kaefe64/Arduino_uSDX_Pico_FFT_Proj/README.md

# ARJAN-5
## 5 Band SSB/AM/CW HF Transceiver
## by Klaus Fensterseifer - PY2KLA
### (based on Arjan te Marvelde / uSDR-pico)

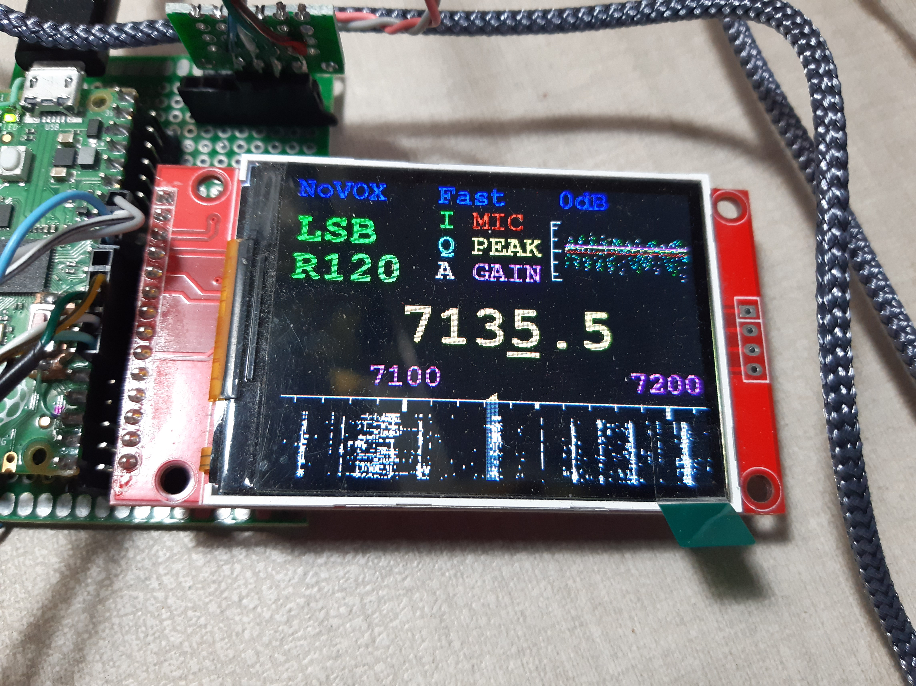
[picture p1: Pictures/Pict1.png]
uSDR-PICO FFT


This project is a Software Defined HF Radio Transceiver (QSD/QSE SDR), 5 Band, Low Power, based on  Arjan te Marvelde / uSDR-pico, from https://github.com/ArjanteMarvelde/uSDR-pico.<br>

My intention was to include a Waterfall/Panadapter to the Arjan's uSDR-Pico project. For this, I included an ILI9341 240x320 2.4" TFT display, without touch, and also, changed the software to generate the Waterfall.

Initially, I used Visual Studio, like the original project, but after some considerations, I ported all code to Arduino IDE. So, to compile and run this code you need the Arduino IDE installed for a Raspberry Pi Pico project (see "Arduino IDE setup and notes:" below).

I also, chose not to change the original software as much as possible, and focused on the Waterfall implementation, mostly in the dsp.c.<br>

I started this project based on Arjan's version https://github.com/ArjanteMarvelde/uSDR-pico/blob/main/package/CODEv2.zip from 2021 with documentation at https://github.com/ArjanteMarvelde/uSDR-pico/blob/main/doc/uSDR%20-%20v2.02.pdf .<br>
<br>

## uSDX project (PE1NNZ)

This project, Arjan-5 and uSDR-Pico **DO NOT USE** the uSDX Amplitude/Phase for transmission like the PE1NNZ uSDX project.

Even so, I adapted the TX modulation code (only TX) using Amplitude/Phase from PE1NNZ uSDX project to run at RP2040. It is a separate code, just for test. See it at uSDX_TX folder.

I used the word "uSDX" instead of "uSDR" to name some files. This was a mistake. My intention was to follow Arjan's project with the same names.
<br>

## Basic connections for initial tests
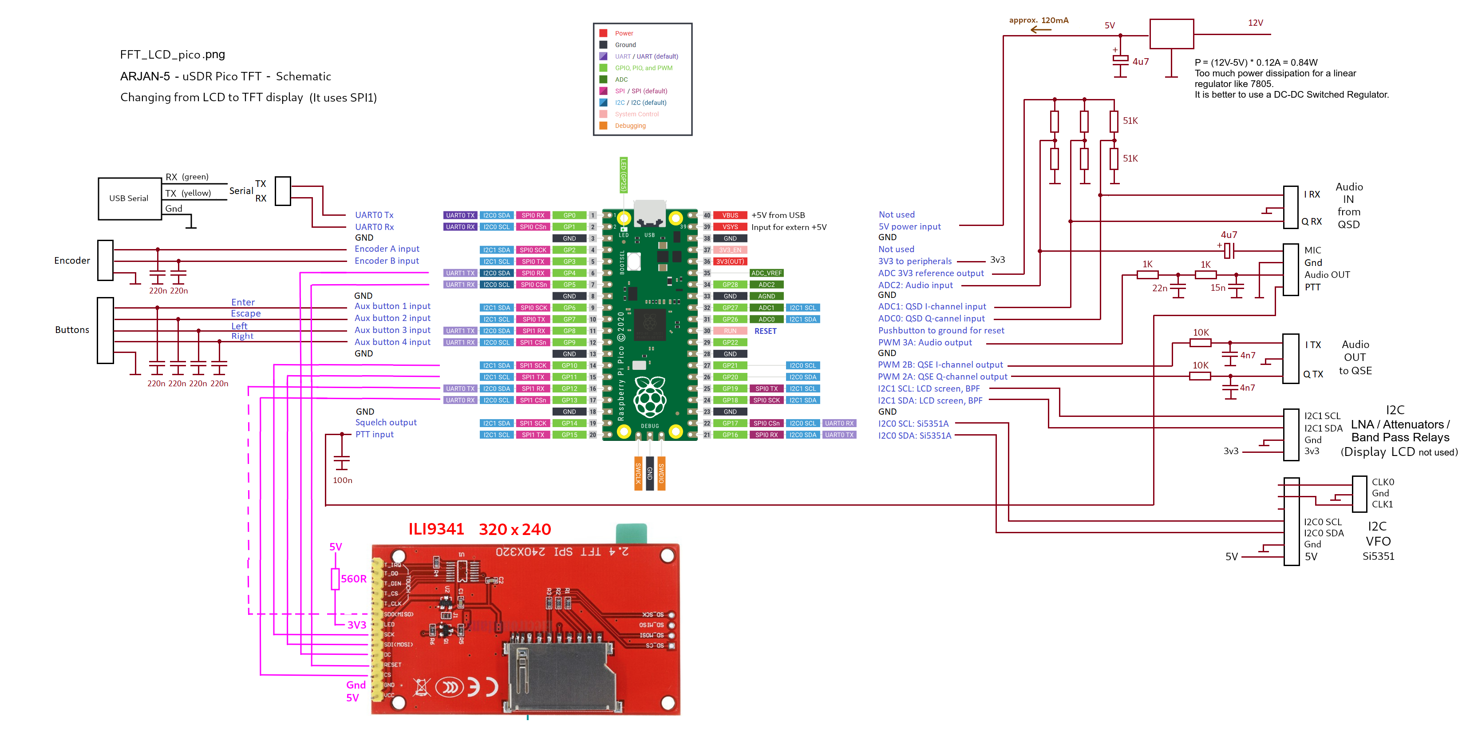
[picture p2: Pictures/FFT_LCD_pico.png]

<br>

Initial tests video:  https://youtu.be/0zGAnkRjizE<br>
AGC and Visual Scope video: https://youtu.be/BiaS002xZfw<br>
Transmission test video: https://drive.google.com/file/d/1Rr4CVPphtcBfMTgRN5z8F7xxByQ_1ybG/view<br>

There are also some messages related to this project at:<br>
https://groups.io/g/ucx<br>
Subject: uSDR-pico on GitHUB<br>
Initial msg: #15923 · May 26  2022<br>
<br>

## Repository folders
**Arduino_I2C_BPF_RX** - Code to control the Band Pass Filter (BPF) board. It runs at Arduino Pro Mini, compiled with Arduino IDE. The Arduino Pro Mini is used replacing the uSDR-Pico I2C interfaces PCF8574's to allow extra features: SWR reading, Eeprom memory and others (future). It uses the same I2C protocol, as uSDR-Pico.<br>
**Arduino_uSDX_Pico_FFT** - Main code for Ajan-5, it runs at Raspberry Pi Pico, compiled with Arduino IDE (look "Arduino IDE setup and notes" below).<br>
**Aux** - Files used as reference.<br>
**PCB** - Schematic and PCB Layout on Kicad format.<br>
**Pictures** - Pictures in general used in this Readme file.<br>
**uSDX_TX** - Code to test RF modulation TX using Amplitude/Phase, the same method used at the PE1NNZ uSDX project (https://github.com/threeme3/usdx) running at RP2040, only for transmission.<br>
<br>
<br>

## Main Board Block Diagram
- Arjan-5 uses the same modules connections as uSDR-pico.

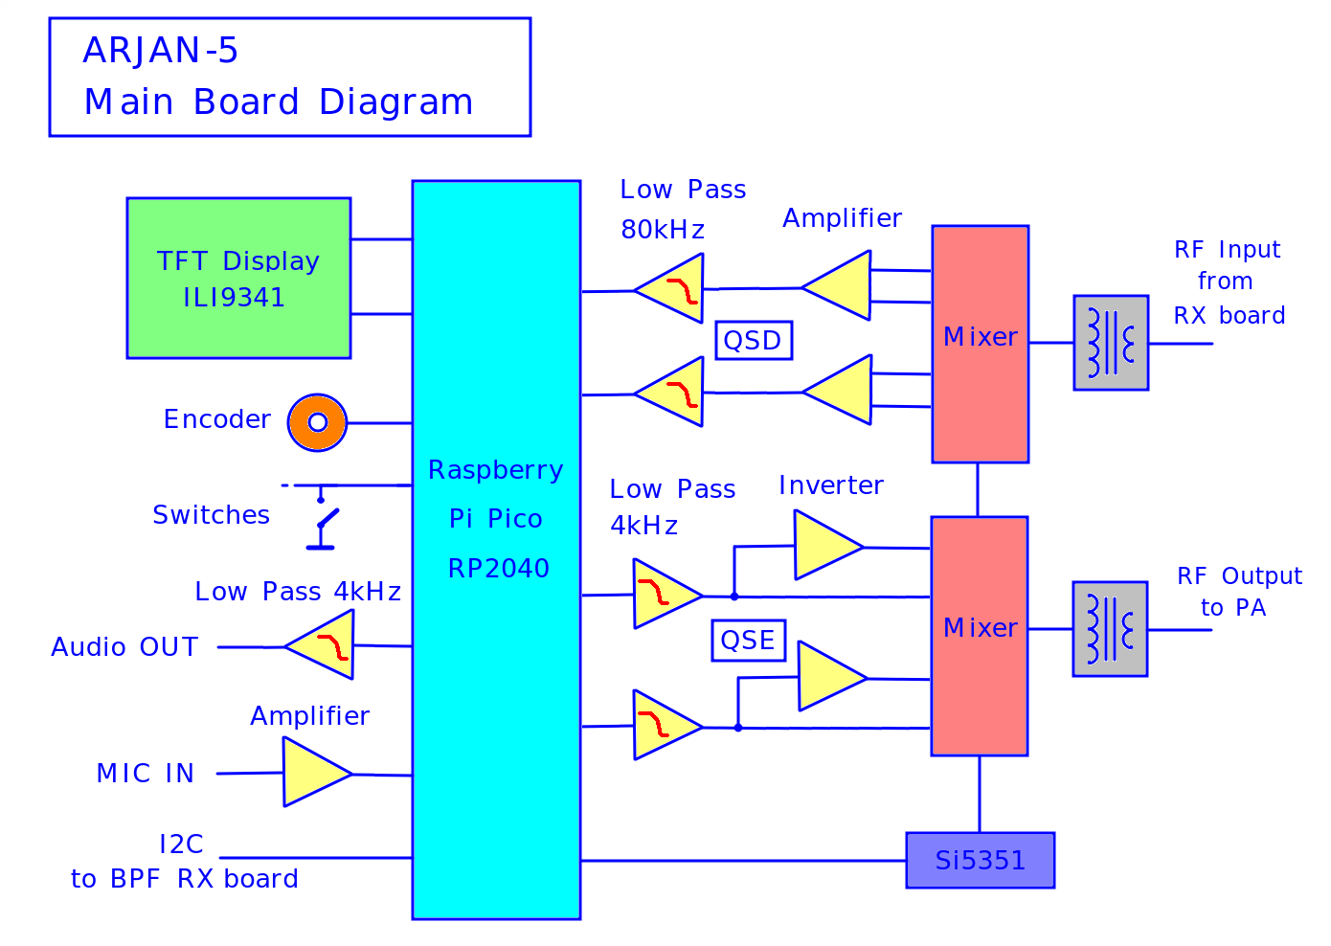
[picture p3: Pictures/Arjan_5_block_diagram.png]
Main Block Diagram

<br>

## Band Pass Filters, Attenuators and Low Noise Amplifier Board Block Diagram
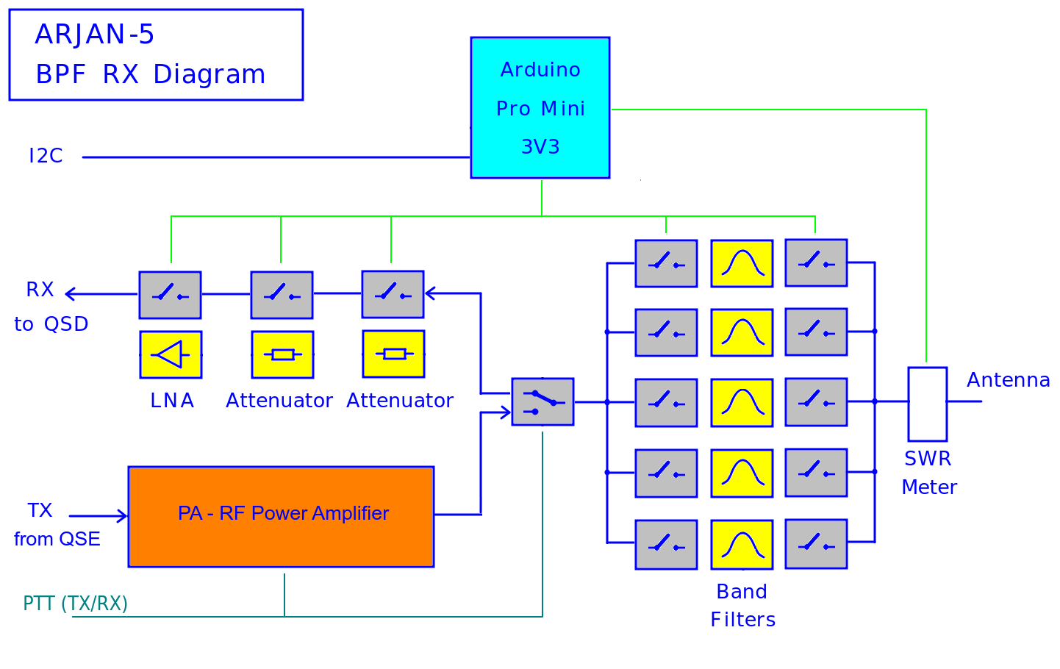
[picture p4: Pictures/Arjan_5_BPF_RX.png]
BPF RX Block Diagram

<br>

## Main Board Top and Botton

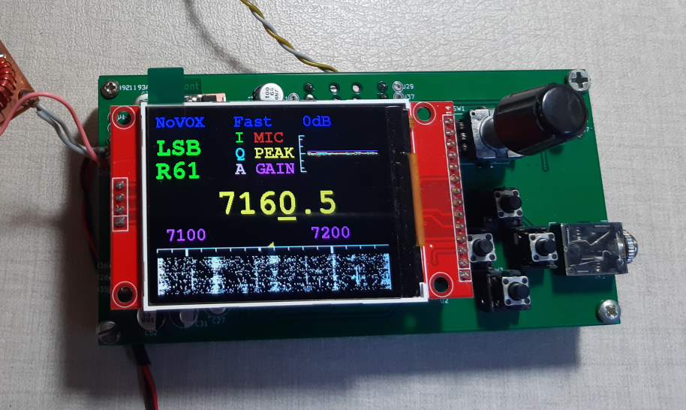
[picture p5: Pictures/uSDR_Pico_FFT_PCB_top.png]
Main Board Top

<br>
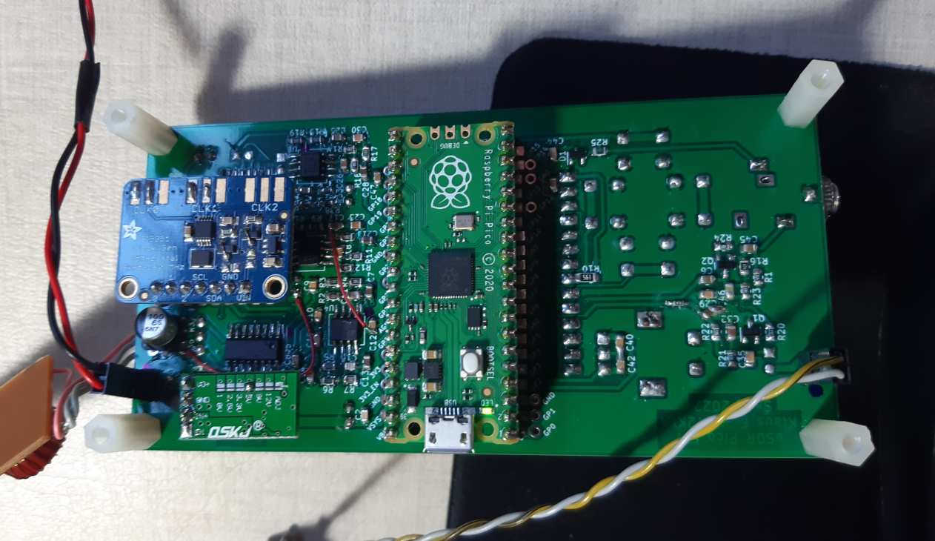
[picture p6: Pictures/uSDR_Pico_FFT_PCB_botton.png]
Main Board Botton

<br>
Obs.: Don't mind the red wires on the PCB, they are only test for separated 5V power supply.
<br>

## First Prototype with TX and RX

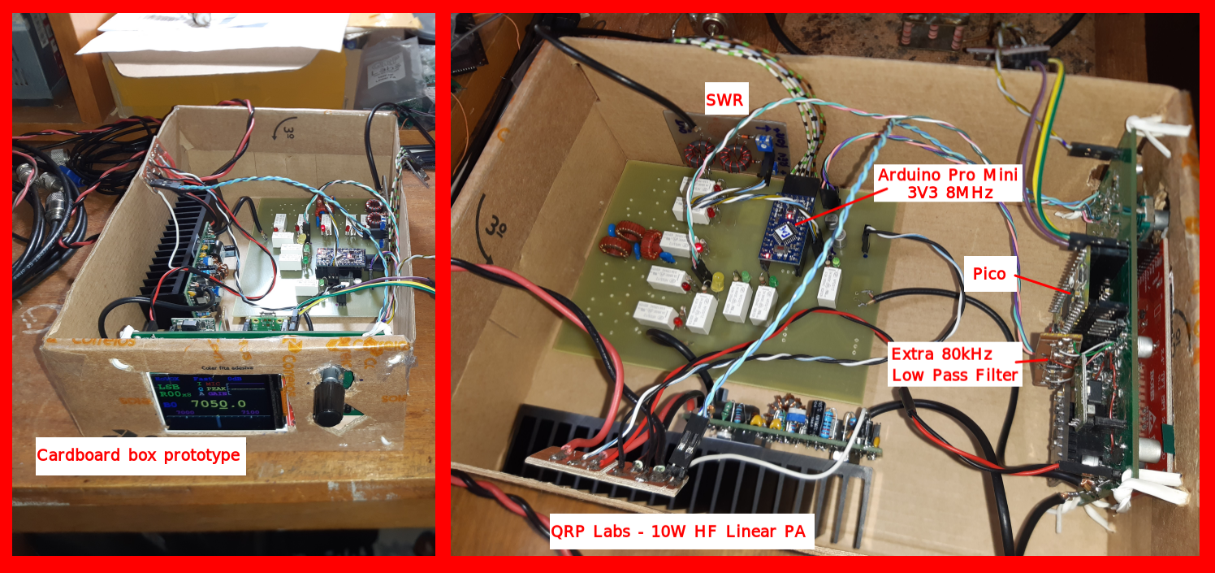
[picture p7: Pictures/Cardboard_box_prototype.png]
Prototype


## Second Prototype (all in a metallic box)

Prototype2

<br>

## Microcontroller RP2040 notes:
- Core0 and Core1 are too much connected and affect each other. This made me lose some painful hours...
- There are only 3 ADC ports available.
- There are some reports at internet about the low quality of the RP2040 ADC readings (https://pico-adc.markomo.me/).

## Hardware changes from the original SDR-Pico and notes:
- I chose to make a main board with the Pico, Display, QSD/QSE and 5V power supply, and another board with the relays, filters and attenuators.
- The main change from SDR-Pico is the inclusion of ILI9341 on Pico free pins, using SPI1, and removing the LCD display.
- We need more frequency range on RX to show at the Waterfall, the RX amplifier must amplify at least 80kHz of signal band. The opamp must be changed to one with wider bandwidth.
- I will use an Arduino Pro Mini to work as two I2C slaves, replacing the PCF8574's on the BPF RX board. This will give more ADCs to read the SWR values.
- You can see the schematic diagram at [uSDR_Pico_FFT_SCH.pdf](PCB/uSDR_Pico_FFT_SCH.pdf) and [uSDR_Pico_BPF_RX_SCH.pdf](PCB/uSDR_Pico_BPF_RX_SCH.pdf).
- I noticed that changing the signal in one ADC input, changed the other inputs signal through the resistors for setting half Vref. To solve this, I changed the circuit to have a separate resistor divider for each ADC input.

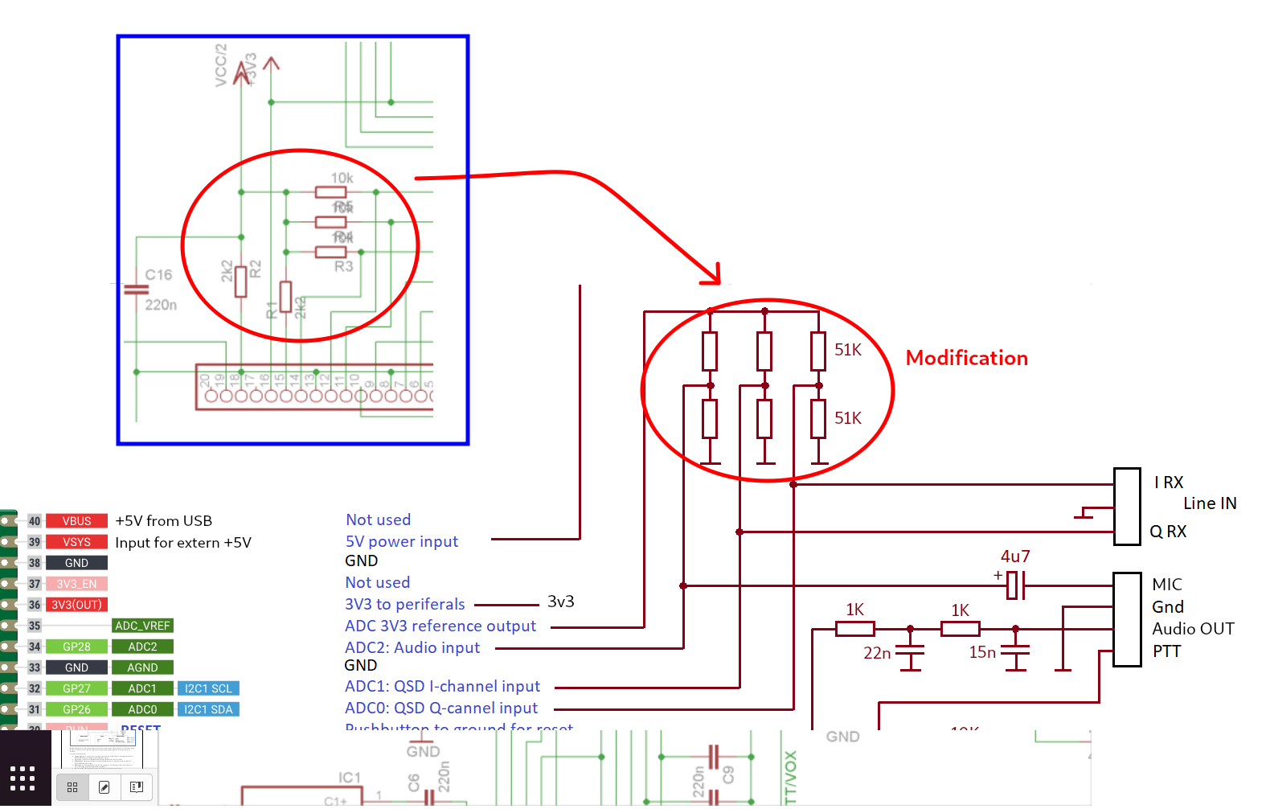
[picture p8: Pictures/FFT_LCD_pico_MOD.png]

<br>

- Use input/output filters for ADC Aliasing considerations (see below). 
- Obs.: at the initial test video, I used only the RC output filter shown in the schematic, and for input filter, only what is already inside of the Softrock RXTX Ensemble.
<br>

## Hardware changes from initial version of my Schematic and PCB:
- Include a reversion VCC connector protection = series diode D2
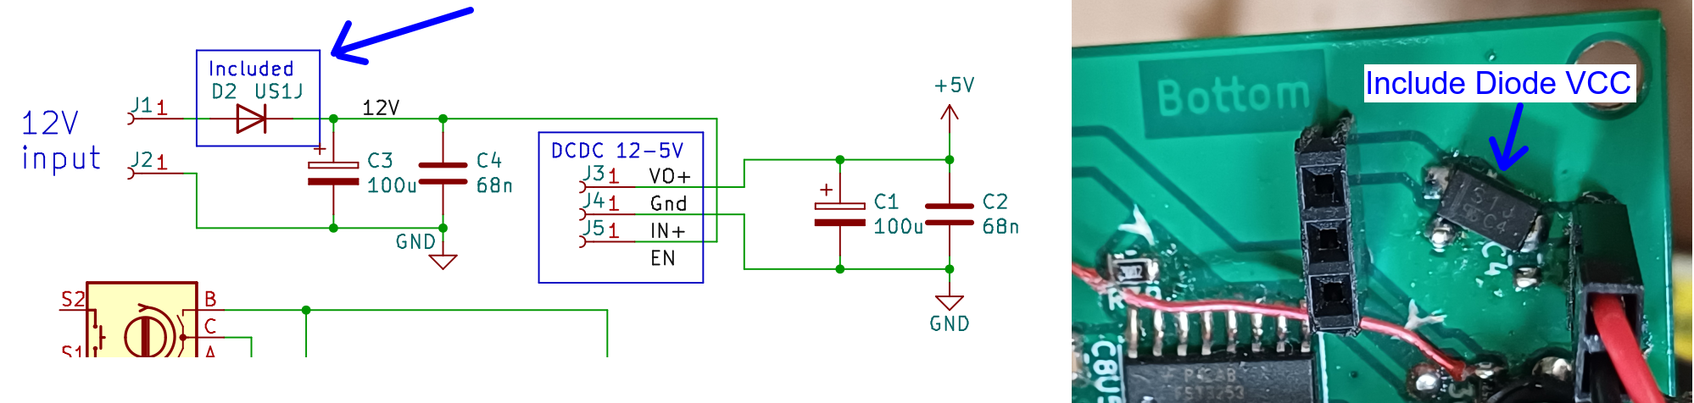
[picture p9: Pictures/Mod_include_diode_Vcc.png]
Diode_VCC


- Include an extra RC to the audio output filter  
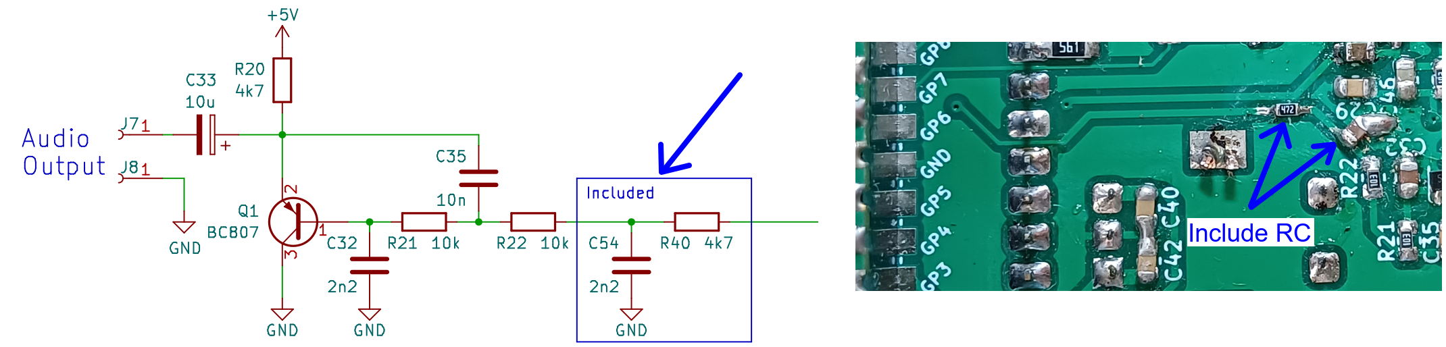
[picture p10: Pictures/Mod_include_RC_audio.png]
RC_audio


- The PTT output signal generated on GPIO15 (pin 20) used to switch the filters and the Power Amplifier needs:  
    A transistor to convert from 3v3 to 12V (2N7002 Q4 on picture).<br>
    Include a 1K resistor (R47 on picture) between GPIO15 (pin 20) and 3V3 (pin 36). The GPIOs on Pico are input with a weak pulldown during reset and this would make it to be like PTT ON and transmit. This 1k resistor pullup will pit the GPIO at high high at reset avoiding transmiting.<br>
    Increase the value of C44 from 1n to 100n, for helping in debouncing the PTT switch.<br>
    Reduce the value of R25 to 10R. This resistor will (try to) limit the current in case of PTT at wrong voltage.<br>
    ** Values changed **, see bellow. <br>
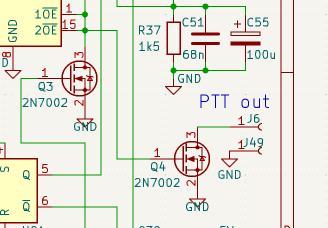
[picture p11: Pictures/PTTout.png]


- Use 5V or 3v3 to power the ILI9341 display depending on your display version.<br>

- Mod Oct04 2026<br>
  Split the PTT signal on PTT_IN and PTT_OUT to allow extra time on CW TX. It will stay on TX for 200ms after the end of CW carrier.<br>
  Increase the resistor R25 on PTT_IN to 470R to protect the input from negative voltage and current.<br>
  Increase the resistor R47 pullup on GPIO15 to 10k to guarantee low level at GPIO15 when PTT = 0.<br>
  Resistor R58 changes to 4k7 to assure the high level after RPI reset.<br>
  Changes marked on blue:<br>
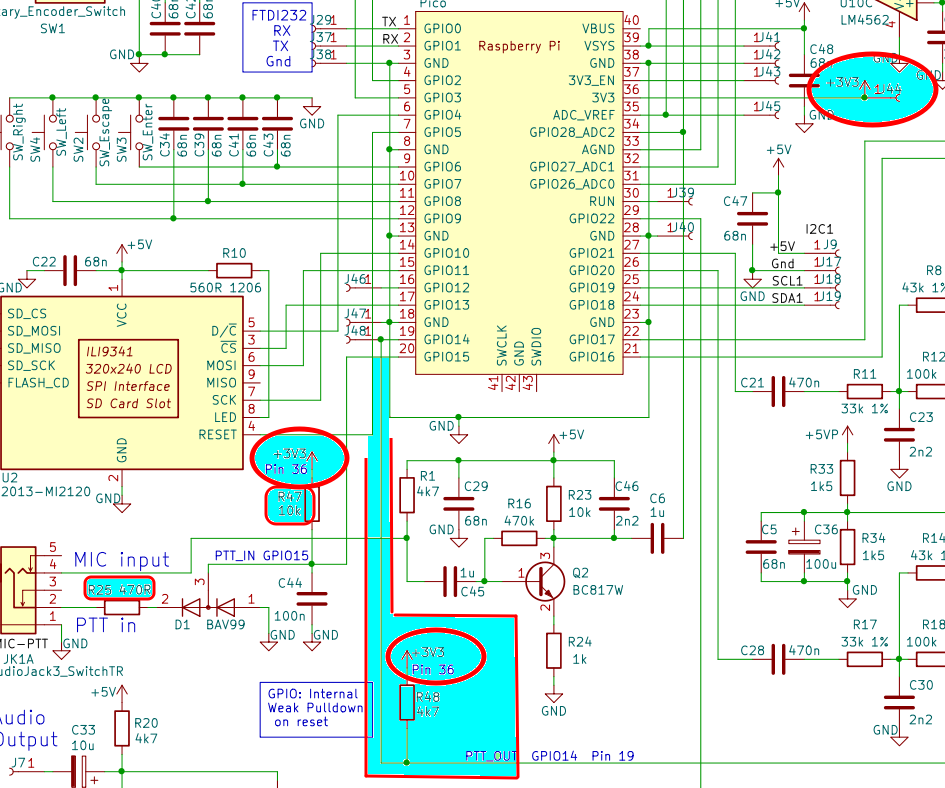
[picture p12: Pictures/PTT_CW.png]

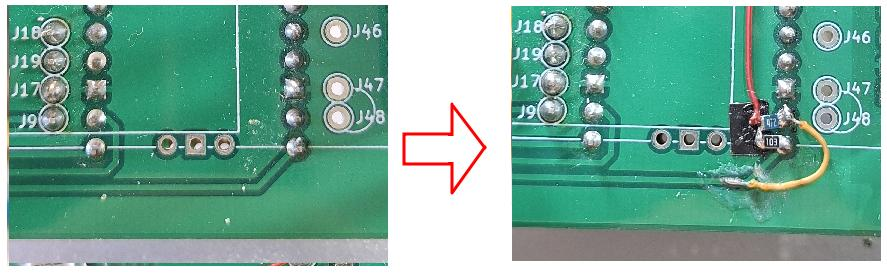
[picture p13: Pictures/PTT_PCB_Mod.jpg]

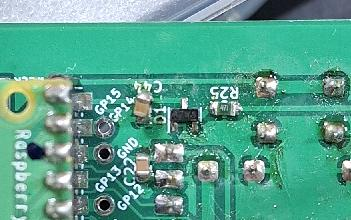
[picture p14: Pictures/PTT_PCB_Mod2.jpg]

<br>
- Mod Oct25 2026<br>
  Changing the MIC amplifier Vcc from 5V to 3V3 to avoid ADC saturation and interference on I/Q ADC.<br>
  I also reduced the MIC audio band frequency to reduce the >8kHz signals with C46 from 2n2 to 4n7.<br>
  
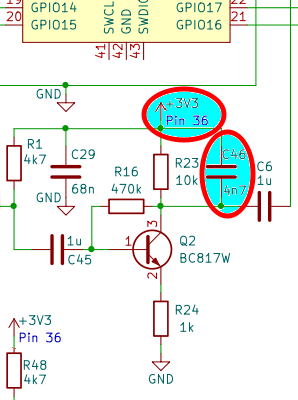
[picture p15: Pictures/MIC_Ampl_Vcc.png]
MIC_ckt


<br>

## Software Notes<br>
### Arduino IDE setup and notes:
- I am using Arduino IDE version 2.3.10 in Linux/Debian
- **IMPORTANT: Use the comments at beginning of  Arduino_uSDX_Pico_FFT.ino  file to "adjust" the library files to the project.**
- Every time I update the library, I need to "adjust" the library files again.
- Use Boards Manager: "Raspberry Pi Pico/RP2040/RP2350" by Earle F. Philhower III
- (old: ~~Boards Manager:  Arduino Mbed OS RP2040 Boards. My version is 4.0.2~~ - no longer used)
- (old: ~~Do not include EarlePhilhower library (it is conflitant with Mbed)~~ - now it uses EarlePhilhower library)
- Board: "Raspberry Pi Pico"  >  Raspbery Pi Pico/RP2040/RP2350  >  Raspberry Pi Pico
- (old: ~~Board: "RaspberryPiPico"  >  Arduino Mbed OS RP2040 Boards  >  RaspberryPiPico~~ - no longer used)
- Lib used: TFT_eSPI by Bodmer
- The code files have cpp type, but the code itself is in C (cpp type is used to help in some compiler issues).

### To implement the Waterfall I considered this:

- There are 3 ADC inputs: I, Q and MIC  (if we remove the VOX function, we could remove the MIC ADC during reception, this will increase the ADC frequency for I and Q, improving the frequencies we can see at the display,or we can increase the >80kHz signal filter rejection - for now I will keep it like the original).
- The max ADC frequency is 500kHz, I have changed it to 480kHz (close to the original) to make the divisions "rounded".
- The ADC for audio reception has frequency of 16kHz (close to the original). I have tested higher frequencies, but the time became critical, without so much benefit.
- The max ADC frequency for each sample = 480kHz / 3 = 160kHz   (because there is only one internal ADC used to read the 3 inputs in sequence).
- With 160kHz of samples, we can see 80kHz range after the FFT, but applying Hilbert to get the lower and the upper band, we get two bands of 80kHz, above and below the center frequency.
- There is no time to process each sample at 160kHz and generate the "live" audio, so I use this method:
    Set the DMA to receive 10 samples of each ADC input (10 x 3 = 30) and generate an interrupt.
    So, we get 16kHz interrupts with 10 x 3 samples to deal.<br>
    For audio, we need only one sample at each interruption of 16kHz. At this point, there is a low pass filter to remove any frequency above 8kHz.<br>
    For FFT, we need all samples (raw samples), so they are copied to a FFT buffer for later use.
- There is also no time to process the samples and run the audio receiver part at 16kHz, so I chose to split it. The interrupt and buffer/filter part is done at Core1, and the audio original reception is in the Core0.
- Every 16kHz interrupt, after filtering the I, Q and MIC, these samples are passed to Core0 to follow the audio reception tasks.
- For the Waterfall, when we have received 320 I and Q samples, it stops filling the buffer and indicates to the Core1 main loop to process FFT/Hilbert for a new graphic line.
- The original processes run at Core0, every 100ms.
- There is a digital low pass filter FIR implemented at the code (like the original) that will give the passband we want for audio.
  This filter was calculated with the help of this site:  http://t-filter.engineerjs.com/
  The dificulty is that the number of filter taps can not be high (there is no much time to process it), so the filter must be chosen carefully.
- Please consider that this Waterfall is not perfect, I had to let go of some rules to make it.
- Software Block diagram at "Arduino_uSDR_Pico_FFT.png":

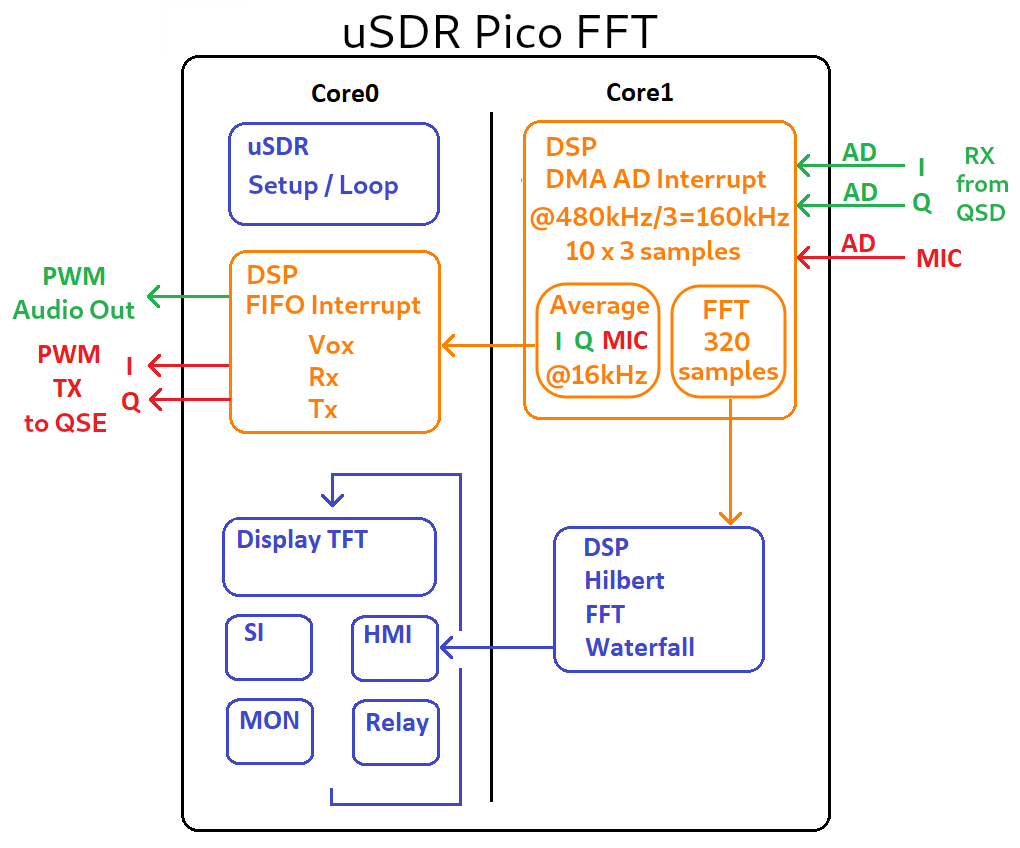
[picture p16: Pictures/Arduino_uSDR_Pico_FFT.png]
Block diagram


### ADC Aliasing filter considerations:
**Input:** We sample each signal I, Q and MIC at 160kHz, so it is necessary to have a hardware low pass filter for 80kHz on each input (anti-aliasing filter). If the input filter is set to lower than 80kHz, the Waterfall will show less than +-80kHz of signals. If the input filter is set to higher then 80kHz, the audio and the Waterfall could peek some signals greater than 80kHz and treat them as lower than 80kHz (this is the ADC aliasing problem).<br>
**Output:** We deliver an audio signal at 16kHz sample frequency, so we need a hardware low pass filter for less than 8kHz at the output. The sample frequency will be present and needs to be removed as it is also an audio frequency.

<br>
<br>

## Operational Notes<br>
### Keys description<br>
**Normal operation:**<br>
Encoder (dial) = to change the frequency at the cursor position<br>
Left key = move the cursor to left. We can select the memory position using the Encoder while holding the Left key.<br>
Right key = move the cursor to right<br>
Enter key = We can adjust the Waterfall gain with the Encoder while holding the Enter key.<br>
Escape key = to enter on menu mode<br>
**Menu mode:**<br>
Escape key = to go back to normal operation<br>
Left key = to move between the menu items<br>
Right key = to move between the menu items<br>
Encoder (dial) = to change menu item value<br>
Enter key = to confirm the menu item value<br>
<br>
<br>
<br>

## Application Menu Description<br>

The menu uses the first line on display to show the status and the options.<br><br>

### Menu TUNE:<br>
Menu position used operate the radio on normal condition. It shows the actual values for the menus: Mode, VOX, AGC and Pre.<br>

### Menu Mode:<br>
Options: "USB","LSB","AM","CW"<br>
Define the modulation mode used for transmition and reception.<br>
On CW mode, you can help the CW decoder adjusting the wpm manually using the right button when turning the dial.

### Menu AGC:<br>
Options:  "NoAGC","Slow","Fast"<br>
Define the Automatic Gain Control mode of actuation. (It needs improvement)<br>

### Menu Pre:<br>
Options:  "-30dB","-20dB","-10dB","0dB","+10dB"<br>
Define the use of the attenuators and pre-amplifier on reception. It uses the relay board to switch between the options.<br>

### Menu VOX:<br>
Options:  "NoVOX","VOX-L","VOX-M","VOX-H"<br>
Defines de use of the VOX feature. (It needs improvement)<br>

### Menu Band:<br>
Options:  "<2.5","2-6","5-12","10-24","20-40"  MHz<br>
Defines the filter used for RX and TX, and consequently the frequency band. It uses the relay board to switch between the options.<br>

### Menu Memory save:<br>
Options:  "00" to "15"<br>
It saves the actual setup on the Arduino Pro Mini Eeprom through I2C, in one of the 16 memory positions.
To recover the data from memory, you need to keep pressed the left button when turning the dial.
After power on, it will start with the memory 00 saved. 
Unsaved memory will recover a default setup.

### Menu Audio:<br>
Options:  "Rec from TX", "Rec from RX", "Play to TX", "Play to Speaker"<br>
It enables to store 10s max. of audio from the RX or TX (= microphone), and also play it to speaker or to TX.<br>
It starts to save/play when pressing < Enter >, and will stop after 10s or when pressing < Escape >.<br>

<br>
<br>
<br>

## Last changes and notes:<br>

### Oct25 2026
- Including colors to waterfall.
- I made some tests and corrections to CW decoder. It is possible to adjust the wpm manually to help it to start decode. Use the "right" button when turning the dial.
- Another hardware change: the MIC sound is affecting the I and Q ADC inputs due to MIC ADC saturation. I am changing the MIC amplifier Vcc from 5V to 3V3 to avoid this ADC saturation. See hardware changes topic above.

### Oct04 2026
- Including a CW TX transmission delay. It keeps the relays in TX mode between the CW dits and dahs. It waits 200ms after the end of the CW signal before switching back to RX.<br>
  The 200ms delay is defined with the TX_ENABLED_EXTRA_CNT constant.<br>
- ** Important ** <br>
  Some hardware changes are required for this software version due to the CW TX delay:<br>
  GPIO14 pin 19 will be the output to command the RX/TX on mainboard and the PTT_OUT to the BPF RX board.<br>
  GPIO14 will need a pull-up resistor due to the RP2040 internal weak pulldown after reset, that could put the Arjan on TX during reset.<br>
  Resistor R25 on PTT_IN will be increased to 470R to protect the input from negative voltage and current.<br>
  Resistor R47 pullup on GPIO15 needs to be increased to 10k due to the R25 470R and guarantee low level on GPIO15 when PTT = 0.<br>
  The debounce time for PTT input switch with new values:<br>
  RX to TX = aprox. R25*C44 = 470R * 100n = 47us (should be improved)<br>
  TX to RX = aprox. R47*C44 = 10k *100n = 1ms<br>
  The best would be to improve this PTT input circuit for better RC debounce adjust. Maybe on future changes...<br>
  GPIO15 will be always input = GP_PTT_IN<br>
  GPIO14 will be always output = GP_PTT_OUT<br>
  See ptt_cw.png on Pictures folder or above on Hardware changes.<br>
- Improving and correcting the CW decoder procedure (with the help of OpenCode AI). It still needs testing.

### Aug23 2026
- Converting the code to use Earle Philhower library instead of the MBED.<br>
  It will be better for possible use of RP2350 on future.<br>
  Please make a backup of your actual code before using and testing this code. It is hard to test everything.<br>
  Look again at "Software Notes" for the new Earle Philhower Library procedure.<br>
- Correcting the ADC sample rate. It was 15,841.58Hz and should be 16kHz.
- It shows the number of memories read from EEPROM on the title screen. Just a number on the right of the version.

### Feb16 2026
- Correcting reading the memories after power on. It was reading during Pro Mini setup (switching relays) and it got no data from eeprom. Now it is ok.<br>
- Correcting the S-Meter, it was "blank" on first blocks when changing memories.

### Jan29 2026
- I changed the memory feature in this way: if I am in one memory, ex. 01, changed the values, frequency,band... and save to another memory, ex. 05, the Arjan will save the data to memory 05 and move to memory 05, and also reload from eeprom the memory 01. Memory 01 will have the original values. <br>
- I cannot get the x16 empty issue again (see Issues). I believe it is solved.
 
### Jan18 2026
- I changed the default frequency when changing the band. <br>
 
### Jan4 2026
- I changed the save memory feature from Pico DFLASH to Pro Mini Eeprom, and included a 16 positions memory saving setup instead of only saving band. From now on, the Arduino Pro Mini is required to be present. To update to this version, you need also to update the software on Pro Mini.<br>
- My display burned out and I suspected it should be powered with 3v3 instead of 5v, but it has a built-in 5v to 3v3 regulator (U2 marked as 662K = XC6206P332MR), so it burned out for unknown reasons (I commented on this in a closed issue in the Issues tab).

### Dec25 2024
- Correcting component values on schematic: R28=51K, R4=5K1 1% and U9=74AC74
- Including Eeprom write/read I2C commands on Arduino_I2C_BPF_RX (Arduino Pro Mini) to be used to save the band data to Eeprom instead of Pico Data Flash.<br>

### Nov25 2024
- Improving the CW Morse Decoder. It is still under test (well... all features are always under test).<br>

### Oct28 2024
- Including a CW Morse Decoder. It will try to interpret the CW sound and translate it to letters on display. To enable the decoder you just need to select CW on MODE menu and tune to the highest sound level CW reception. It is under tests (I notice some issues with the CW filter).<br>

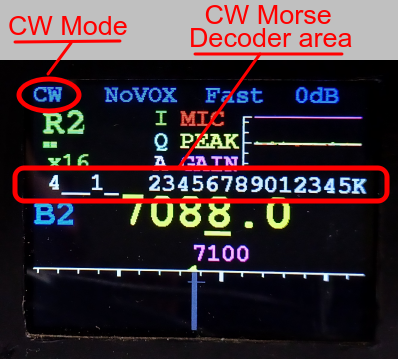
[picture p17: Pictures/CwDecoder_display_area.png]
Display SWR Power

<br>

### Oct23 2024
- New changes related to RX S-Meter and TX Power/SWR on display. The TX Power/SWR is valid only when using Arduino Pro Mini to control the filter relays. Arduino Pro Mini allows to measure the Forward and Reverse values from SWR board. The Pico has no extra ADC for this. I included the values read from SWR board on display.<br>

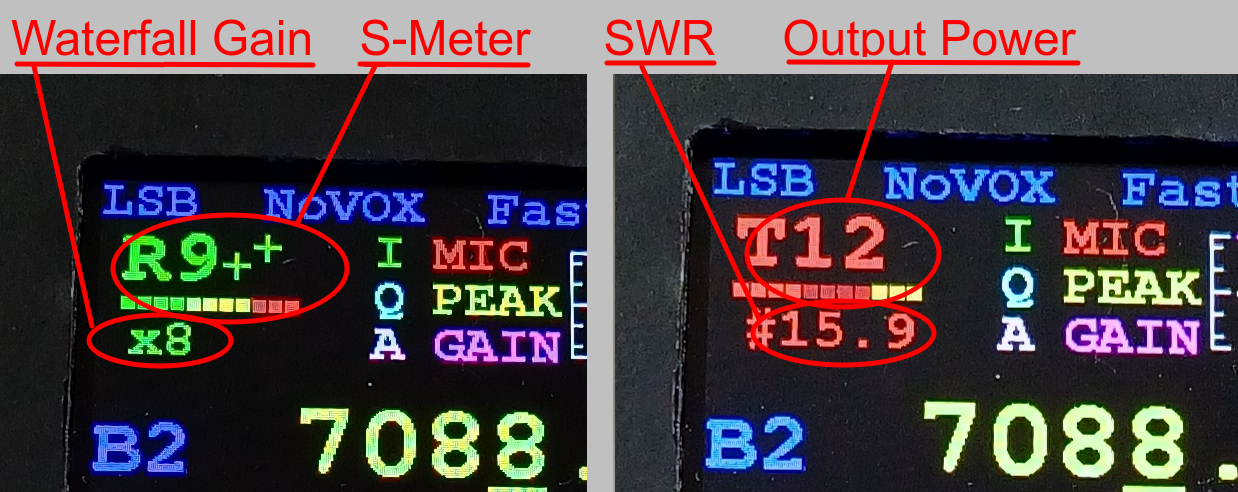
[picture p18: Pictures/Display_SWR_Power.png]
Display SWR Power

<br>

- There is a <br>
 #define I2C_Arduino_Pro_Mini  1    //=1 when I2C BPF and Atten is commanded with Arduino Pro Mini (allow SWR reading)<br>
on relay.h to define if the Arduino Pro Mini is part of the project.<br>
- There is a table swr_pow[] on hmi.cpp to make the correlation from the ADC forward power measured and the value shown on the display.<br>
- There is a table Smeter_table_level[] on hmi.cpp to make the correlation from the ADC I and Q audio level measured and the value shown on the display.<br>
- Corrections on Arduino Pro Mini I2C routines.<br>
- I included here a short description of the menus: "Application Menu Description".<br>
- Just to remember, there is a "Discussions" folder on the Github Project site (look above) to allow comments about the project, as the ucx groups.io forum could not be the right place for it.<br>
(https://github.com/kaefe64/Arduino_uSDX_Pico_FFT_Proj/discussions)<br>

### Ago20 2024
- It will move the Waterfall in block (all lines) when changing the frequency (instead of moving only the last line received).<br>

### Ago03 2024
- S Meter corrections.<br>

### Jul29 2024
- S Meter implementation.<br>
  Starting tests with a S Meter and Bar Graph.<br>
  There is a table (Smeter_table_level[]) to make the correspondence between the audio level and the S meter level.<br>
  The values on the code are **not calibrated**. To get the audio level on the display, to make your own calibration, uncomment this line :   //#define   SMETER_TEST   10    on "hmi.h".<br>

### Jan05 2024
- Correcting internal PTT activation from Monitor and Vox.<br>
  There are some necessary hardware changes to be made:<br>
    Include a 1K resistor between GPIO15 (pin 20) and 3V3 (pin 36).<br>
    Increase the value of C44 from 1n to 100n.<br>
    Reduce the value of R25 to 10R.
- New functions on menu **to record and play the audio** from reception(RX) or transmission(TX) (max. 10s)

### Nov12 2023
- Correcting Arjan's name.
- Switching the PTT pin when TX in VOX mode.

### Oct13 2023
- Now, each band has its own setup, including last frequency used. When changing bands, it will remember the last menu options for each band.
- Included new menu option to save the band setup on Data Flash (non volatile memory), including the frequency. The menu Save will save the actual band and frequency to DFlash. The last band saved will be the one selected after power on.
- Changed the transceiver name to ARJAN-5 (I hope everyone agrees... the name uSDR Pico brings to misunderstandings in my opinion).

### Jul19 2023
- Changing uSDR_Pico_BPF_RX_SCH.pdf and PCB due to Relay HFD3 characteristics.

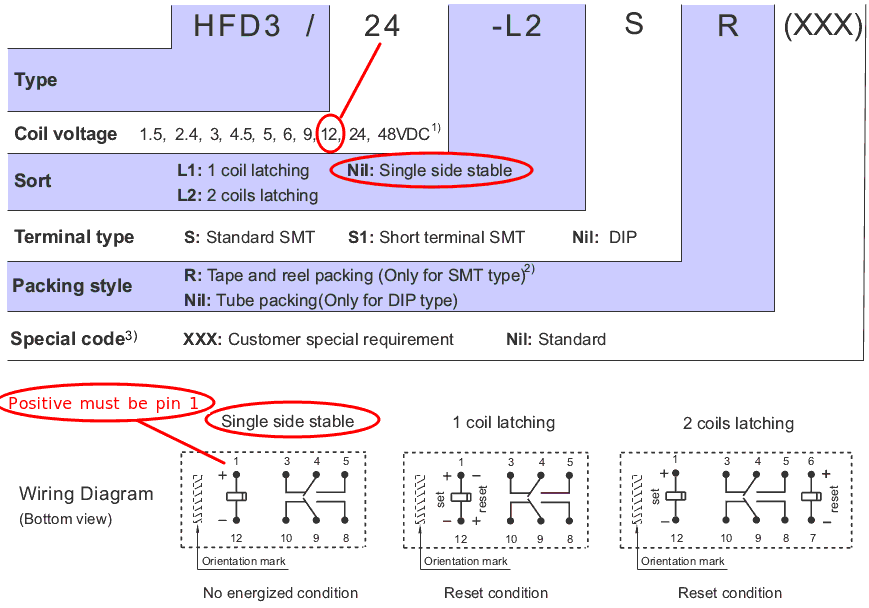
[picture p19: Pictures/HFD3_characteristics.png]
PCB assembly top


- Changing the components value on schematic to be the same as my assembly.

- Including my Kicad PCBs layout as ZIP file (I can not give much support on this, use at your risk).

### Jul16 2023
- Changing the 16kHz low pass filter from average sum of samples to a strong lp FIR. Due to I could hear strong stations away multiples of 16kHz.
- Including the Band selection on screen in blue (ex. B0 = Band 0).
- Adjusting the position on screen for receive level and manual gain (ex. R30x12).
Obs.: to use manual gain adjust, press Enter button and turn the frequncy knob.

### Jun2 2023
- Testing an 80KHz Low Pass Filter for I and Q inputs because I can hear some frequency distant strong stations.
- New schematics and PCB for LPF and RX at the same board.
- Added software for Arduino Pro Mini to work as two I2C slaves, replacing the PCF8574's.
- There are some mirror signal at the Waterfall, I am looking for the reason.
- I really like the quality of the audio received.

### Apr30 2023
- Included an adjust to the gain in the Waterfall, it helps to reduce the noise in the Waterfall. Press and keep the Enter button, and turn the frequency knob. This adjust also affects the audio AGC.

### Apr29 2023
- Minor changes, improve comments at .ino file. Trying to get the new PCB running and getting back to software improvement.

### Ago17 2022
- Included sketch folder uSDX_TX to test the Phase and Amplitude TX method.

### Ago07 2022
- PTT input corrected. Now it uses the falling or rising to turn off and on the PTT.
- Including options for encoder at hmi.cpp:  ENCODER_TYPE  ENCODER_DIRECTION

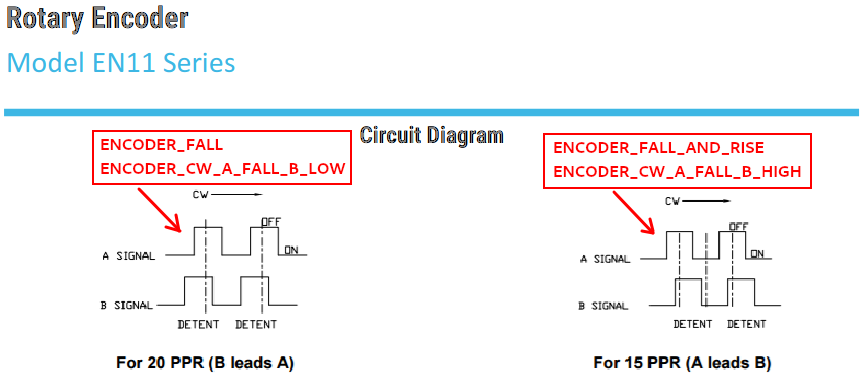
[picture p20: Pictures/Encoder_selection.png]
Encoder type


### Ago05 2022
- Now the frequency changes at each encoder step (I am using EC11 encoder and it changed the frequency at every second step)
- Plot to the Waterfall improved to spend less time
- Included separate audio filters for CW and AM
- Included side tone for CW TX
- Writing to display and programming Si5351 only when necessary (finally)
- PTT debounce reduced to allow CW TX (** it needs a 100nF capacitor from PTT pin to ground **)

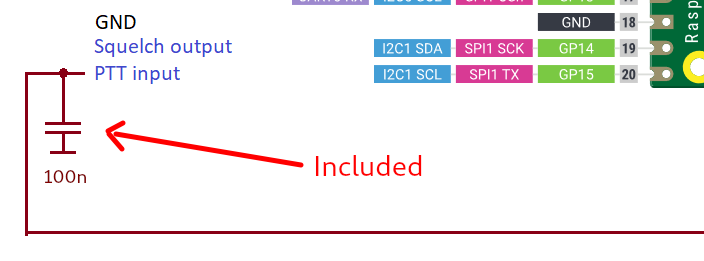
[picture p21: Pictures/FFT_LCD_pico_MOD2.png]

<br>

### Jul20 2022
- Waterfall: Changed to fall instead of going up
- Waterfall: Frequency scale moving with main frequency
- Waterfall: Shadow indicating the reception zone
- AGC attack faster
- It shows the reception signal level implemented from audio output and gain

### Jun24 2022
- Few display corrections: central triangle, mode text overwriting.

### Jun13 2022
- 3V3 noise sensitivity test:<br>
I followed the tips in this post
https://forums.raspberrypi.com/viewtopic.php?t=330208<br>
It says that a power supply with less noise to Vref is the best for reducing the ADC noise.<br>
I used a 3V3 linear regulator instead of the Pico on board DC-DC 3v3.<br>
I connected it externally, in pins VSYS, GND, 3v3_EN and 3V3.<br>
Connecting 3v3_EN to Gnd disables the on board DC-DC 3v3.<br>
I used a TPS79933 + caps from VSYS to 3V3 pin.<br>
I can connect and disconnect it easily.<br>
The first impression is that this does not improve the sensibility.<br>
I have found a limit position from RF generator to Softrock receiver to start showing something at the Waterfall.
And both DC-DC and TPS look the same to me.

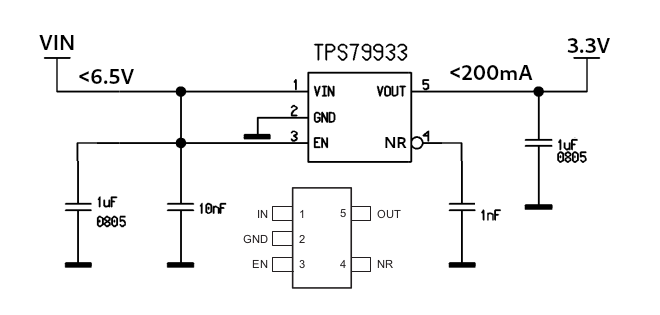
[picture p22: Pictures/VREF_TPS79933_AXX.png]
Reg 3v3


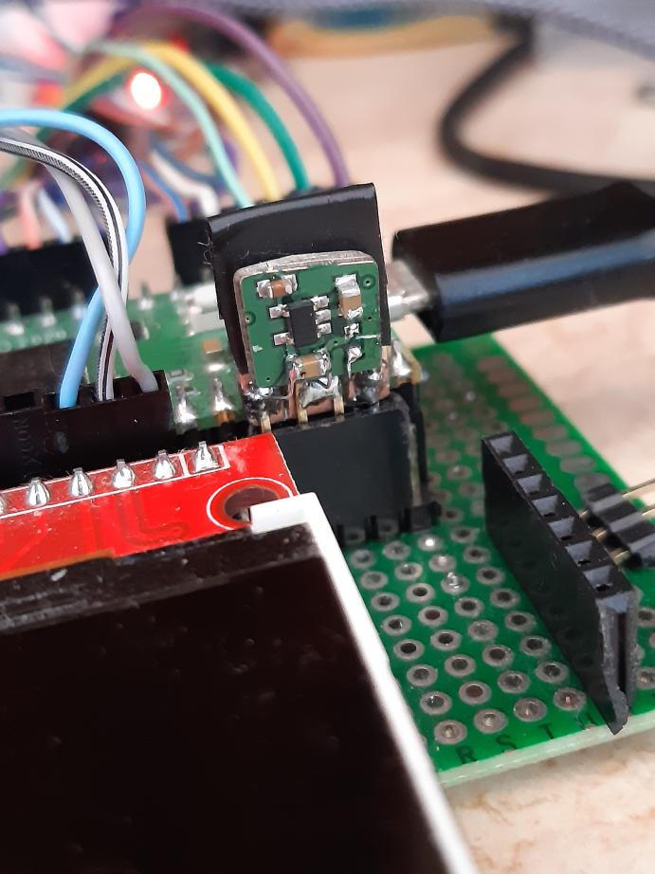
[picture p23: Pictures/Reg_monted.jpg]
Reg mounted


### Jun10 2022
- AGC uncommented and adapted to work.<br>
	 The AGC is only used at the output audio, not for Waterfall.
- A visual scope was implemented to allow visualization of some internal variables.<br>
	 The variables plotted are:<br>
	 - I, Q and MIC = ADC inputs<br>
	 - A = output audio<br>
	 - PEAK = average of absolute(A)<br>
	 This gives an input signal level for AGC (min in the middle of the scope height, max at the top)<br>
	 - GAIN = AGC result. <br>
	 If the PEAK is high for some time, it decreases the GAIN. With PEAK low, increases GAIN.<br>
	 Gain has 32 steps:<br>
	 1 = min AGC gain (almost in the middle of the scope height)  <br>
	 32 = max AGC gain (limited to 25 at the top of scope)<br>
	 - Obs.: Scope limits:    -25 < y < 25       0 < x < 100 (each 'x' dot time = 1/16kHz)<br>
	 - Obs.: Variables are scaled to fit in the scope height.
- The signal level meter at the display does not change because it is fixed at the original code (the level depends on the software as well as the hardware).<br>

## Wish list:
- Include RIT (receiver incremental tuning)
- Reduce the minimum step to change the frequency to 50Hz or less
- Tests: reception/transmission modes, bands, menus, ...

## Copyright notice
**The code and electronic designs as well as the implementations presented in this repository can be copied and modified freely, for non-commercial use.
Use for commercial purposes is allowed as well, as long as a reference to this repository is included in the product.**
