kaefe64/Arduino_uSDX_Pico_FFT_Proj/PCB/SWR/SWR_SCH.pdf

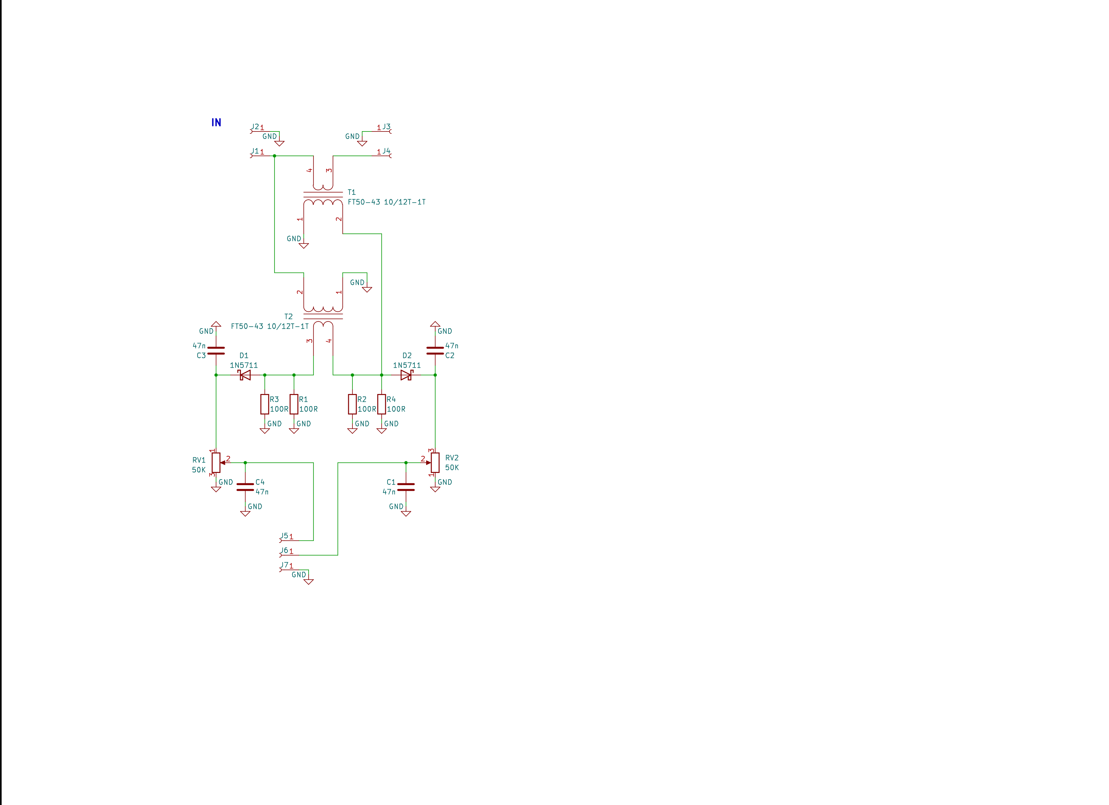
[picture p24: page 1]
