kaefe64/Arduino_uSDX_Pico_FFT_Proj/Arduino_I2C_BPF_RX/Extra/SWR_sch.png

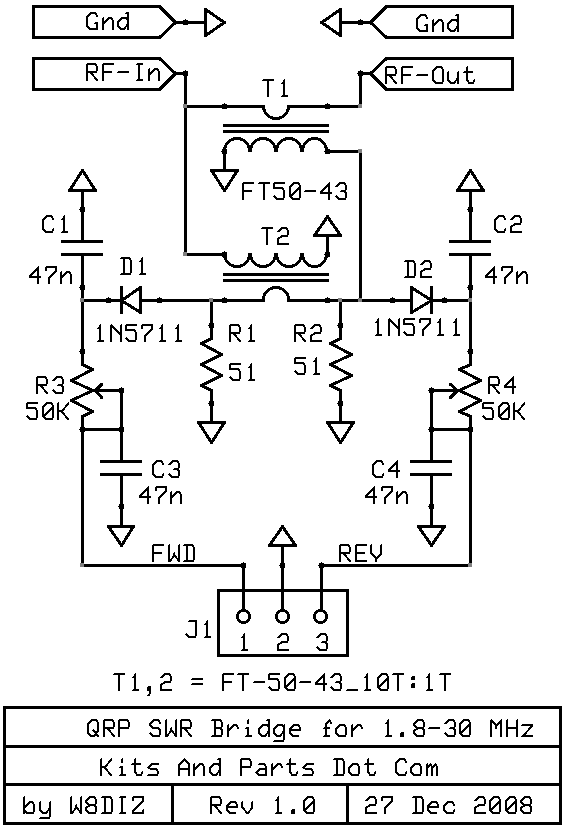
Arduino_I2C_BPF_RX/Extra/SWR_sch.png
