kaefe64/Arduino_uSDX_Pico_FFT_Proj/Aux/Components/TEA2025_pinout.png

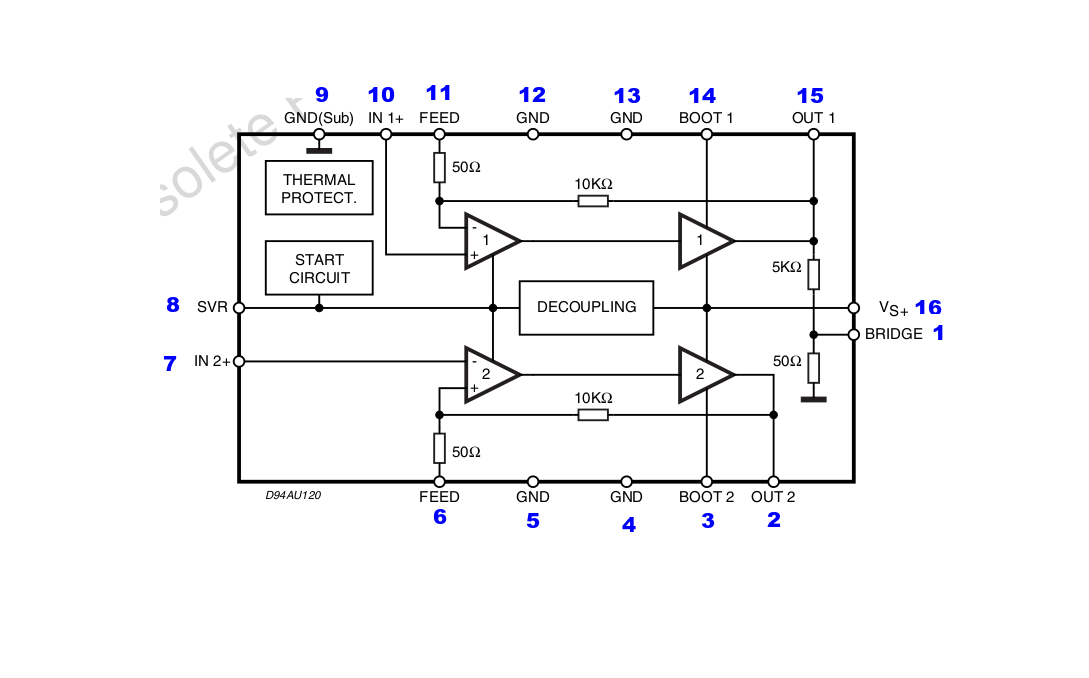
Aux/Components/TEA2025_pinout.png
