kaefe64/Arduino_uSDX_Pico_FFT_Proj/Aux/Components/LM386_amplifier.png

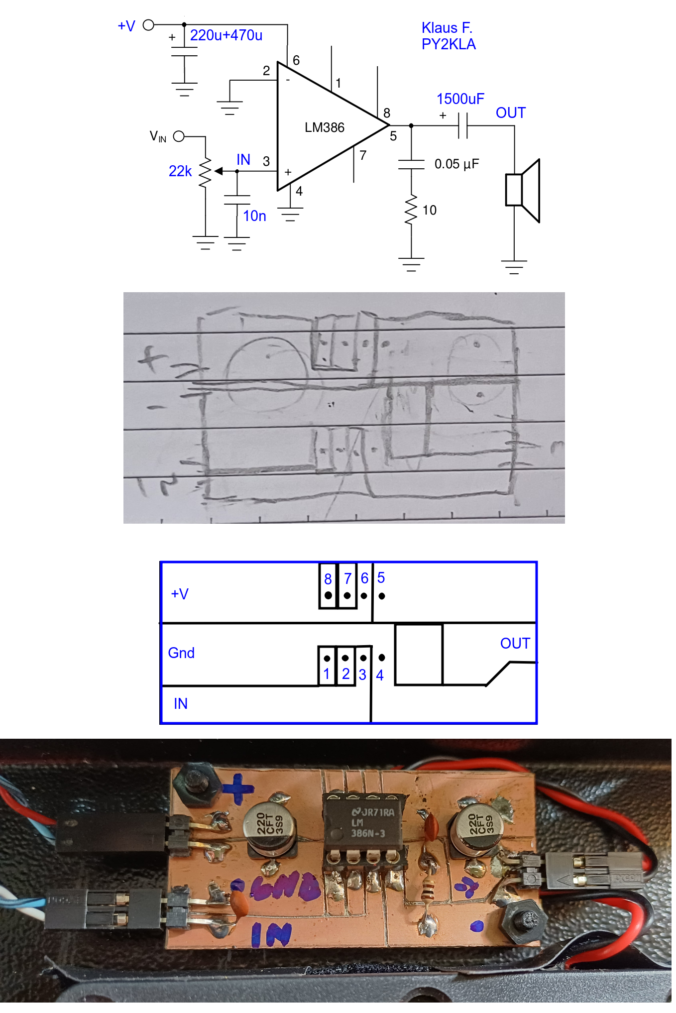
Aux/Components/LM386_amplifier.png
