kaefe64/Arduino_uSDX_Pico_FFT_Proj/Aux/Components/MP2315_DCDC.png

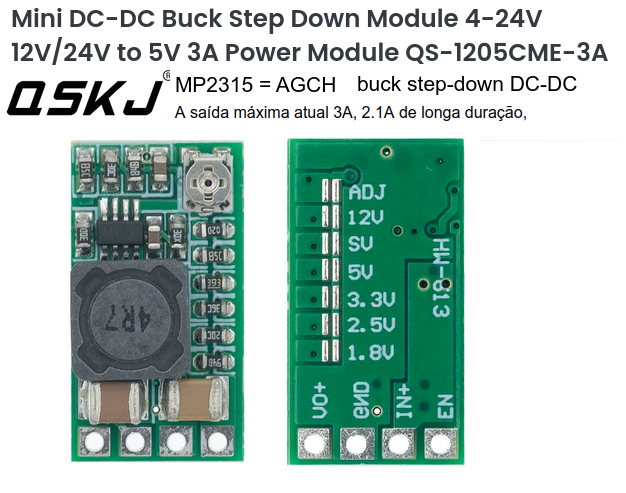
Aux/Components/MP2315_DCDC.png
