kaefe64/Arduino_uSDX_Pico_FFT_Proj/Aux/Components/RP2040_YD2040_comparison.png

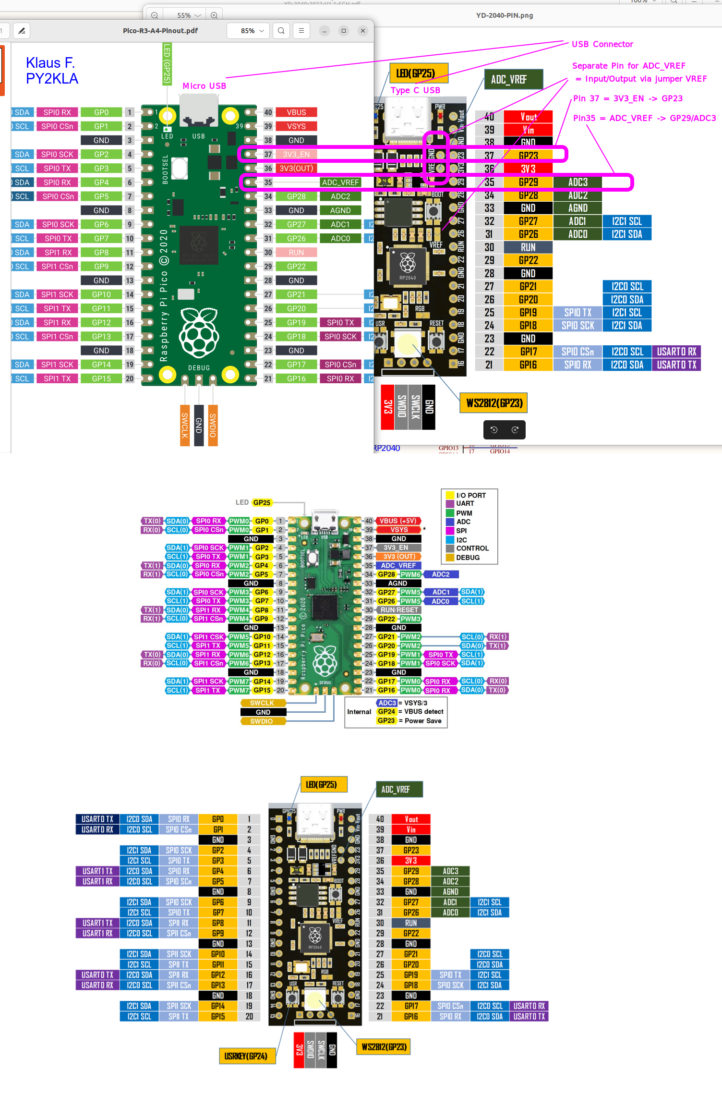
Aux/Components/RP2040_YD2040_comparison.png
