kaefe64/Arduino_uSDX_Pico_FFT_Proj/Aux/Components/TEA2025_pcb.png

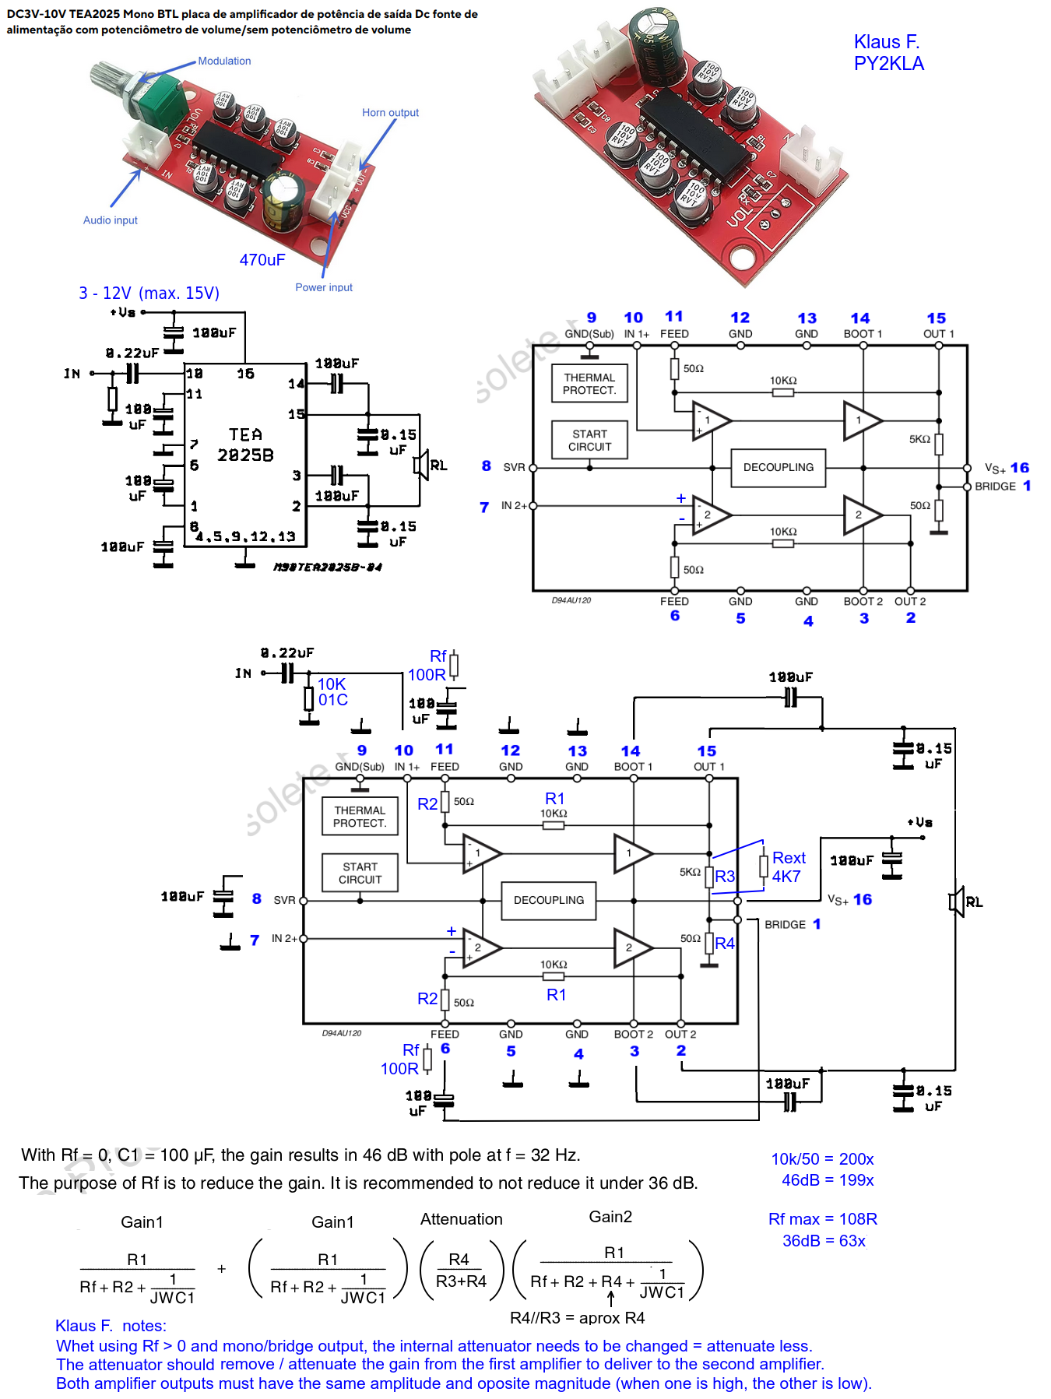
Aux/Components/TEA2025_pcb.png
