kaefe64/Arduino_uSDX_Pico_FFT_Proj/(threads)

Thread 2 (2022-09-16):

Error compiling for board Raspberry Pi

SREERAJSVT, 2022-09-16:
Arduino: 1.8.20 Hourly Build 2022/04/25 09:33 (Windows 10), Board: "Raspberry Pi Pico"
 Wire

"C:\\Users\\sreer\\AppData\\Local\\Arduino15\\packages\\arduino\\tools\\arm-none-eabi-gcc\\7-2017q4/bin/arm-none-eabi-g++" -c -g3 -nostdlib "@C:\\Users\\sreer\\AppData\\Local\\Arduino15\\packages\\arduino\\hardware\\mbed_rp2040\\3.3.0\\variants\\RASPBERRY_PI_PICO/defines.txt" "@C:\\Users\\sreer\\AppData\\Local\\Arduino15\\packages\\arduino\\hardware\\mbed_rp2040\\3.3.0\\variants\\RASPBERRY_PI_PICO/cxxflags.txt" -DARDUINO_ARCH_RP2040 -MMD -mcpu=cortex-m0plus -DARDUINO=10820 -DARDUINO_RASPBERRY_PI_PICO -DARDUINO_ARCH_MBED_RP2040 -DARDUINO_ARCH_MBED -DARDUINO_LIBRARY_DISCOVERY_PHASE=0 "-IC:\\Users\\sreer\\AppData\\Local\\Arduino15\\packages\\arduino\\hardware\\mbed_rp2040\\3.3.0\\cores\\arduino" "-IC:\\Users\\sreer\\AppData\\Local\\Arduino15\\packages\\arduino\\hardware\\mbed_rp2040\\3.3.0\\variants\\RASPBERRY_PI_PICO" "-IC:\\arduino-nightly\\libraries\\PICOUSDR\\src" "-IC:\\Users\\sreer\\AppData\\Local\\Arduino15\\packages\\arduino\\hardware\\mbed_rp2040\\3.3.0\\libraries\\SPI" "-IC:\\Users\\sreer\\OneDrive\\Documents\\Arduino\\libraries\\TFT_eSPI" "-IC:\\Users\\sreer\\AppData\\Local\\Arduino15\\packages\\arduino\\hardware\\mbed_rp2040\\3.3.0\\libraries\\Wire" "-IC:\\Users\\sreer\\AppData\\Local\\Arduino15\\packages\\arduino\\hardware\\mbed_rp2040\\3.3.0\\cores\\arduino/api/deprecated" "-IC:\\Users\\sreer\\AppData\\Local\\Arduino15\\packages\\arduino\\hardware\\mbed_rp2040\\3.3.0\\cores\\arduino/api/deprecated-avr-comp" "-iprefixC:\\Users\\sreer\\AppData\\Local\\Arduino15\\packages\\arduino\\hardware\\mbed_rp2040\\3.3.0\\cores\\arduino" "@C:\\Users\\sreer\\AppData\\Local\\Arduino15\\packages\\arduino\\hardware\\mbed_rp2040\\3.3.0\\variants\\RASPBERRY_PI_PICO/includes.txt" "C:\\arduino-nightly\\libraries\\PICOUSDR\\src\\uSDX_SI5351.cpp" -o "C:\\Users\\sreer\\AppData\\Local\\Temp\\arduino_build_149418\\libraries\\PICOUSDR\\uSDX_SI5351.cpp.o"

Using library PICOUSDR at version 1.0 in folder: C:\arduino-nightly\libraries\PICOUSDR

Using library SPI in folder: C:\Users\sreer\AppData\Local\Arduino15\packages\arduino\hardware\mbed_rp2040\3.3.0\libraries\SPI (legacy)

Using library TFT_eSPI at version 2.4.72 in folder: C:\Users\sreer\OneDrive\Documents\Arduino\libraries\TFT_eSPI

Using library Wire in folder: C:\Users\sreer\AppData\Local\Arduino15\packages\arduino\hardware\mbed_rp2040\3.3.0\libraries\Wire (legacy)

exit status 1

Error compiling for board Raspberry Pi Pico.

kefeur, 2022-09-26:
I received an error message Wire1 not declared this scope during the translation. What library do I need to install for it?

kefeur, 2022-09-26:
E:\ardu\USDX\Arduino_uSDX_Pico_FFT_Proj-master\Arduino_uSDX_Pico_FFT\uSDR.cpp: In function 'void uSDR_setup()':
E:\ardu\USDX\Arduino_uSDX_Pico_FFT_Proj-master\Arduino_uSDX_Pico_FFT\uSDR.cpp:51:3: error: 'Wire1' was not declared in this scope
   Wire1.begin();           //i2c1
   ^~~~~
E:\ardu\USDX\Arduino_uSDX_Pico_FFT_Proj-master\Arduino_uSDX_Pico_FFT\uSDR.cpp:51:3: note: suggested alternative: 'Wire'
   Wire1.begin();           //i2c1
   ^~~~~
   Wire

exit status 1

Compilation error: 'Wire1' was not declared in this scope

SREERAJSVT, 2022-10-27:
this code is missing some lines

avemirat, 2022-12-30:
No es posible cargar el codigo.
C:\Users\HP\AppData\Local\Temp\arduino-sketch-7D03291A581229C4E7D444E9ABBA061E\sketch\Arduino_uSDX_Pico_FFT.ino.cpp.o: In function `setup':
C:\Users\HP\Desktop\Arduino_uSDX_Pico_FFT/Arduino_uSDX_Pico_FFT.ino:182: undefined reference to `_UART1_'
C:\Users\HP\AppData\Local\Temp\arduino-sketch-7D03291A581229C4E7D444E9ABBA061E\sketch\monitor.cpp.o: In function `mon_lt()':
C:\Users\HP\Desktop\Arduino_uSDX_Pico_FFT/monitor.cpp:107: undefined reference to `_UART1_'
C:\Users\HP\AppData\Local\Temp\arduino-sketch-7D03291A581229C4E7D444E9ABBA061E\sketch\monitor.cpp.o: In function `mon_pt()':
C:\Users\HP\Desktop\Arduino_uSDX_Pico_FFT/monitor.cpp:124: undefined reference to `_UART1_'
C:\Users\HP\AppData\Local\Temp\arduino-sketch-7D03291A581229C4E7D444E9ABBA061E\sketch\monitor.cpp.o: In function `mon_si()':
C:\Users\HP\Desktop\Arduino_uSDX_Pico_FFT/monitor.cpp:96: undefined reference to `_UART1_'
C:\Users\HP\AppData\Local\Temp\arduino-sketch-7D03291A581229C4E7D444E9ABBA061E\sketch\monitor.cpp.o: In function `mon_bp()':
C:\Users\HP\Desktop\Arduino_uSDX_Pico_FFT/monitor.cpp:150: undefined reference to `_UART1_'
C:\Users\HP\AppData\Local\Temp\arduino-sketch-7D03291A581229C4E7D444E9ABBA061E\sketch\monitor.cpp.o:C:\Users\HP\Desktop\Arduino_uSDX_Pico_FFT/monitor.cpp:173: more undefined references to `_UART1_' follow
collect2.exe: error: ld returned 1 exit status

exit status 1

kaefe64, 2023-04-29:
Please, look at the .ino file comments.

CT7ABA, 2023-11-14:
Hi
I faced the same issue and it was my fault, I didn't made the changes as described at the *.ino file.
73 de Frederico

Closed 2024-08-17.

Thread 4 (2024-04-30):

Bandwidth of Mixer stage

ArjanteMarvelde, 2024-04-30:
Hello Klaus,

First of all, thanks for continuing and improving my uSDR-Pico project! Bumping into your you tube channel actually inspired me to dig up the project once more.

I am now in the progress of reviewing and cleaning-up the schematics, and was re-calculating the bandwidths of the several filtering stages in the HW. As I use only 3kHz or so of net audio bandwidth, I have based all filters on that. But now I realize this is incorrect, since I actually use 15625 samples per second rate as basis for DSP.

- The detector bandwidth is determined by the input impedance (50 Ohms) plus the switch resistance and the integration capacitor. With the current 220nF I get to about 3.4kHz, taking into account the per-phase 25% duty cycle of the switch.
- The integration differential amplifiers are set to about 2kHz (82k/1nF) which already seems too low.
- The path to the QSE starts with a 3.4kHz low pass (10k/4.7nF)
- The exciter driver has a 16kHz low pass filter.

In your adapted case you drill the signal processing bandwidth up by a factor 10 or so, to enable a wider bandwidth view for the waterfall. So my question is: what is your take on this, did you take the bandwidths into account in your re-design?

Cheers,
Arjan

kaefe64, 2024-05-05:
Hi Arjan

Thank you for getting in touch.
I "messed up" your project a little, I hope you are ok with that.
Changing from Visual Studio to Arduino IDE, changing the name, including an Arduino Pro Mini for band switch and more...
If you don't like anything or have a comment, please tell me.
Initally I was interested only to include the waterfall display, but some other changes were necessary.

About your comment: if you use AD with 15625 samples per second rate, the 3kHz filter for audio looks ok for me. Why do you think it is wrong?
I did not make much calculation to the input filter, after the mixer switching, I based partially in the Softrock RXTX and some practical tests. If you have a better suggestion for me, please tell me. I want a 80kHz bandwidth amplifier/filter at RX.
As I have this wider bandwidth, I need to deal with strong signals out of the center frequency, saturating the amplifier and/or the AD. That is why I get some "mirror" signals on the waterfall sometimes. Maybe we can talk about this...

I am not sure about your 16kHz low pass filter exciter driver. If you sample at ~16kHz, the filter should be 8kHz or less, isn't it?
I received some request to improve the audio bandwidth (TX at first). I believe there are some HI-FI hamradio out there with 6kHz audio bandwidth...

I also received some requests to improve the S meter. This is really an issue. I will need to calculate or measure the antenna to AD gain, more the internal attenuation/gain, and I did not find a good way to do it. And this is hardware/gain dependent, so we will need an factor adjusted on software. It is on hold...

I also want to use the advantage to have the Arduino Pro Mini reading the SWR to show it at the display. This is almost done, I just need to read the I2C and put it at the display.

There are other things to improve...   AM reception, waterfall zoom, RIT...

But I already made some contacts on 40m with the Arjan-5/uSDR-Pico, quite rewarding.

Thank you
Klaus F
PY2KLA

ArjanteMarvelde, 2024-05-06:
Hi Klaus,

Audio side filtering to 3kHz obviously is okay (unless you want HiFi AM...) but on the mixer-side you might need more than that. If you need a bandwidth of 80kHz I guess that the mixer should be able to pass on this band without attenuation.

In my reasoning, for example the integration capacitors in the RX chain will have to be a lot smaller than in my V3.0 schematics. The RX mixer bandwidth is determined by RF side impedance (50 Ohm), switch on impedance (4 Ohm) and integration capacitors:
Fc = 1/(2 . pi . 54 . C . 4)
The factor 4 comes from the 4 phases, each contributing only 25%. So for 80kHz the C can only be 10nF or so.

Same storyline applies to the integration OpAmps, where the RC in the feedback branch determine the bandwidth:
Fc=1/(2 . pi . R . C), in the V3.0 mixer that is only 2kHz or so.

Same reasoning could be applied to the TX stream.

In the FFT signal processing of V3.0 I place my centre frequency on an offset of 3700 Hz in a 7800Hz spectrum. I think I am losing a lot of sensitivity by using the filters as described, don't you think so?

Anyhow, I am contemplating an experiment, changing the values appropriately and see how it works. In any case in the upcoming V4.0 I will do so.

Cheers,
Arjan

ArjanteMarvelde, 2024-05-06:
About your questions:

- Strong signal handling, I suppose you need to manage out of band signals by proper filtering in the mixer or the subsequent IF stage. But strong signals inside the IF spectrum are an issue, this needs to be accommodated by the ADC dynamic range, so I suppose that you would have to AGC the peaks down into that range. I have been thinking about how to have an external AGC control from Pico to IF stage, but dismissed it because that would overcomplicate this _simple_ design.
- S-Meter, I have been struggling with this too. In v3.x I have made at least a logarithmic scaling, but of course absolute reference depends on a lot of implementation factors. I forget what my reasoning for this was, in principle there is an absolute signal strength associated with S9, and you need to relate this level to what is input into the Pico ADC.
- About your changes: that's what this experiment is for, isn't it? I don't know about you, but I certainly am not going to turn this into a product, too much fun experimenting. Indeed, the signal processing is a big open field to explore!

ArjanteMarvelde, 2024-05-06:
I've looked at the RSSI (low pass filtered signal amplitude) to S-value conversion:
The RSSI is input for the S-meter value function. The scale is logarithmic; up to S9 each 3dBV RSSI step corresponds with 1 S-level. Absolute S9 signal level is _defined_ to be -73dBm in 50 Ω, which corresponds with 50.1uV. Assuming unity gain in the mixer, the total voltage gain is primarily determined by the IF amplifier, which is targeted at approximately 300x. Then S9 should correspond to 14.4mV signal on the IF output/ADC input. Every +10 step above S9 multiplies this voltage level with 10^0.5=3.16.
In the signal acquisition there is an integration gain factor (in V3.0), adding 8 samples stretching the effective ADC range up to 16384. This theoretically limits the RX sensitivity down to about S2 when max is set to S9+40. In practise noise levels will be much higher than S2 though.

kaefe64, 2024-05-07:
Hi, and remember the attenuators could be ON.

Closed 2024-08-17.

Thread 6 (2024-05-31):

Frequency Shifting

barisdinc, 2024-05-31:
Hi @kaefe64 Klaus & Arjante @ArjanteMarvelde

I am OH2UDS/TA7W and I am working on a VHF/UHF/SHF SDR project (mainly for a portable QO-100 station). A brief info is in https://www.youtube.com/watch?v=xVOr04rAqmU

I prepared the prototypes and using a software based on your Arduino uSDX Pico but using Analog Devices IQ demodulators and modulators as hardware for CHF / UHF and SHF (but mostly for QO-100 satellite communications).

On hardware side in the prototypes I used a wrong PLL/VCO which only can step 10 KHz, so I am looking for the solution to shift the listening channel using SDR capabilities.

In Arjante's code the shifting and filtering part is easy and I can select the FFT (frequency) BINs that I would like to listen. But in your implementation I was not able to figure out which part is doing the shifting of the desired channel to 3.9Khz Fc and demodulationg that signal.

I will be very happy if you can support me on this,

BTW: Our project is also fully opensource and details can be found on these repositories. I would like to ask your permission to use your firmware for the starting point of our project which gave us a lot of inspirations to start.

https://github.com/barisdinc/N3B_SDR_Transceiver_FW
https://github.com/barisdinc/N3B_SDR_Transceiver_HW

73's de
Baris DINC
OH2UDS

barisdinc, 2024-06-05:
Thanks for the reply,
Its here in Arjante's code
https://github.com/ArjanteMarvelde/uSDR-pico/blob/main/dsp_fft.c#L219

while demodulationg it uses the selected bins of the FFT for demodulation, where your version looks like doing it directly the I/Q time variables and Hilbert transform of Q.....
I am trying to re-merge your version and Arjante's into a new version.. lets see what will be the output :)

Thanks
Baris DINC
OH2UDS / TA7W

Closed 2024-08-17.

Thread 7 (2024-07-09):

HOW TO USE uSDX_TX code

www97221, 2024-07-09:
Thank you for sharing your work. I have an unclear question about how to use the code in the uSDX-TX folder? How to debug or test the phase using code? Is there a specific testing process in uploading to the RP2040 microprocessor or Arduino Pro min board?

kaefe64, 2024-07-11:
Hello www97221

The uSDX-TX folder was created to try the "Amplitude/Phase" transmission, similar to the uSDX, using the RP2040.
It is not a final software, it is just a test. It reads the audio and transmits using "Amplitude/Phase" code from PE1NNZ uSDX converted to RD2040.
It is just for transmission and the frequency is fixed in the code: freq = 7100000;
Look the comments at beginning of "uSDX_TX.ino" file to know the input/output pins.

I hope it helps to answer your questions.
Have fun
Klaus F
PY2KLA

Closed 2024-08-17.

Thread 10 (2024-08-15):

error compilation

F4GMS, 2024-08-15:
hi,
my  version arduino ide is 2.3.2 with arduino Mbed OS RP2040 installed and choose Paspberry pi pico.
I  made all the mods at the  beginning of the code. I opened "pins_arduino.h" and I copied and replaced this lines:

#define PIN_WIRE_SDA        (16u)  //I2C0
#define PIN_WIRE_SCL        (17u)  //I2C0
#define PIN_WIRE_SDA1       (18u)  //included I2C1
#define PIN_WIRE_SCL1       (19u)  //included I2C1

#define WIRE_HOWMANY    (2)  //included I2C1   default was 1
#define I2C_SDA       (digitalPinToPinName(PIN_WIRE_SDA))   //I2C0
#define I2C_SCL       (digitalPinToPinName(PIN_WIRE_SCL))   //I2C0
#define I2C_SDA1      (digitalPinToPinName(PIN_WIRE_SDA1))  //included I2C1
#define I2C_SCL1      (digitalPinToPinName(PIN_WIRE_SCL1))  //included I2C1_

but same error in file Usdr.cpp "Compilation error: 'Wire1' was not declared in this scope"
some help? Thank you.
F4GMS

F4GMS, 2024-08-15:
finally OK but,  the following lines must also be added. problem solved
#define WIRE_HOWMANY	(2)
#define I2C_SDA			(digitalPinToPinName(PIN_WIRE_SDA))
#define I2C_SCL			(digitalPinToPinName(PIN_WIRE_SCL))
#define I2C_SDA1                   (digitalPinToPinName(PIN_WIRE_SDA1))
#define I2C_SCL1                    (digitalPinToPinName(PIN_WIRE_SCL1))

kaefe64, 2024-08-17:
Hi F4GMS

Thank you for trying the Arjan-5. Any feedback is welcome (look the discussion session).

It is great that you have already solved your issue.
Some lines need to be changed, others included. I put some tip on the lines comments.
If you find any wrong instruction, please inform, to help all users and myself.

Have fun
Klaus F
PY2KLA

charudatt, 2024-11-19:
Hello

I am having a problem with my hardware.

After the initial welcome screen, the displays goes just blank.

I have the following connected to the PICO –

*	Si5351
*	Obviously the TFT 2.8”
*	And the Rotary Encoder.

Any help will be appreciated

regards

Charudatt- VU2UPX

Closed 2024-08-17.

Thread 12 (2024-11-19):

Blank Display after Welcome Screen

charudatt, 2024-11-19:
Hello Sir,
I loaded the latest code in the PICO and after the Initial Welcome screen, the display goes blank (White Screen)

I have the following things connected to the PICO

1. Si5351 Module
2. Rotary Encoder
3. 2.8" Display

Any help will be appreciated

Charudatt - vu2upx

kaefe64, 2024-12-13:
Hi Charudatt

I am not sure I can help...
If the Welcome initial info is working, I understand that the display connections and setup are OK.
So, the Arjan-5 is trying to make internal things and hang...
You can try to comment some init function at  void uSDR_setup(void) function to see which one is hanging.

73
Klaus F
PY2KLA

Thread 13 (2024-12-19):

Trying to contact you

barisdinc, 2024-12-19:
Hi Klaus, this is TA7W/OH2UDS who used your approach fot N3B sdr satellite transceiver…. I am in SP now and I will be very happy if I can meet you face to face… sorey for using all mesia to access you…

please email me : barisdinc at gmail.com

Baris

kaefe64, 2025-01-02:
Hi Baris
Sorry, it was no possible to meet you.
73
Klaus F
PY2KLA

Closed 2025-01-02.

Thread 14 (2025-03-08):

R4 and R7 feedback - sensitivity

HaJi21cz, 2025-03-08:
I noticed a mistake while assembling the board. R4 and R7 should be the same values   in the I and Q feedback. There is 5k1 and 5k7. I assume your radio has the same values   because that would be a problem in the receiver sensitivity.

kaefe64, 2025-03-10:
Hi HaJi21cz

Thank you for your feedback.
You are right. It is a mistake, both R4 and R7 should be the same value 5K1 1%.

The same for R27 and R28, they should be 51K.

Thanks,
Klaus F
PY2KLA
