kaefe64/Arduino_uSDX_Pico_FFT_Proj/Aux/Components/YD-RP2040-Inch-SIZE.pdf

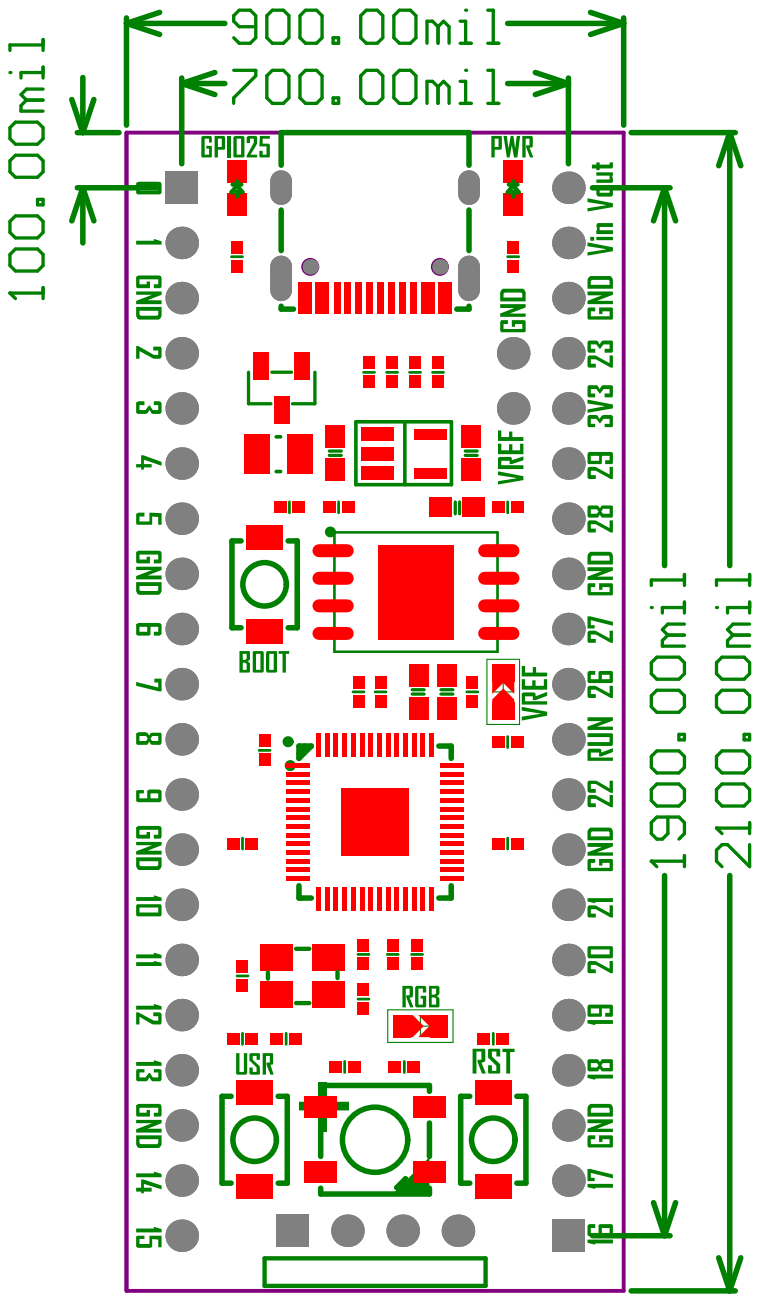
[picture p31: page 1]
