kaefe64/Arduino_uSDX_Pico_FFT_Proj/PCB/uSDR_Pico_FFT_SCH.pdf

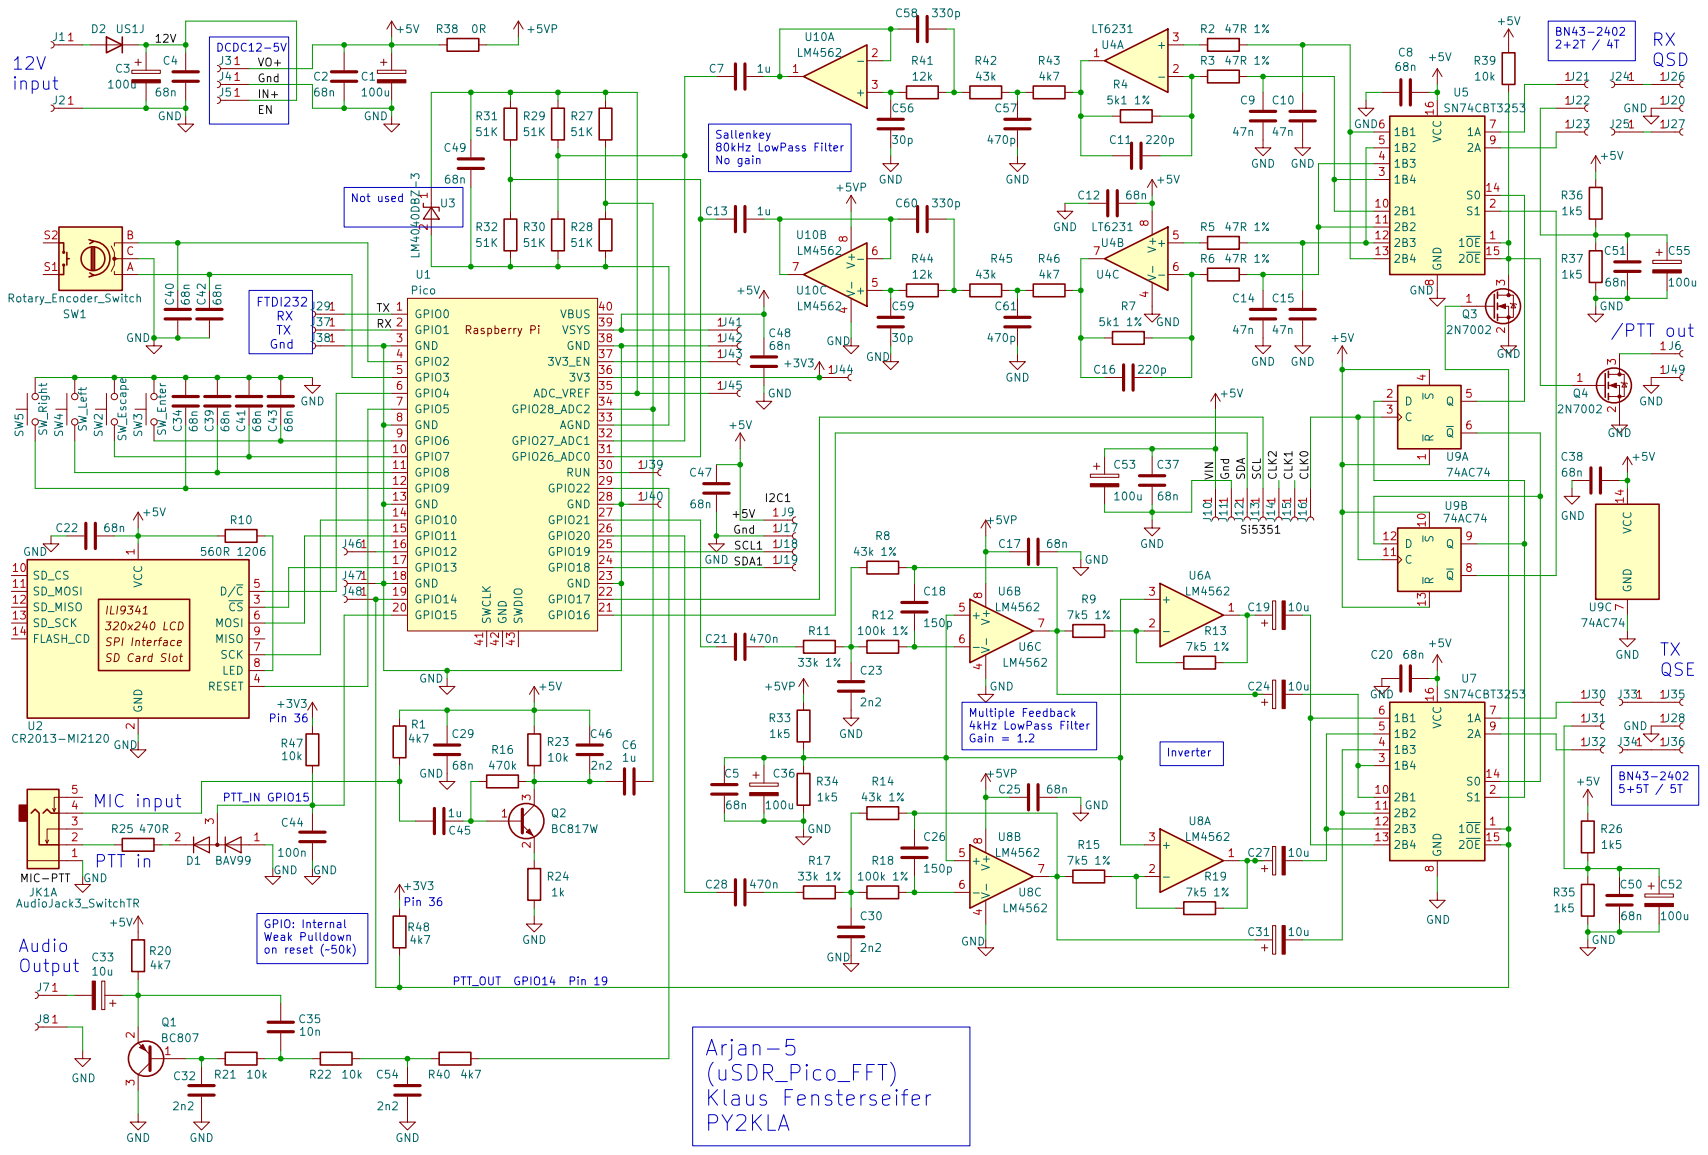
[picture p32: page 1]
