kaefe64/Arduino_uSDX_Pico_FFT_Proj/PCB/uSDR_Pico_BPF_RX_SCH.pdf

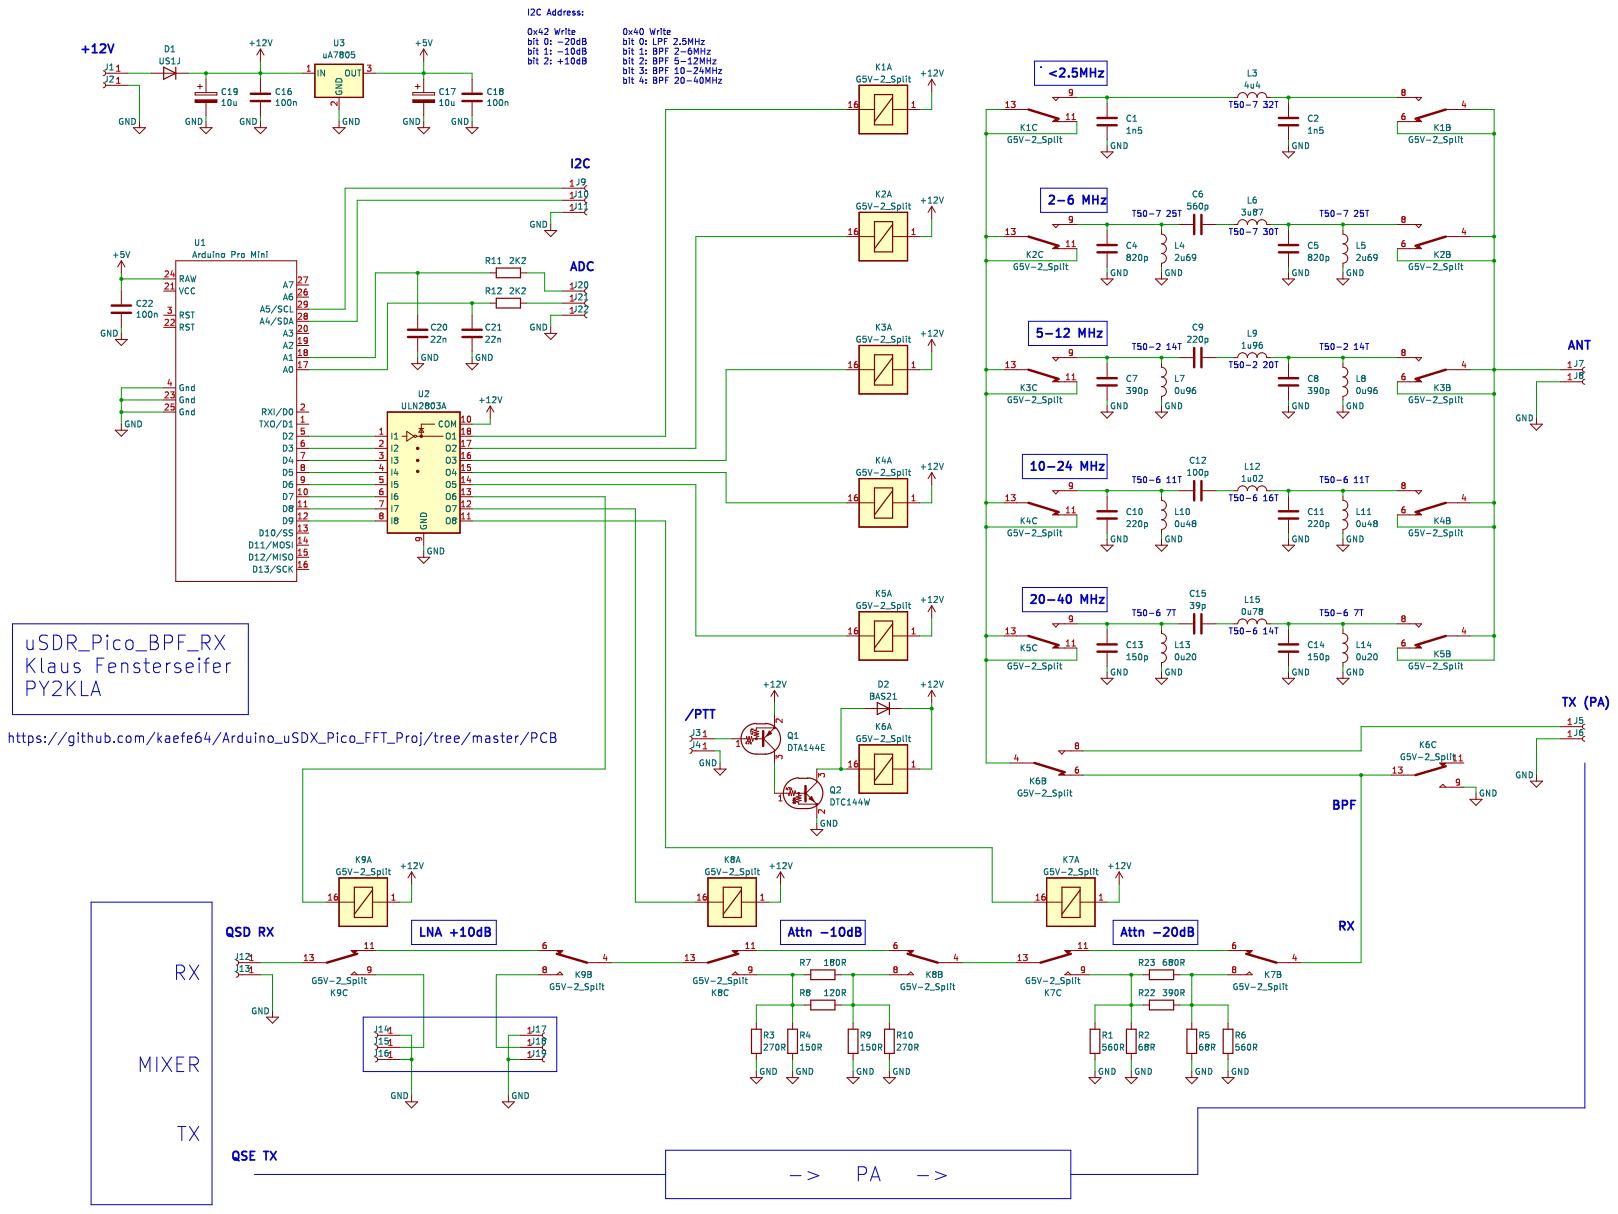
[picture p33: page 1]
