kaefe64/Arduino_uSDX_Pico_FFT_Proj/PCB/SWR/SWR_B_Mask.pdf

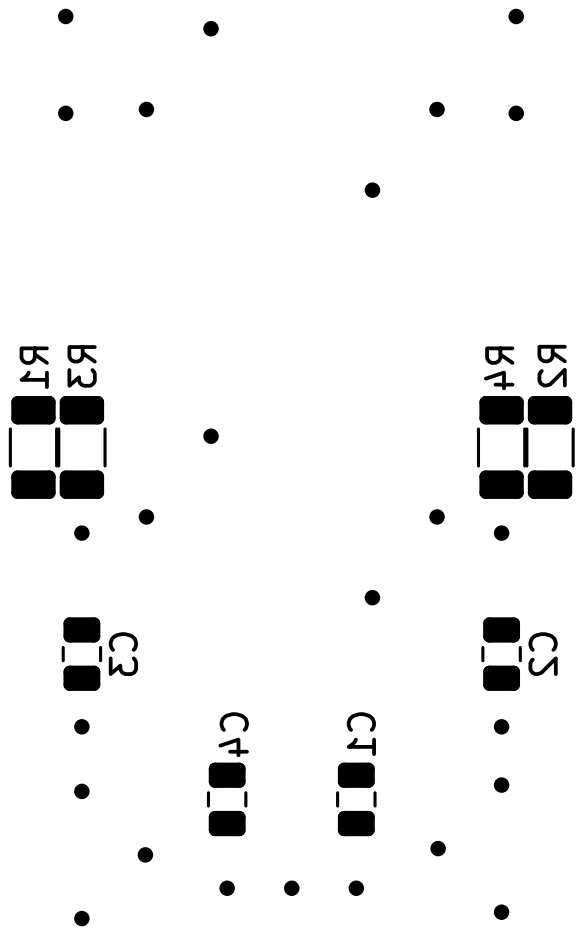
[picture p34: page 1]
