kaefe64/Arduino_uSDX_Pico_FFT_Proj/PCB/SWR/SWR_F_Mask.pdf

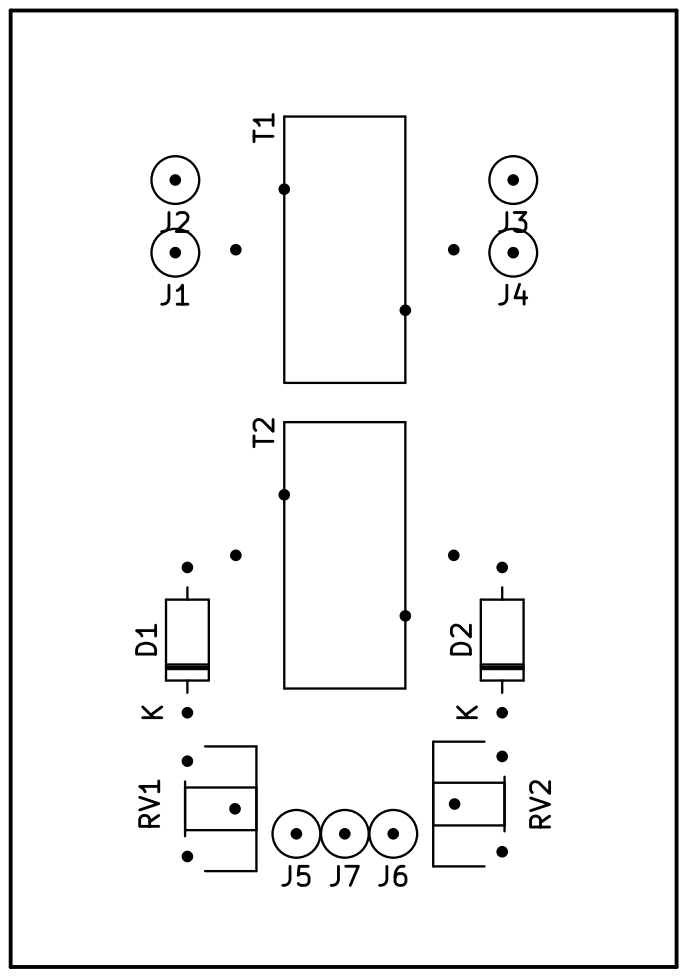
[picture p35: page 1]
