kaefe64/Arduino_uSDX_Pico_FFT_Proj/PCB/SWR/SWR_PCB.pdf

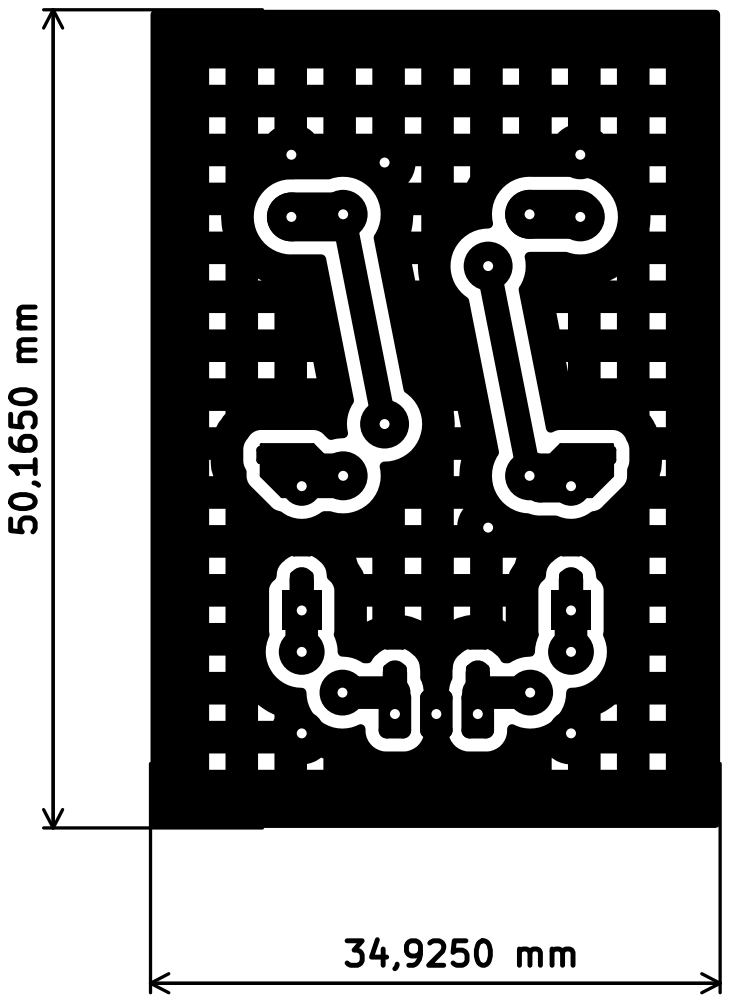
[picture p36: page 1]
