kaefe64/Arduino_uSDX_Pico_FFT_Proj/Arduino_I2C_BPF_RX/Arduino_I2C_BPF_RX.ino

/*

I2C Slave with multiple addresses

It receives I2C commands to activate the BandPass and/or Receiver Relays.
It receives I2C commands as more than one I2C slave (multiple addresses)
    to replace the two PCF8574 in Arjan-5 (uSDX Pico FFT project)
Adding new I2C command to read the SWR
    it uses A0 and A1 analog inputs to read the SWR Forward and Reflected information.
  
Reference:
https://stackoverflow.com/questions/34691478/arduino-as-slave-with-multiple-i2c-addresses
https://github.com/alexisgaziello/TwoWireSimulator

I2C Wire library with multi address:
https://github.com/arduino/ArduinoCore-avr/pull/90/files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



Arduino Pro Mini 3V3   ATmega328P 8Mhz
Flash: 32KB
SRAM: 2KB
EEPROM: 1KB
14 digital pins, input or output
Serial: 0 (RX) and 1 (TX)
External Interrupts: 2 and 3
PWM: 3, 5, 6, 9, 10, and 11
PI: 10 (SS), 11 (MOSI), 12 (MISO), 13 (SCK)
LED: 13
8 analog inputs, 10 bits of resolution: A0 - A7
I2C: A4 (SDA) and A5 (SCL)


Created: May 2023
Author: Klaus Fensterseifer  PY2KLA
https://github.com/kaefe64/Arduino_uSDX_Pico_FFT_Proj

*/

#include "Wire_.h"  //Local Wire Library  (same as Wire but with addings)
#include "EEPROM.h"


#define ledPin      13     // define LED pin number


/* I2C BPF = Band Pass Filters Relays   read/write 1 byte */
#define I2C_BPF		      0x20
#define REL_LPF2_pin		2   //160MHz
#define REL_BPF6_pin		3   //80MHz
#define REL_BPF12_pin		4   //40MHz
#define REL_BPF24_pin		5   //20MHz
#define REL_BPF40_pin		6   //10Mhz

#define REL_BPF_val_num   5
#define REL_LPF2_val		0x01
#define REL_BPF6_val		0x02
#define REL_BPF12_val		0x04
#define REL_BPF24_val		0x08
#define REL_BPF40_val		0x10

/* I2C RX = Attenuators & LNA Relays   read/write 1 byte */
#define I2C_RX 		      0x21
#define REL_ATT_20_pin	9
#define REL_ATT_10_pin	8
#define REL_PRE_10_pin	7

#define REL_ATT_val_num   5
#define REL_ATT_30_val	0x03
#define REL_ATT_20_val	0x01
#define REL_ATT_10_val	0x02
#define REL_ATT_00_val	0x00
#define REL_PRE_10_val	0x04
#define REL_PRE_00_val	0x00

/* I2C SWR read  3 bytes */
/* I2C SWR read   [High=SWR integer | Low=SWR decimal] [Forward] [Reflected] */
#define I2C_SWR 	    	      0x22  // read 3 bytes = SWR, FOR and REF
#define vADC_ForwardPin       A0    // select the input pin for the swr analog reading
#define vADC_vReflectedPin    A1    // select the input pin for the swr analog reading
#define VMIN                  20    // min forward AD value for swr
#define SWR_BASE10            10    // numeric base for SWR decimal
#define SWR_MIN               (1 * SWR_BASE10)    // SWR = 1.0
#define SWR_MAX               ((15 * SWR_BASE10)+(SWR_BASE10-1))  // byte max value, SWR max = 15.9

uint8_t SWR[3];  //save swr info to send to I2C master = swr, forward and reflected

/* I2C EEPROM   write (2 bytes = EEP address to read  + 1 byte numbytes to read) */
/* I2C EEPROM   write [ADDR_LOW] [ADDR_HIGH] [NUM_BYTES]       NUM_BYTES must be < 28 due to I2C buffer size */
#define I2C_EEP_ADD_NB 	  0x22  // write (receive) EEP address and numbytes

/* I2C EEPROM   read numbytes bytes (EEP address from EEP_ADD_RD) */
/* I2C EEPROM   read [VALUE1] [VALUE2] ...  ... [VALUEn] */
#define I2C_EEP_RD  	  0x23  // read data on eeprom address 

/* I2C EEPROM   write 2 bytes address + 1 byte numbytes + numbytes data...  */
/* I2C EEPROM   write [ADDR_LOW] [ADDR_HIGH] [NUM_BYTES] [VALUE1] [VALUE2] ... [VALUEn]    NUM_BYTES must be < I2C_MAX_NUMBYTES due to I2C buffer size */
#define I2C_EEP_WR  	  0x23  // write data to eeprom address 


//#define I2C_TWAR (I2C_BPF | I2C_RX | I2C_SWR | I2C_EEP_RD)  // TWAR = main mask address = 0010 0011
#define I2C_TWAR (I2C_BPF | I2C_RX | I2C_SWR)  // TWAR = main mask address = 0010 0011
//#define I2C_TWAMR ((I2C_BPF | I2C_RX | I2C_SWR | I2C_EEP_RD) ^ (I2C_BPF & I2C_RX & I2C_SWR & I2C_EEP_RD))  // xor = 0000 0011 ->  it receives addresses 0010 00XX  ->  from 0x20 to 0x23
#define I2C_TWAMR ((I2C_BPF | I2C_RX | I2C_SWR) ^ (I2C_BPF & I2C_RX & I2C_SWR))  // xor = 0000 0011 ->  it receives addresses 0010 00XX  ->  from 0x20 to 0x23
// TWAMR = on bit set, accept any value for the address bit received



uint8_t RX_Relays=0, RX_Relays_old=0xff;
uint8_t BPF_Relays=0, BPF_Relays_old=0xff;
uint8_t rec=0, I2C_Address;
const uint8_t REL_BPF_val[REL_BPF_val_num] = {REL_LPF2_val, REL_BPF6_val, REL_BPF12_val, REL_BPF24_val, REL_BPF40_val};
const uint8_t REL_ATT_val[REL_ATT_val_num] = {REL_PRE_10_val, REL_ATT_30_val, REL_ATT_20_val, REL_ATT_10_val, REL_ATT_00_val};
uint8_t Debug_LastAddress;  //just for debug


/*eeprom variables */
#define EEP_MAX_BUFFER      10    //number of writes could be on hold to write on EEP  (16 = 82% RAM used)
#define I2C_MAX_NUMBYTES    26    //max 32 - address - numbyte - spare
int I2C_read_byte;
int EEP_rd_addr;
int EEP_rd_numbytes;
struct st_EEP_wr {
    int addr;
    int numbytes;
    int bytes[I2C_MAX_NUMBYTES];
};
struct st_EEP_wr EEP_wr[EEP_MAX_BUFFER];

int EEP_wr_pos_in = 0;
int EEP_wr_pos_out = 0;


unsigned long nextMillis;
#define LOOP_PERIOD_MILLIS  100   //100ms  main loop


/*****************************************************************************************/
void setup() 
{
  pinMode(ledPin, OUTPUT);
  
  Serial.begin(115200);  //choose the right clock for Arduino Pro Mini at Tools Processor
  for(int i=0; i<50; i++)    // wait some time for Serial to open
  {
  digitalWrite(ledPin, 1);  //toggle led
  delay(50);                       // wait
  digitalWrite(ledPin, 0);  //toggle led
  delay(50);                       // wait
  if(Serial)  //serial opened
    break;
  }  // If the serial does not open, the print commands will have no effect
  Serial.println("\nArduino I2C Slave Multi Address");
  //Serial.print("FREQ CPU: ");
  //Serial.println(F_CPU);   //prints the clock frequency, chose the right clock for Arduino Pro Mini at Tools Processor
  
  pinMode(REL_LPF2_pin, OUTPUT);
  pinMode(REL_BPF6_pin, OUTPUT);
  pinMode(REL_BPF12_pin, OUTPUT);
  pinMode(REL_BPF24_pin, OUTPUT);
  pinMode(REL_BPF40_pin, OUTPUT);
  pinMode(REL_ATT_20_pin, OUTPUT);
  pinMode(REL_ATT_10_pin, OUTPUT); 
  pinMode(REL_PRE_10_pin, OUTPUT);

  digitalWrite(REL_LPF2_pin, 1);
  digitalWrite(REL_BPF6_pin, 0);        
  digitalWrite(REL_BPF12_pin, 0);
  digitalWrite(REL_BPF24_pin, 0);
  digitalWrite(REL_BPF40_pin, 0);
  digitalWrite(REL_ATT_20_pin, 0);
  digitalWrite(REL_ATT_10_pin, 0);        
  digitalWrite(REL_PRE_10_pin, 0);

  pinMode(vADC_ForwardPin, INPUT);
  pinMode(vADC_vReflectedPin, INPUT);

  Wire.begin(I2C_TWAR, I2C_TWAMR);       // base address for all slaves running here (valid only for ATmega328P Arduinos)
  Wire.onRequest(requestEvent);  // register callback function for I2C = master read
  Wire.onReceive(receiveEvent);  // register callback function for I2C = master write

  nextMillis = millis() + LOOP_PERIOD_MILLIS;
}


/*****************************************************************************************/
void requestEvent (){    // master read = request data from slave
  switch (Wire.getLastAddress()) {   // address from last byte on the bus
    case (I2C_BPF):
      Wire.flush();
      Wire.write(BPF_Relays);   // send byte relays state
      Debug_LastAddress = I2C_BPF;
      break;

    case (I2C_RX):
      Wire.flush();
      Wire.write(RX_Relays);   // send byte relays state
      Debug_LastAddress = I2C_RX;
      break;

    case (I2C_SWR):
      Wire.flush();
      //Wire.write(SWR[0]); 
      Wire.write(SWR, 3);   // send back 3 bytes
      Debug_LastAddress = I2C_SWR;
      break;

    case (I2C_EEP_RD):  //read eeprom
      Wire.flush();
      Serial.print("I2C_EEP_RD event   EEP_rd_numbytes=");
      Serial.println(EEP_rd_numbytes);
      /* [VALUE1] [VALUE2] ...  ... [VALUEn] */
      for(int i=0; i<EEP_rd_numbytes; i++)
      {
        Wire.write(EEPROM.read(EEP_rd_addr+i));   // send back the value from eeprom address
        Serial.print(EEPROM.read(EEP_rd_addr+i));  Serial.print("  ");
      }
      Serial.println("  ");
      EEP_rd_numbytes = 0;  //do not use again (maybe not necessary)
      Debug_LastAddress = I2C_EEP_RD;
      break;

    default:
      break;
  }
}


/*****************************************************************************************/
void receiveEvent(int howManyBytesReceived)    // master write = send data to slave
  {
  Serial.print("Receive event  ");   
  switch (Wire.getLastAddress()) {   // address from last byte on the bus
    case (I2C_BPF):
      Serial.println("Rx event I2C_BPF ");   
      I2C_read_byte = Wire.read();   // receive byte
      if(I2C_read_byte >= 0)  //some byte available from I2C
      {
        BPF_Relays = I2C_read_byte;
      }
      Wire.flush();
      Debug_LastAddress = I2C_BPF;
      break;

    case (I2C_RX):
      Serial.println("Rx event I2C_RX ");   
      I2C_read_byte = Wire.read();   // receive byte
      if(I2C_read_byte >= 0)  //some byte available from I2C
      {      
        RX_Relays = I2C_read_byte;
      }
      Wire.flush();
      Debug_LastAddress = I2C_RX;
      break;

    case (I2C_EEP_ADD_NB):  //write (receive) eeprom address and numbytes for next eeprom read/write   
      Serial.println("Rx event I2C_EEP_ADD_NB  ");   
      /* [ADDR_LOW] [ADDR_HIGH] [NUM_BYTES]       NUM_BYTES must be < I2C_MAX_NUMBYTES due to I2C buffer size */
      EEP_rd_numbytes = 0;
      I2C_read_byte = Wire.read();   // receive a data byte from I2C = eeprom address
      Serial.print("  EEP_rd_addr0=");  Serial.print(I2C_read_byte);  
      if(I2C_read_byte >= 0)   //some byte available from I2C = address came
      {
        EEP_rd_addr = I2C_read_byte;  //address low byte
        I2C_read_byte = Wire.read();   // receive a data byte from I2C = eeprom address
         Serial.print("   EEP_rd_addr1="); Serial.print(I2C_read_byte); 
        if((I2C_read_byte >= 0)&& (I2C_read_byte < 4))  //address >=0 and  <=1k and some byte available from I2C = address came
        {
          EEP_rd_addr |= (I2C_read_byte << 8);    //address high byte
          I2C_read_byte = Wire.read();   // receive a data byte from I2C = num bytes to read
          Serial.print("   byte="); Serial.print(I2C_read_byte); 
          if((I2C_read_byte > 0) && (I2C_read_byte < I2C_MAX_NUMBYTES))  //some byte available from I2C 
          {
            EEP_rd_numbytes = I2C_read_byte;
          }
        }
      }
      Serial.println("   Fim");
      Wire.flush();
      Debug_LastAddress = I2C_EEP_ADD_NB;
      break;

    case (I2C_EEP_WR):  //write eeprom
      /* [ADDR_LOW] [ADDR_HIGH] [NUM_BYTES] [VALUE1] [VALUE2] ... [VALUEn]    NUM_BYTES must be < I2C_MAX_NUMBYTES due to I2C buffer size */
      I2C_read_byte = Wire.read();   // receive a data byte from I2C = eeprom address
      Serial.print("  EEP_wr_addr0=");  Serial.print(I2C_read_byte);  
      if(I2C_read_byte >= 0)   //some byte available from I2C = address came
      {
        EEP_wr[EEP_wr_pos_in].addr = I2C_read_byte;  //address low byte
        I2C_read_byte = Wire.read();   // receive a data byte from I2C = eeprom address
         Serial.print("   EEP_wr_addr1="); Serial.print(I2C_read_byte); 
        if((I2C_read_byte >= 0) && (I2C_read_byte < 4))  //address >=0 and  <=1k and some byte available from I2C = address came
        {
          EEP_wr[EEP_wr_pos_in].addr |= (I2C_read_byte << 8);    //address high byte
          I2C_read_byte = Wire.read();   // receive a data byte from I2C = num bytes to read
          Serial.print("   num bytes="); Serial.print(I2C_read_byte); 
          if((I2C_read_byte > 0) && (I2C_read_byte < I2C_MAX_NUMBYTES))  //some byte available from I2C 
          {
            EEP_wr[EEP_wr_pos_in].numbytes = I2C_read_byte;  //indicates to the main loop to write to eeprom
            for(int i=0; i<EEP_wr[EEP_wr_pos_in].numbytes; i++)
            {
              I2C_read_byte = Wire.read();   // receive a data byte from I2C = data
              Serial.print(" "); Serial.print(I2C_read_byte); 
              if(I2C_read_byte >= 0)  //some byte available  from I2C = data to write came
              {       
                EEP_wr[EEP_wr_pos_in].bytes[i] = I2C_read_byte;   // save the values to write on eeprom later (do not spent time here)
              }
            }
            EEP_wr_pos_in++; if(EEP_wr_pos_in>=EEP_MAX_BUFFER) EEP_wr_pos_in=0;  //ready for next 'in' write command
          }
        }
      }
      Serial.println("   Fim");
      Wire.flush();
      Debug_LastAddress = I2C_EEP_WR;
      break;

    default:
      break;
  }

}


/*****************************************************************************************/
void EEP_wr_check() {
  while(EEP_wr_pos_in != EEP_wr_pos_out)   //data to write on eeprom
  {
    for(int i=0; i< EEP_wr[EEP_wr_pos_out].numbytes; i++)
    {
      Serial.print(i);  
      Serial.print(" wr addr ");  
      Serial.print(EEP_wr[EEP_wr_pos_out].addr+i);
      Serial.print(" val ");  
      Serial.println(EEP_wr[EEP_wr_pos_out].bytes[i]);
      EEPROM.update(EEP_wr[EEP_wr_pos_out].addr+i, EEP_wr[EEP_wr_pos_out].bytes[i]);   // write the value on eeprom address if different
    }
    EEP_wr_pos_out++; if(EEP_wr_pos_out>=EEP_MAX_BUFFER) EEP_wr_pos_out=0;  //job done
  }
}


/*****************************************************************************************/
void Set_BPF_Relays() {

  Serial.print("Set BPF Relays ");  

  if(BPF_Relays == REL_LPF2_val)    
  {
    digitalWrite(REL_LPF2_pin, 1);
    digitalWrite(REL_BPF6_pin, 0);        
    digitalWrite(REL_BPF12_pin, 0);
    digitalWrite(REL_BPF24_pin, 0);
    digitalWrite(REL_BPF40_pin, 0);
    
    Serial.print(BPF_Relays);  
    Serial.println("  REL_LPF2_val   band=0");  
  }  
  else if(BPF_Relays == REL_BPF6_val) 
  {
    digitalWrite(REL_LPF2_pin, 0);
    digitalWrite(REL_BPF6_pin, 1);        
    digitalWrite(REL_BPF12_pin, 0);
    digitalWrite(REL_BPF24_pin, 0);
    digitalWrite(REL_BPF40_pin, 0);
    
    Serial.print(BPF_Relays);  
    Serial.println("  REL_BPF6_val   band=1");  
  }  
  else if(BPF_Relays == REL_BPF12_val) 
  {
    digitalWrite(REL_LPF2_pin, 0);
    digitalWrite(REL_BPF6_pin, 0);        
    digitalWrite(REL_BPF12_pin, 1);
    digitalWrite(REL_BPF24_pin, 0);
    digitalWrite(REL_BPF40_pin, 0);
    
    Serial.print(BPF_Relays);  
    Serial.println("  REL_BPF12_val   band=3");  
  }  
  else if(BPF_Relays == REL_BPF24_val) 
  {
    digitalWrite(REL_LPF2_pin, 0);
    digitalWrite(REL_BPF6_pin, 0);        
    digitalWrite(REL_BPF12_pin, 0);
    digitalWrite(REL_BPF24_pin, 1);
    digitalWrite(REL_BPF40_pin, 0);
    
    Serial.print(BPF_Relays);  
    Serial.println("  REL_BPF24_val   band=4");  
  }  
  else //BPF40   at least 1 filter connected
  {
    digitalWrite(REL_LPF2_pin, 0);
    digitalWrite(REL_BPF6_pin, 0);        
    digitalWrite(REL_BPF12_pin, 0);
    digitalWrite(REL_BPF24_pin, 0);
    digitalWrite(REL_BPF40_pin, 1);
    
    Serial.print(BPF_Relays);  
    Serial.println("  REL_BPF40_val   band=2");  
  }  
  
//  digitalWrite(ledPin, !digitalRead(ledPin));    //toggle led
}



/*****************************************************************************************/
void Set_RX_Relays() {

  Serial.print("Set RX Relays ");  
  Serial.print(RX_Relays);    

  if((RX_Relays & REL_ATT_20_val) == REL_ATT_20_val) 
  {
    digitalWrite(REL_ATT_20_pin, 1);
    Serial.print("   REL_ATT_20_val");      
  }
  else
  {
    digitalWrite(REL_ATT_20_pin, 0);        
  }  

  if((RX_Relays & REL_ATT_10_val) == REL_ATT_10_val) 
  {
    digitalWrite(REL_ATT_10_pin, 1);        
    Serial.print("   REL_ATT_10_val");      
  }  
  else
  {
    digitalWrite(REL_ATT_10_pin, 0);        
  }   

  if((RX_Relays & REL_PRE_10_val) == REL_PRE_10_val) 
  {
    digitalWrite(REL_PRE_10_pin, 1);
    Serial.print("   REL_PRE_10_pin");      
  }       
  else
  {
    digitalWrite(REL_PRE_10_pin, 0);
  } 
  
  Serial.println(" ");      
//  digitalWrite(ledPin, !digitalRead(ledPin));    //toggle led
}


	char s[64];


/*****************************************************************************************/
void SWR_read() 
{
  uint16_t vForward, vForward0;
  static uint16_t  vForward1=1;  //last AD reading
  uint16_t vReflected, vReflected0;
  static uint16_t vReflected1=1;  //last AD reading
  uint16_t swr, swr_unid, swr_dec;
  
  /* read the AD for SWR */
  vForward0 = analogRead(vADC_ForwardPin);      //actual value
  vForward = (vForward0 + vForward1) >> 1;   //average with last value
    
  vReflected0 = analogRead(vADC_vReflectedPin);  //actual value
  vReflected = (vReflected0 + vReflected1) >> 1;   //average with last value

  //vForward = 100;
  //vReflected = 10;
  if((vForward0 != vForward1) ||
     (vReflected0 != vReflected1))
  {
/*
    Serial.print("ADC   for0= ");  
    Serial.print(vForward0);
    Serial.print("   ref0= ");
    Serial.println(vReflected0);
*/
    sprintf(s, "ADC   for0= %02x   ref0= %02x", vForward0, vReflected0);
    Serial.println(s);
  }

  vForward1 = vForward0;                //save last value for average
  vReflected1 = vReflected0;            //save last value for average



  if(vForward < VMIN)
  {
    swr = SWR_MIN;
  }    
  else if(vForward <= vReflected)
  {
    swr = SWR_MAX;
  }    
  else
  {    
    swr = (SWR_BASE10 * (vForward + vReflected)) / (vForward - vReflected);
    if(swr > SWR_MAX)      
    {
      swr = SWR_MAX;
    }      
  }
  /* swr value will be from 1.0 to 15.9 */
  /* 1 byte -> bit7-bit4 = integer    bit3-bit0 = decimal base 10 */

  swr_unid = swr/SWR_BASE10;  //integer part  max = 15
  if(swr_unid > 15) swr_unid = 15;
  swr_dec = swr%SWR_BASE10;   //decimal part
  if(swr_dec > 9) swr_dec = 9;  //double check, just in case SWR_BASE10 changed
  SWR[0] = (swr_unid << 4) + swr_dec;
  SWR[1] = vForward >> 2;  //10 bits AD to 8 bits
  SWR[2] = vReflected >> 2;

  if(vForward > 0)
    {
/*
    Serial.print("SWR  For= ");  
    Serial.print(SWR[1]);
    Serial.print("   Ref= ");  
    Serial.print(SWR[2]);
    Serial.print("   swr= ");  
    Serial.print(SWR[0]>>4);  //swr_unid
    Serial.print(".");
    Serial.println(SWR[0]&0x0f);   //swr_dec
*/
    sprintf(s, "SWR     swr= %d.%d   For= %02x   Ref= %02x", SWR[0]>>4, SWR[0]&0x0f, SWR[1], SWR[2]);
    Serial.println(s);
    }
  else
    {
      SWR[0] = 0; // the min SWR when tx is 0x10 = 1.0, if not TX, SWR = 0.0 (for debug)
    }
}




uint8_t InitCheck(void)
{
  static uint16_t cont_BPF_relay = 0;
  static uint16_t cont_ATT_relay = 0;
  static uint16_t cont_test = 0;
  uint8_t retValue;

  if(cont_test < 10) 
  {
    /*******************************************************************************************************/  
    /* initial test switching relays after reset  (just switch through all relays) */
    /*******************************************************************************************************/  
    if(cont_test < 5)  
    {    
      BPF_Relays = REL_BPF_val[cont_BPF_relay];
      //Serial.println("Set BPF Relays " + String(cont_BPF_relay) + "  " + String(BPF_Relays));
      Serial.print(cont_BPF_relay);   Serial.print("  ");
      cont_BPF_relay++;
      if(cont_BPF_relay >= REL_BPF_val_num)
        cont_BPF_relay = 0;
      Set_BPF_Relays();
    }
    else
    {    
      RX_Relays = REL_ATT_val[cont_ATT_relay];
      //Serial.println("Set RX Relays " + String(cont_ATT_relay) + "  " + String(RX_Relays));
      Serial.print(cont_ATT_relay);   Serial.print("  ");
      cont_ATT_relay++;
      if(cont_ATT_relay >= REL_ATT_val_num)
        cont_ATT_relay = 0;
      Set_RX_Relays();
    }
    cont_test++;

    delay(250);  //ms

    retValue = false;
  }
  else  
  {
    retValue = true;
  }


return retValue;

}







/*****************************************************************************************/
void loop() {

  if(InitCheck() == true)  /* it runs a test sequence after reset, true means ready for normal processing */
  {  
    /*********************************/  
    /* loop normal processing  100ms */
    /*********************************/  
    digitalWrite(ledPin, 1);

    SWR_read();  /* read the ADC for SWR calculation */

/*
    if(Debug_LastAddress != 0)
    {
      Serial.print('_');
      Serial.print(Debug_LastAddress); 
      Debug_LastAddress = 0;
    }
*/

    digitalWrite(ledPin, 0);

    /* wait loop period to end - pocesses normal loop at specific period */
    while(millis() < nextMillis)
    {

      /**************************/  
      /* quick loop processing  */
      /**************************/  

      /* check if received new value to set the BPF relays */
      if(BPF_Relays_old != BPF_Relays)
      {
        Set_BPF_Relays();
        BPF_Relays_old = BPF_Relays;
      }

      /* check if received new value to set the RX relays */
      if(RX_Relays_old != RX_Relays)
      {
        Set_RX_Relays();
        RX_Relays_old = RX_Relays;
      }  

      EEP_wr_check();  /* if something to write on eeprom */

    }
    /* time for next loop period */  
    nextMillis += LOOP_PERIOD_MILLIS; 
  }
}
