kaefe64/Arduino_uSDX_Pico_FFT_Proj/Arduino_uSDX_Pico_FFT/dsp.cpp

/*
 * dsp.cpp
 *
 * Created: Mar 2021
 * Author: Arjan te Marvelde
 * May2022: adapted by Klaus Fensterseifer 
 * https://github.com/kaefe64/Arduino_uSDX_Pico_FFT_Proj
 * 
 * Signal processing of RX and TX branch, to be run on the second processor core.
 * Each branch has a dedicated routine that must run on set times.
 * The period is determined by reads from the inter-core fifo, by the dsp_loop() routine. 
 * This fifo is written from core0 from a 16us timer callback routine (i.e. 62.5kHz)
 *
 * The RX branch:
 * - Sample I and Q QSD channels, and shift into I and Q delay line (62.5 kHz per channel)
 * - Low pass filter: Fc=4kHz
 * - Quarter rate (15.625 kHz) to improve low freq behavior of Hilbert transform
 * - Calculate 15 tap Hilbert transform on Q
 * - Demodulate, taking proper delays into account
 * - Push to Audio output DAC
 *
 * Always perform audio sampling (62.5kHz) and level detections, in case of VOX active
 *
 * The TX branch (if VOX or PTT):
 * - Low pass filter: Fc=3kHz
 * - Eight rate (7.8125 kHz) to improve low F behavior of Hilbert transform
 * - Generate Q samples by doing a Hilbert transform
 * - Push I and Q to QSE output DACs
 *
 */

#include "Arduino.h"
#include "hardware/pwm.h"
#include "hardware/adc.h"
#include "hardware/irq.h"
#include "hardware/dma.h"
#include "pico/multicore.h"
#include "hmi.h"
#include "hardware/structs/bus_ctrl.h"
#include "uSDR.h"
#include "dsp.h"
#include "kiss_fftr.h"
#include "TFT_eSPI.h"
#include "display_tft.h"
#include "pico/multicore.h"
#include "CwDecoder.h"

#if TX_METHOD == PHASE_AMPLITUDE    // uSDX TX method used for Class E RF amplifier
#include "uSDX_I2C.h"
#include "uSDX_SI5351.h"
#include "uSDX_TX_PhaseAmpl.h"
#endif


#define ADC0_IRQ_FIFO 		22		// FIFO IRQ number (same value on MBED and Earle Philhower cores)
//#define GP_PTT_IN				    15		// PTT pin 20 (GPIO 15)

int dma_chan;

volatile uint16_t tim_count = 0;
volatile uint16_t tim_count_loc = 0;



volatile uint16_t dac_iq, dac_audio;

//time to wait on TX after dih and dahs on CW (it will hold GP_PTT_OUT for a moment)
#define TX_ENABLED_EXTRA_CNT  (200u * (FSAMP_AUDIO/1000u))   //200ms a 16kHz = 3200
volatile uint16_t tx_enabled_extra_cnt = 0;  //  if > 0, cw tx delay active, no cw sidetone 



/**************************************************************************************
 * Some macro's
 * See Alpha Max plus Beta Min algorithm for MAG (vector length)
 **************************************************************************************/
#define ABS(x)    ((x)<0?-(x):(x))
#define MAG(i,q)  (ABS(i)>ABS(q) ? ABS(i)+((3*ABS(q))>>3) : ABS(q)+((3*ABS(i))>>3))





/**************************************************************************************
 * mag_level()
 * Convert a linear FFT magnitude (kiss_fft fixed point, up to 15 bits) into a
 * logarithmic level 0..63 to be stored in the waterfall buffer.
 *
 * Why log: the magnitudes of one band span more than 70 dB, so a linear value (or a
 * linear threshold) puts almost every bin in the same color. One bit of magnitude is
 * 6 dB and each level step is 1.5 dB, giving ~90 dB of range on 6 bits.
 * The level is absolute here on purpose, the waterfall reference (the noise floor
 * measured from the band) is subtracted later in display_tft.cpp.
 **************************************************************************************/
#define MAG_STEP_PER_BIT   4   //level steps per bit of magnitude (1 bit = 6 dB = 4 steps)
static uint8_t mag_level(int32_t mag)   //int32 because MAG() of two full scale bins overflows int16
{
  uint8_t   k = 0;
  uint32_t  m;

  if(mag < 0)
  {
    mag = -mag;
  }
  m = (uint32_t)mag;

  if(m < 4u)
  {
    return 0;   //below the usable quantization, the waterfall floor takes over here
  }

  while(m > 1u)          //k = 4 * log2(m)
  {
    m >>= 1;
    k += MAG_STEP_PER_BIT;
  }

  k += (uint8_t)(((m << 2) >> (k >> 2)) & 3u);   //2 mantissa bits

  if(k > (WF_COLOR_NUM - 1u))   //never let the level escape the waterfall palette
  {
    k = (uint8_t)(WF_COLOR_NUM - 1u);
  }

  return k;
}




//local functions
bool rx(void);
void tx(void);
bool vox(void);




#include "dsp_filters.h"









// Obs.:  LPF time critical, use max 25 filter taps
// Obs.:  The input signal ADC should be previous filthered to < half sampling frequency

#define FILTER_SHIFT  16  // 16 bits coef 

// Obs.: *** i_s_raw[], q_s_raw[] and a_s_raw[]  need to use the size as the filter with more taps
// CW_BPF_TAP_NUM  or  AM_LPF_TAP_NUM  or  SBB_LPF_TAP_NUM  ->   MAX_TAP_NUM
#define MAX_TAP_NUM  CW_BPF_TAP_NUM
#if AM_LPF_TAP_NUM > MAX_TAP_NUM
#undef MAX_TAP_NUM
#define MAX_TAP_NUM  AM_LPF_TAP_NUM
#endif
#if SBB_LPF_TAP_NUM > MAX_TAP_NUM
#undef MAX_TAP_NUM
#define MAX_TAP_NUM  SBB_LPF_TAP_NUM
#endif
volatile int16_t i_s_raw[MAX_TAP_NUM], q_s_raw[MAX_TAP_NUM];      // Raw I/Q samples minus DC bias
volatile int16_t a_s_raw[MAX_TAP_NUM];             // Raw MIC samples, minus DC bias








/**************************************************************************************
 * AGC reference level is log2(0x40) = 6, where 0x40 is the MSB of half DAC_RANGE
 * 1/AGC_DECAY and 1/AGC_ATTACK are multipliers before agc_gain value integrator
 * These values should ultimately be set by the HMI.
 * The time it takes to a gain change is the ( (Set time)/(signal delta) ) / samplerate
 * So when delta is 1, and attack is 64, the time is 64/15625 = 4msec (fast attack)
 * The decay time is about 100x this value
 * Slow attack would be about 4096
 **************************************************************************************/
volatile int32_t peak_avg_shifted=0;     // signal level detector after AGC = average of positive values
volatile int16_t peak_avg_diff_accu=0;   // Log peak level integrator
volatile uint16_t agc_gain=((AGC_GAIN_MAX/2u)+1u);   // AGC gain/attenuation - starts at the middle
uint16_t volatile fft_gain[HMI_NUM_OPT_MEMORY] = {(1<<FFT_GAIN_SHIFT)};  //16
/*
 * AGC_REF is the level the loop hunts, in units of k, so the target average of
 * agc_a_sample is 2^AGC_REF .. 2^(AGC_REF+1).
 * The smallest output the loop can reach is (a_sample * agc_gain) / 2^AGC_GAIN_SHIFT,
 * and agc_gain cannot go below 1, so the strongest reachable signal that still has an
 * equilibrium is a_sample < 2^AGC_GAIN_SHIFT * 2^(AGC_REF+1).
 * With AGC_REF=3 that ceiling was only 1024, so any stronger signal had NO equilibrium:
 * k stayed above AGC_REF for ever, the attack ran to the end and the AGC latched at the
 * minimum gain, giving a weak audio that never recovered. AGC_REF=5 raises the ceiling to
 * 4096 and also lands the audio near the top of DAC_RANGE instead of 20 dB below it.
 */
#define AGC_REF		5u
#define AGC_DECAY	8192u
#define AGC_ATTACK_FAST	 32u  //64
#define AGC_ATTACK_SLOW	 128u  //4096
#define AGC_GAIN_STEP    1u
#define AGC_OFF		32766u
volatile uint16_t agc_decay  = AGC_OFF;
volatile uint16_t agc_attack = AGC_OFF;
void dsp_setagc(int agc)
{
	switch(agc)
	{
	case 1:		//SLOW, for values see hmi.c
		agc_attack = AGC_ATTACK_SLOW;
		agc_decay  = AGC_DECAY;
		break;
	case 2:		//FAST
		agc_attack = AGC_ATTACK_FAST;
		agc_decay  = AGC_DECAY;
		break;
	default: 	//OFF
		agc_attack = AGC_OFF;
		agc_decay  = AGC_OFF;
		break;
	}
}




uint16_t mode_filter_tap_num = CW_BPF_TAP_NUM;
int16_t *mode_filter_taps = cw_bpf_taps;

/**************************************************************************************
 * MODE is modulation/demodulation 
 * This setting steers the signal processing branch chosen
 **************************************************************************************/
uint16_t dsp_mode;				// For values see hmi.c, assume {USB,LSB,AM,CW}
void dsp_setmode(int mode)  //MODE_USB=0 MODE_LSB=1  MODE_AM=2  MODE_CW=3
{
	dsp_mode = (uint16_t)mode;

  //mode filter selection
  //MODE_USB=0 MODE_LSB=1  MODE_AM=2  MODE_CW=3
  if(dsp_mode < 2)  //SSB
  {
    mode_filter_tap_num = SSB_LPF_TAP_NUM;      // band pass filter for SSB
    mode_filter_taps = ssb_lpf_taps;
  }
  else if(dsp_mode == MODE_AM)  //AM
  {
    mode_filter_tap_num = AM_LPF_TAP_NUM;      // band pass filter for AM
    mode_filter_taps = am_lpf_taps;
  }
  else  //CW
  {
    mode_filter_tap_num = CW_BPF_TAP_NUM;      // band pass filter for CW
    mode_filter_taps = cw_bpf_taps;
  }
}

int dsp_getmode(void)
{
  return(dsp_mode);
}


/**************************************************************************************
 * VOX LINGER is the number of 16us cycles to wait before releasing TX mode
 * The level of detection is related to the maximum ADC range.
 **************************************************************************************/
#define VOX_LINGER		500000/16
#define VOX_HIGH		ADC_BIAS/2
#define VOX_MEDIUM		ADC_BIAS/4
#define VOX_LOW			ADC_BIAS/16
#define VOX_OFF			0
volatile uint16_t vox_count;
volatile uint16_t vox_level = VOX_OFF;
void dsp_setvox(int vox)
{
	switch(vox)
	{
	case 1:
		vox_level = VOX_LOW;
		break;
	case 2:
		vox_level = VOX_MEDIUM;
		break;
	case 3:
		vox_level = VOX_HIGH;
		break;
	default: 
		vox_level = VOX_OFF;
		vox_count = 0;
		break;
	}
}










//the AD sample frequency is as high as possible to get information for FFT bandwidth
//there shoud be a hardware low pass filter 
//the audio sample is as high as possible to make easy to filter the undesirable (sample) freq on output hardware low pass filter (only RC filter)
//with audio sample freq too much high, there is no time to process each sample (and the low pass FIR need more taps)
//the DMA copy a block of samples from AD to  adc_samp[]
//the size of the block is how much the sample frequency must be divided to get the audio samples frequency
//ADC sample frequency = 480kHz, but for 3 samples = I, Q and MIC   resulting 160kHz of sample freq for each one
//the audio sample freq could rise to 32kHz  but with critical time conditions, changed to 16kHz  (care must be taken when including code)
// 160kHz / 16kHz  = BLOCK_NSAMP = 30 samples / block  (10 samples for each I Q and MIC)
//the DMA will interrupt @16kHz with 30 samples saved on adc_samp[]
//the last samples from adc_samp[] will be summed to generate an audio sample. This is also a low pass filter for audio samples.
//   the number of samples summed to generate the audio sample = 10   to make a low pass <10kHz
//all samples have a bias value (half of Vref) and for digital filter an FFT they will be shifted to zero, removing the bias value
//the audio samples are taken always, every time DMA interrupt, 
//fft_samp[] is a buffer for the FFT samples 
//the samples for FFT are taken from time to time when FFT to waterfall graphic is ready with last samples
//there are some extra previous samples for FFT/Hilbert/Graph because to calculate the first result, it needs some previous samples
#define BLOCK_NSAMP    (FSAMP/FSAMP_AUDIO)    //block = 480k / 16k = 30 samples
#define BLOCK_NSET     (BLOCK_NSAMP/3)        //block = 10 sets of 3 samples
#define NBLOCK       ((FFT_NSAMP+(BLOCK_NSET-1)) / BLOCK_NSET)  // number of blocks necessary for FFT  320 / 30 = 10.666  =11
#if LOW_PASS_16KHZ == LOW_PASS_16KHZ_AVERAGE_SUM
#define ADC_NUM_BLOCK  (2u)  //save last 2 blocks
#define ADC_NUM_BLOCK_MASK  (1u)  // 0 - 1
#endif
#if LOW_PASS_16KHZ == LOW_PASS_16KHZ_FIR
#define ADC_NUM_BLOCK  (8u)  //save last 8 blocks
#define ADC_NUM_BLOCK_MASK  (7u)  // 0 - 7
#endif
volatile int16_t adc_samp[ADC_NUM_BLOCK][BLOCK_NSAMP] = { 0 };  //samples buffer    0-1 used for I and Q  3=MIC=VOX  [NL][NCOL]
volatile uint16_t adc_samp_block_pos = 0;       //actual sample block reading by ADC and DMA
volatile uint16_t adc_samp_last_block_pos = 0;  //last sample block read
#if LOW_PASS_16KHZ == LOW_PASS_16KHZ_FIR
volatile uint16_t adc_samp_last_block_pos3 = 0;  //last sample block read
volatile uint16_t adc_samp_last_block_pos2 = 0;  //last sample block read
volatile uint16_t adc_samp_last_block_pos1 = 0;  //last sample block read
#endif
volatile int16_t adc_samp_sum[ADC_NUM_BLOCK][3] = { 0 };  //save the sum of each block  12 bits = 0-4095 * 10  must fit in 16 bits

//bias = samples average = DC component, used to remome the DC from the samples
#define AVG_BIAS_SHIFT  8  //16   
volatile int32_t adc_result_bias[3] = { (ADC_BIAS << AVG_BIAS_SHIFT), (ADC_BIAS << AVG_BIAS_SHIFT), (ADC_BIAS << AVG_BIAS_SHIFT) };  //bias starts at the middle
volatile int16_t adc_result[3];   //

#define FFT_NUM_BLOCK   (NBLOCK + 2u)  // number of blocks FFT + HILBERT_TAP_NUM = 15 = fit in 2*blocks=20
volatile int16_t fft_samp[FFT_NUM_BLOCK][BLOCK_NSAMP];  //samples buffer for FFT and waterfall    only 0-1 used for I and Q  (3=MIC)  [NL][NCOL]
volatile uint16_t fft_samp_block_pos = 0;    
volatile uint16_t fft_samples_ready = 0;  //all buffer filled
volatile uint16_t fft_display_graf_new = 0;   //new data for graphic ready

volatile int16_t aud_samp[AUD_NUM_VAR][AUD_NUM_SAMP];  //samples buffer for audio process, filter and demodulation
volatile uint16_t aud_samp_block_pos = 0;    
volatile uint16_t aud_samples_state = AUD_STATE_SAMP_IN;  //filling buffer

volatile uint16_t i_int, j_int;
volatile uint16_t cw_int_count=0;  //used to count 2 times the 16kHz int to generate the 8kHz for CW (only for CW reception)
#if TX_METHOD == PHASE_AMPLITUDE    // uSDX TX method used for Class E RF amplifier
volatile uint16_t st_int_count=0;
#endif
//volatile uint32_t hmi_freq_fft = 0xff;

/************************************************************************************** 
 * CORE1:  DMA IRQ
 * dma handler - IRQ when a block of samples was read
 * take a block of samples, calculate average for I Q MIC and store data for FFT
 * it takes < 28us (1/16kHz = 62.5us)
 **************************************************************************************/
void __not_in_flash_func(dma_handler)(void)
//void dma_handler() __attribute__ ((section (".scratch_x.")));
//void dma_handler() 
{
  //*** the next DMA instructions must happen as fast as possible
  //*** do not include anything here

  // Clear the interrupt request.
  dma_hw->ints0 = 1u << dma_chan;
  // Give the channel a new wave table entry to write to, and re-trigger it
  dma_channel_set_write_addr(dma_chan, &adc_samp[adc_samp_block_pos][0], true);
  

  //gpio_set_mask(1<<14);   //GP14 (GPIO14 used for PTT CW time extension)



  //prepare I Q and MIC audio samples
  //sum last samples to make a low frequency average sample (160kHz to 16kHz sample freq)


  // average method used for BIAS:
  // example:  average result = average value x4 = ave_x4
  //           ave_x4 += new_value - (ave_x4/4)



  //init first sum = value  
  i_int=0;

  // bias = samples average = DC value from the samples  (it is always positive)
  adc_result_bias[0] += (int16_t)(adc_samp[adc_samp_last_block_pos][i_int] - (adc_result_bias[0] >> AVG_BIAS_SHIFT));
  // remove bias (avg) from samples
  adc_samp[adc_samp_last_block_pos][i_int] -= (adc_result_bias[0] >> AVG_BIAS_SHIFT);
  // sum of last 10 samples = all block
#if LOW_PASS_16KHZ == LOW_PASS_16KHZ_AVERAGE_SUM
  adc_samp_sum[adc_samp_last_block_pos][0] = adc_samp[adc_samp_last_block_pos][i_int]; //block samples sum to subsample at lower frequency (it is a low pass filter too)  
#endif
  i_int++;


  // bias = samples average = DC value from the samples  (it is always positive)
  adc_result_bias[1] += (int16_t)(adc_samp[adc_samp_last_block_pos][i_int] - (adc_result_bias[1] >> AVG_BIAS_SHIFT));
  // remove bias (avg) from samples
  adc_samp[adc_samp_last_block_pos][i_int] -= (adc_result_bias[1] >> AVG_BIAS_SHIFT);
  // sum of last 10 samples = all block
#if LOW_PASS_16KHZ == LOW_PASS_16KHZ_AVERAGE_SUM
  adc_samp_sum[adc_samp_last_block_pos][1] = adc_samp[adc_samp_last_block_pos][i_int]; //block samples sum to subsample at lower frequency (it is a low pass filter too)
#endif
  i_int++;


  // bias = samples average = DC value from the samples  (it is always positive)
  adc_result_bias[2] += (int16_t)(adc_samp[adc_samp_last_block_pos][i_int] - (adc_result_bias[2] >> AVG_BIAS_SHIFT));
  // remove bias (avg) from samples
  adc_samp[adc_samp_last_block_pos][i_int] -= (adc_result_bias[2] >> AVG_BIAS_SHIFT);
  // sum of last 10 samples = all block
  adc_samp_sum[adc_samp_last_block_pos][2] = adc_samp[adc_samp_last_block_pos][i_int]; //block samples sum to subsample at lower frequency (it is a low pass filter too)
  i_int++;



  //sum += value
  //save the samples sum for each block to make easy to get the last 16 samples average (10=full block,  6=partial)
  for(; i_int<BLOCK_NSAMP; )
  {
    // bias = samples average = DC value from the samples  (it is always positive)
    adc_result_bias[0] += (int16_t)(adc_samp[adc_samp_last_block_pos][i_int] - (adc_result_bias[0] >> AVG_BIAS_SHIFT));
    // remove bias (avg) from samples
    adc_samp[adc_samp_last_block_pos][i_int] -= (adc_result_bias[0] >> AVG_BIAS_SHIFT);
    // sum of last 10 samples = all block
#if LOW_PASS_16KHZ == LOW_PASS_16KHZ_AVERAGE_SUM
    adc_samp_sum[adc_samp_last_block_pos][0] += adc_samp[adc_samp_last_block_pos][i_int]; //block samples sum to subsample at lower frequency (it is a low pass filter too)
#endif
    i_int++;


    // bias = samples average = DC value from the samples  (it is always positive)
    adc_result_bias[1] += (int16_t)(adc_samp[adc_samp_last_block_pos][i_int] - (adc_result_bias[1] >> AVG_BIAS_SHIFT));
    // remove bias (avg) from samples
    adc_samp[adc_samp_last_block_pos][i_int] -= (adc_result_bias[1] >> AVG_BIAS_SHIFT);
    // sum of last 10 samples = all block
#if LOW_PASS_16KHZ == LOW_PASS_16KHZ_AVERAGE_SUM
    adc_samp_sum[adc_samp_last_block_pos][1] += adc_samp[adc_samp_last_block_pos][i_int]; //block samples sum to subsample at lower frequency (it is a low pass filter too)
#endif
    i_int++;


    // bias = samples average = DC value from the samples  (it is always positive)
    adc_result_bias[2] += (int16_t)(adc_samp[adc_samp_last_block_pos][i_int] - (adc_result_bias[2] >> AVG_BIAS_SHIFT));
    // remove bias (avg) from samples
    adc_samp[adc_samp_last_block_pos][i_int] -= (adc_result_bias[2] >> AVG_BIAS_SHIFT);
    // sum of last 10 samples = all block
    adc_samp_sum[adc_samp_last_block_pos][2] += adc_samp[adc_samp_last_block_pos][i_int]; //block samples sum to subsample at lower frequency (it is a low pass filter too)
    i_int++;
  }





#if LOW_PASS_16KHZ == LOW_PASS_16KHZ_FIR


/*
Low pass filter with extra attenuation to avoid hearing some one >16kHz away (attenuate an strong station away a multiple of 16kHz)
sampling frequency: 160000 Hz
* 0 Hz - 4000 Hz
  gain = 1
* 13000 Hz - 80000 Hz
  desired attenuation = -63 dB  (extra attenuation)

The sampling is at 160kHz but for audio we only need 16kHz samples, so the filter is at 160kHz with the output generated at 16kHz (process 1x at each 16kHz)
*/
  adc_samp_sum[adc_samp_last_block_pos][0] = (int16_t)((
                                                        (adc_samp[adc_samp_last_block_pos3][21] * 29L) +
                                                        (adc_samp[adc_samp_last_block_pos3][24] * 59L) +
                                                        (adc_samp[adc_samp_last_block_pos3][27] * 114L) +
                                                        (adc_samp[adc_samp_last_block_pos2][0] * 195L) + 
                                                        (adc_samp[adc_samp_last_block_pos2][3] * 307L) + 
                                                        (adc_samp[adc_samp_last_block_pos2][6] * 453L) +
                                                        (adc_samp[adc_samp_last_block_pos2][9] * 635L) +
                                                        (adc_samp[adc_samp_last_block_pos2][12] * 849L) +
                                                        (adc_samp[adc_samp_last_block_pos2][15] * 1091L) +
                                                        (adc_samp[adc_samp_last_block_pos2][18] * 1353L) +
                                                        (adc_samp[adc_samp_last_block_pos2][21] * 1622L) +
                                                        (adc_samp[adc_samp_last_block_pos2][24] * 1885L) +
                                                        (adc_samp[adc_samp_last_block_pos2][27] * 2127L) +
                                                        (adc_samp[adc_samp_last_block_pos1][0] * 2334L) + 
                                                        (adc_samp[adc_samp_last_block_pos1][3] * 2493L) + 
                                                        (adc_samp[adc_samp_last_block_pos1][6] * 2593L) +
                                                        (adc_samp[adc_samp_last_block_pos1][9] * 2627L) +
                                                        (adc_samp[adc_samp_last_block_pos1][12] * 2593L) +
                                                        (adc_samp[adc_samp_last_block_pos1][15] * 2493L) +
                                                        (adc_samp[adc_samp_last_block_pos1][18] * 2334L) +
                                                        (adc_samp[adc_samp_last_block_pos1][21] * 2127L) +
                                                        (adc_samp[adc_samp_last_block_pos1][24] * 1885L) +
                                                        (adc_samp[adc_samp_last_block_pos1][27] * 1622L) +
                                                        (adc_samp[adc_samp_last_block_pos][0] * 1353L) +
                                                        (adc_samp[adc_samp_last_block_pos][3] * 1091L) +
                                                        (adc_samp[adc_samp_last_block_pos][6] * 849L) +
                                                        (adc_samp[adc_samp_last_block_pos][9] * 635L) +
                                                        (adc_samp[adc_samp_last_block_pos][12] * 453L) +
                                                        (adc_samp[adc_samp_last_block_pos][15] * 307L) +
                                                        (adc_samp[adc_samp_last_block_pos][18] * 195L) +
                                                        (adc_samp[adc_samp_last_block_pos][21] * 114L) +
                                                        (adc_samp[adc_samp_last_block_pos][24] * 59L) +
                                                        (adc_samp[adc_samp_last_block_pos][27] * 29L)   ) >> 13u);  // >>16  *8 to give some gain (on average sum it is *10)


  adc_samp_sum[adc_samp_last_block_pos][1] = (int16_t)((
                                                        (adc_samp[adc_samp_last_block_pos3][22] * 29L) +
                                                        (adc_samp[adc_samp_last_block_pos3][25] * 59L) +
                                                        (adc_samp[adc_samp_last_block_pos3][28] * 114L) +
                                                        (adc_samp[adc_samp_last_block_pos2][1] * 195L) + 
                                                        (adc_samp[adc_samp_last_block_pos2][4] * 307L) + 
                                                        (adc_samp[adc_samp_last_block_pos2][7] * 453L) +
                                                        (adc_samp[adc_samp_last_block_pos2][10] * 635L) +
                                                        (adc_samp[adc_samp_last_block_pos2][13] * 849L) +
                                                        (adc_samp[adc_samp_last_block_pos2][16] * 1091L) +
                                                        (adc_samp[adc_samp_last_block_pos2][19] * 1353L) +
                                                        (adc_samp[adc_samp_last_block_pos2][22] * 1622L) +
                                                        (adc_samp[adc_samp_last_block_pos2][25] * 1885L) +
                                                        (adc_samp[adc_samp_last_block_pos2][28] * 2127L) +
                                                        (adc_samp[adc_samp_last_block_pos1][1] * 2334L) + 
                                                        (adc_samp[adc_samp_last_block_pos1][4] * 2493L) + 
                                                        (adc_samp[adc_samp_last_block_pos1][7] * 2593L) +
                                                        (adc_samp[adc_samp_last_block_pos1][10] * 2627L) +
                                                        (adc_samp[adc_samp_last_block_pos1][13] * 2593L) +
                                                        (adc_samp[adc_samp_last_block_pos1][16] * 2493L) +
                                                        (adc_samp[adc_samp_last_block_pos1][19] * 2334L) +
                                                        (adc_samp[adc_samp_last_block_pos1][22] * 2127L) +
                                                        (adc_samp[adc_samp_last_block_pos1][25] * 1885L) +
                                                        (adc_samp[adc_samp_last_block_pos1][28] * 1622L) +
                                                        (adc_samp[adc_samp_last_block_pos][1] * 1353L) +
                                                        (adc_samp[adc_samp_last_block_pos][4] * 1091L) +
                                                        (adc_samp[adc_samp_last_block_pos][7] * 849L) +
                                                        (adc_samp[adc_samp_last_block_pos][10] * 635L) +
                                                        (adc_samp[adc_samp_last_block_pos][13] * 453L) +
                                                        (adc_samp[adc_samp_last_block_pos][16] * 307L) +
                                                        (adc_samp[adc_samp_last_block_pos][19] * 195L) +
                                                        (adc_samp[adc_samp_last_block_pos][22] * 114L) +
                                                        (adc_samp[adc_samp_last_block_pos][25] * 59L) +
                                                        (adc_samp[adc_samp_last_block_pos][28] * 29L)   ) >> 13u);  // >>16  *8 to give some gain (on average sum it is *10)

   


#if 0
  adc_samp_sum[adc_samp_last_block_pos][0] = (int16_t)(((adc_samp[adc_samp_last_block_pos1][3] * 304L) + 
                                                        (adc_samp[adc_samp_last_block_pos1][6] * 523L) +
                                                        (adc_samp[adc_samp_last_block_pos1][9] * 897L) +
                                                        (adc_samp[adc_samp_last_block_pos1][12] * 1366L) +
                                                        (adc_samp[adc_samp_last_block_pos1][15] * 1901L) +
                                                        (adc_samp[adc_samp_last_block_pos1][18] * 2454L) +
                                                        (adc_samp[adc_samp_last_block_pos1][21] * 2972L) +
                                                        (adc_samp[adc_samp_last_block_pos1][24] * 3394L) +
                                                        (adc_samp[adc_samp_last_block_pos1][27] * 3671L) +
                                                        (adc_samp[adc_samp_last_block_pos][0] * 3768L) +
                                                        (adc_samp[adc_samp_last_block_pos][3] * 3671L) +
                                                        (adc_samp[adc_samp_last_block_pos][6] * 3394L) +
                                                        (adc_samp[adc_samp_last_block_pos][9] * 2972L) +
                                                        (adc_samp[adc_samp_last_block_pos][12] * 2454L) +
                                                        (adc_samp[adc_samp_last_block_pos][15] * 1901L) +
                                                        (adc_samp[adc_samp_last_block_pos][18] * 1366L) +
                                                        (adc_samp[adc_samp_last_block_pos][21] * 897L) +
                                                        (adc_samp[adc_samp_last_block_pos][24] * 523L) +
                                                        (adc_samp[adc_samp_last_block_pos][27] * 304L)) >> 13u);  // >>16  *8 to give some gain (on average sum it is *10)

  
  
  adc_samp_sum[adc_samp_last_block_pos][1] = (int16_t)(((adc_samp[adc_samp_last_block_pos1][4] * 304L) + 
                                                        (adc_samp[adc_samp_last_block_pos1][7] * 523L) +
                                                        (adc_samp[adc_samp_last_block_pos1][10] * 897L) +
                                                        (adc_samp[adc_samp_last_block_pos1][13] * 1366L) +
                                                        (adc_samp[adc_samp_last_block_pos1][16] * 1901L) +
                                                        (adc_samp[adc_samp_last_block_pos1][19] * 2454L) +
                                                        (adc_samp[adc_samp_last_block_pos1][22] * 2972L) +
                                                        (adc_samp[adc_samp_last_block_pos1][25] * 3394L) +
                                                        (adc_samp[adc_samp_last_block_pos1][28] * 3671L) +
                                                        (adc_samp[adc_samp_last_block_pos][1] * 3768L) +
                                                        (adc_samp[adc_samp_last_block_pos][4] * 3671L) +
                                                        (adc_samp[adc_samp_last_block_pos][7] * 3394L) +
                                                        (adc_samp[adc_samp_last_block_pos][10] * 2972L) +
                                                        (adc_samp[adc_samp_last_block_pos][13] * 2454L) +
                                                        (adc_samp[adc_samp_last_block_pos][16] * 1901L) +
                                                        (adc_samp[adc_samp_last_block_pos][19] * 1366L) +
                                                        (adc_samp[adc_samp_last_block_pos][22] * 897L) +
                                                        (adc_samp[adc_samp_last_block_pos][25] * 523L) +
                                                        (adc_samp[adc_samp_last_block_pos][28] * 304L)) >> 13u);  // >>16  *8 to give some gain (on average sum it is *10)
#endif



#endif




  //choose between 8kHz and 16kHz(or 5333Hz) for audio process
  if((dsp_mode != MODE_CW) ||  //for SSB and AM  run the audio @ 16kHz
     (TX_ENABLED_OUT == true))     //run CW TX @16kHz  (good for side tone @16kHz with same output audio filter)  
  {
    

#if TX_METHOD == PHASE_AMPLITUDE    // uSDX TX method used for Class E RF amplifier

    if(TX_ENABLED_OUT == true)     //TX uses uSDX method  
    {
      //run TX @5333Hz  (uSDX method)
      st_int_count++;
      if(st_int_count >= 3)  //16kHz / 3 = 5333.33Hz    (it is 4800Hz in uSDX)
      {
        st_int_count = 0;
        
        // result = sum of last samples = average = low pass filter
        // low pass filter with the last samples average    4096 * 10  fits on  16 bits
        // (the signal should have freqs only < 8kHz  for use in the FIR low pass filter @16kHz sample freq)
        adc_result[0] = adc_samp_sum[adc_samp_last_block_pos][0];   // = 10x input signal, 12bits x 10 = 16bits   (FFF * 10 = 9FF6)
        adc_result[1] = adc_samp_sum[adc_samp_last_block_pos][1];   // = 10x input signal, 12bits x 10 = 16bits   (FFF * 10 = 9FF6)
        adc_result[2] = adc_samp_sum[adc_samp_last_block_pos][2] >> 3u;  // /8 instead of /10 = little gain
      
        // invoque FIFO IRQ on Core0 to use the adc_result[] audio sample (there is no time for all in one core)
        multicore_fifo_push_blocking(FIFO_IQ_SAMPLE);    
      }
    }
    else  //RX and not CW, audio = 16kHz
    {
      // result = sum of last samples = average = low pass filter
      // low pass filter with the last samples average    4096 * 10  fits on  16 bits
      // (the signal should have freqs only < 8kHz  for use in the FIR low pass filter @16kHz sample freq)
      adc_result[0] = adc_samp_sum[adc_samp_last_block_pos][0];   // = 10x input signal, 12bits x 10 = 16bits   (FFF * 10 = 9FF6)
      adc_result[1] = adc_samp_sum[adc_samp_last_block_pos][1];   // = 10x input signal, 12bits x 10 = 16bits   (FFF * 10 = 9FF6)
      adc_result[2] = adc_samp_sum[adc_samp_last_block_pos][2] >> 3u;  // /8 instead of /10 = little gain
    
      // invoque FIFO IRQ on Core0 to use the adc_result[] audio sample (there is no time for all in one core)
      multicore_fifo_push_blocking(FIFO_IQ_SAMPLE);
    }

#endif


#if TX_METHOD == I_Q_QSE 

    // result = sum of last samples = average = low pass filter
    // low pass filter with the last samples average    4096 * 10  fits on  16 bits
    // (the signal should have freqs only < 8kHz  for use in the FIR low pass filter @16kHz sample freq)
    adc_result[0] = adc_samp_sum[adc_samp_last_block_pos][0];   // = 10x input signal, 12bits x 10 = 16bits   (FFF * 10 = 9FF6)
    adc_result[1] = adc_samp_sum[adc_samp_last_block_pos][1];   // = 10x input signal, 12bits x 10 = 16bits   (FFF * 10 = 9FF6)
    adc_result[2] = adc_samp_sum[adc_samp_last_block_pos][2] >> 3u;  // /8 instead of /10 = little gain


//normal use  -  with display, switches and dial
//#if MODE_STREAM_SERIAL == 0

      // invoque FIFO IRQ on Core0 to use the adc_result[] audio sample (there is no time for all in one core)
    multicore_fifo_push_blocking(FIFO_IQ_SAMPLE);

//#endif

//send I Q and FFT data through serial - stream serial mode
//#if MODE_STREAM_SERIAL == 1


//puts the I qnd Q


//#endif


#endif

  }
  else  // for CW RX run the audio @ 8kHz  (to give more time for narrow filter with many taps  and also reduce the number of taps)
  {    
  
    if(cw_int_count == 0)   //first of two blocks for CW @ 8kHz
    {
      cw_int_count = 1;
    }
    else   //second block for CW @ 8kHz
    {
      // result = sum of last samples = average = low pass filter
      // low pass filter with the last samples average    4096 * 10  fits on  16 bits

      // average from last 2 blocks
      adc_result[0] = (int16_t)((int32_t)(adc_samp_sum[0][0]) + 
                                (int32_t)(adc_samp_sum[1][0]))>>1;
      // average from last 2 blocks
      adc_result[1] = (int16_t)((int32_t)(adc_samp_sum[0][1]) + 
                                (int32_t)(adc_samp_sum[1][1]))>>1;
/*      
      // average from last 4 blocks
      adc_result[0] = (uint16_t)((uint32_t)(adc_samp_sum[0][0]) + 
                                 (uint32_t)(adc_samp_sum[1][0]) +
                                 (uint32_t)(adc_samp_sum[2][0]) +
                                 (uint32_t)(adc_samp_sum[3][0]))>>2;
      // average from last 4 blocks
      adc_result[1] = (uint16_t)((uint32_t)(adc_samp_sum[0][1]) + 
                                 (uint32_t)(adc_samp_sum[1][1]) +
                                 (uint32_t)(adc_samp_sum[2][1]) +
                                 (uint32_t)(adc_samp_sum[3][1]))>>2;
*/
      adc_result[2] = adc_samp_sum[adc_samp_last_block_pos][2] >> 3u;  // /8 instead of /10 = little gain  (mic not used in CW)
    
      // invoque FIFO IRQ on Core0 to use the adc_result[] audio sample (there is no time for all in one core)
      multicore_fifo_push_blocking(FIFO_IQ_SAMPLE); 
  
      cw_int_count = 0;
    }

  }




  //collect FFT raw samples
  if(fft_samples_ready == 0)  //receiving the samples
  {
/*
    if(hmi_freq != hmi_freq_fft)   //freq must be the same for all fft samples - if freq changing, wait
    {
      fft_samp_block_pos = 0;
      hmi_freq_fft = hmi_freq;
    }
*/
    //copy new samples to FFT buffer  (raw adc sample values for FFT)
    for(i_int=0; i_int<BLOCK_NSAMP; )
    {  
      fft_samp[fft_samp_block_pos][i_int] = adc_samp[adc_samp_last_block_pos][i_int];
      i_int++;
      fft_samp[fft_samp_block_pos][i_int] = adc_samp[adc_samp_last_block_pos][i_int];
      i_int++;
      fft_samp[fft_samp_block_pos][i_int] = adc_samp[adc_samp_last_block_pos][i_int];   // MIC is not necessary, but lets save it too
      i_int++;
    }
    
    fft_samp_block_pos++;
    if(fft_samp_block_pos >= FFT_NUM_BLOCK)
    {
      fft_samples_ready = 1;
    }
  }
  else if(fft_samples_ready == 1)  //waiting FFT to end
  {
       //just wait
  }
  else // fft_samples_ready == 2  ready with graphic
  {
    //start filling FFT samples buffer over again
    fft_samp_block_pos = 0;
    fft_samples_ready = 0;
  }







  //prepare next block position
#if LOW_PASS_16KHZ == LOW_PASS_16KHZ_FIR  
  adc_samp_last_block_pos3 = adc_samp_last_block_pos2;  //16kHz LP FIR use one more block
  adc_samp_last_block_pos2 = adc_samp_last_block_pos1;  //16kHz LP FIR use one more block
  adc_samp_last_block_pos1 = adc_samp_last_block_pos;  //16kHz LP FIR use one more block
#endif
  adc_samp_last_block_pos = adc_samp_block_pos;
  adc_samp_block_pos++;   // = avg_num_block_pos;
  adc_samp_block_pos&=ADC_NUM_BLOCK_MASK;



  //time counter
  if(++tim_count_loc >= (FSAMP_AUDIO/1000u))   // DMA 16kHz / 16 = 1kHz = 1ms
  {
    tim_count++;       // 1ms time counter
    tim_count_loc = 0;
  }

   
//  gpio_clr_mask(1<<14);  //GPIO14
  
}








  static bool ptt_internal_active_old = false;

/************************************************************************************** 
 * CORE0:  FIFO IRQ
 * FIFO IRQ handler - IRQ when FIFO push from Core1
 * in worst case, it takes < 54us (1/16kHz = 62.5us)  **  caution to include more code
 * 
 **************************************************************************************/
// 
void core0_irq_handler() 
{
           
  gpio_set_mask(1<<LED_BUILTIN);


  //after handling the interrupt, we need to clear it
  //do it at the begin in case this handler takes more time,
  //the new irq will be treated just after this one
  multicore_fifo_clear_irq();


  
  // check if there is data in FIFO (should have)
  if(multicore_fifo_rvalid()) 
  {
    // pop the data from FIFO stack
    (void)multicore_fifo_pop_blocking();


    //run the application for vox, rx and tx here in the irq
    //it must be treated as soon as possible

    //earlier set of the TX relays circuit path (setting again bellow)
    if (ptt_external_active)    //if GP_PTT_IN == 0, copy GP_PTT_IN to GP_PTT_OUT
      gpio_clr_mask(1<<GP_PTT_OUT);   //0 = TX
  
    //use audio samples
    ptt_vox_active = vox();     // Compress + store sample audio + check level    if (VOX enable and audio)  vox = true
    ptt_internal_active = ptt_vox_active || ptt_mon_active || ptt_aud_active;

    if (ptt_external_active || ptt_internal_active)                      //tx active (ptt_in == 0)
    {
      tx_enabled_extra_cnt = 0;                         //no cw delay
    }
    else if(tx_enabled)   //was TX and now it is RX
    {
      if (dsp_mode == MODE_CW)                 //tx delay only on CW
        tx_enabled_extra_cnt = TX_ENABLED_EXTRA_CNT;             //em CW conta o hang, nos outros modos vai direto a "terminado"
      else
        tx_enabled_extra_cnt = 0;
    }
    else if (tx_enabled_extra_cnt > 0)
    {
        tx_enabled_extra_cnt--;                         //conta o hang a cada amostra
    }

    tx_enabled = (ptt_external_active || ptt_internal_active);

    //commanded to TX through PTT or internally (VOX, mon, audio play)
    if (TX_ENABLED_OUT == true)   //(TX mode + audio) or (TX mode without audio)
    {
      gpio_clr_mask(1<<GP_PTT_OUT);   //0 = TX

#if TX_METHOD == PHASE_AMPLITUDE    // uSDX TX method used for Class E RF amplifier
      uSDX_TX_PhaseAmpl();
#endif
#if TX_METHOD == I_Q_QSE 
      tx();
#endif
    }
    else
    {
      gpio_set_mask(1<<GP_PTT_OUT);   //1 = RX

      rx();
    }

    ptt_internal_active_old = ptt_internal_active;
  }

         
  gpio_clr_mask(1<<LED_BUILTIN);

}








#define HILBERT_TAP_NUM  15u  //Hilbert filter 15 taps  fixed value   it uses values from 0 to 14

//  int16_t out_sample_;
//  int16_t out_sobe_;


/************************************************************************************** 
 * CORE0: inside DMA IRQ 
 * rx
 * Execute RX branch signal processing, max time to spend is <16us, i.e. rate is 62.5 kHz
 * No ADC sample interleaving, read both I and Q channels.
 * The delay is only 2us per conversion, which causes less distortion than interpolation of samples.
 **************************************************************************************/
volatile int16_t i_s[HILBERT_TAP_NUM], q_s[HILBERT_TAP_NUM];					// Filtered I/Q samples
volatile int16_t i_dc, q_dc; 						// DC bias for I/Q channel
//bool rx() __attribute__ ((section (".scratch_x.")));
volatile int16_t q_sample, i_sample, a_sample;
volatile int16_t agc_a_sample, abs_a_sample,  avg_a_sample,max_a_sample, display_a_sample;;
volatile int16_t smeter_display_time;
bool rx(void) 
{
  int16_t out_sample;
	int32_t q_accu, i_accu;
	int32_t qh;   // the Hilbert sum before it can exceed 32767, an int16_t here wraps and corrupts a_sample
	uint16_t i;
	uint16_t k;
	int32_t lvl_log;

//  gpio_set_mask(1<<LED_BUILTIN);


	/*
   * Store new sample
	 * Attenuate with AGC feedback from AUDIO GENERATION stage
	 * This behavior in essence is exponential, complementing the logarithmic peak detector
	 */
/*
#ifdef EXCHANGE_I_Q
  // Take last ADC 0 result, connected to Q input  (16 bits size)
  i_sample = ((int32_t)(agc_gain * fft_gain[hmi_mem]) * (int32_t)adc_result[0])>>(AGC_GAIN_SHIFT + FFT_GAIN_SHIFT);
  // Take last ADC 1 result, connected to I input  (16 bits size)
  q_sample = ((int32_t)(agc_gain * fft_gain[hmi_mem]) * (int32_t)adc_result[1])>>(AGC_GAIN_SHIFT + FFT_GAIN_SHIFT);
#else
  // Take last ADC 0 result, connected to Q input  (16 bits size)
  q_sample = ((int32_t)(agc_gain * fft_gain[hmi_mem]) * (int32_t)adc_result[0])>>(AGC_GAIN_SHIFT + FFT_GAIN_SHIFT);
  // Take last ADC 1 result, connected to I input  (16 bits size)
  i_sample = ((int32_t)(agc_gain * fft_gain[hmi_mem]) * (int32_t)adc_result[1])>>(AGC_GAIN_SHIFT + FFT_GAIN_SHIFT);
#endif
*/
#ifdef EXCHANGE_I_Q
  // Take last ADC 0 result, connected to I input  (16 bits size)
  i_sample = adc_result[0];
  // Take last ADC 1 result, connected to Q input  (16 bits size)
  q_sample = adc_result[1];
#else
  // Take last ADC 0 result, connected to Q input  (16 bits size)
  q_sample = adc_result[0];
  // Take last ADC 1 result, connected to I input  (16 bits size)
  i_sample = adc_result[1];
#endif


  /*
   * IIR filter: dc = a*sample + (1-a)*dc  where a = 1/128
   * Amplitude of samples should fit inside [-2048, 2047]
   */
  /* 
   * Shift-in I and Q raw samples 
   */
  for (i=0; i<(mode_filter_tap_num-1u); i++)
  {
    q_s_raw[i] = q_s_raw[i+1];          // Q raw samples shift register
    i_s_raw[i] = i_s_raw[i+1];          // I raw samples shift register
  }
  q_s_raw[(mode_filter_tap_num-1u)] = q_sample;              // Store in shift registers
  i_s_raw[(mode_filter_tap_num-1u)] = i_sample;


  q_accu = 0;                   // Initialize accumulators
  i_accu = 0;
  for (i=0; i<mode_filter_tap_num; i++)             // Low pass FIR filter
  {
    q_accu += (int32_t)q_s_raw[i]*mode_filter_taps[i];
    i_accu += (int32_t)i_s_raw[i]*mode_filter_taps[i];
  }
  q_accu = q_accu >> FILTER_SHIFT;
  i_accu = i_accu >> FILTER_SHIFT;


  for (i=0; i<(HILBERT_TAP_NUM-1u); i++)               // Shift decimated samples
  {
    q_s[i] = q_s[i+1];
    i_s[i] = i_s[i+1];
  }
	q_s[(HILBERT_TAP_NUM-1u)] = q_accu;
	i_s[(HILBERT_TAP_NUM-1u)] = i_accu;


if(aud_samples_state == AUD_STATE_SAMP_IN)    //store variables for scope graphic
  {
    aud_samp[AUD_SAMP_I][aud_samp_block_pos] = i_accu;
    aud_samp[AUD_SAMP_Q][aud_samp_block_pos] = q_accu;
  }


	/*** DEMODULATION ***/
  //MODE_USB=0 MODE_LSB=1  MODE_AM=2  MODE_CW=3
	switch (dsp_mode)
	{
	case MODE_USB:											//USB
		/* 
		 * USB demodulate: I[7] - Qh,
		 * Qh is Classic Hilbert transform 15 taps, 12 bits (see Iowa Hills calculator)
		 */	
		q_accu = (q_s[0]-q_s[14])*315L + (q_s[2]-q_s[12])*440L + (q_s[4]-q_s[10])*734L + (q_s[6]-q_s[ 8])*2202L;
		qh = q_accu >> 12;  // / 4096L;	
		a_sample = i_s[7] - qh;  // 7 = (HILBERT_TAP_NUM-1)/2
		break;
	case MODE_LSB:											//LSB
		/* 
		 * LSB demodulate: I[7] + Qh,
		 * Qh is Classic Hilbert transform 15 taps, 12 bits (see Iowa Hills calculator)
		 */	
		q_accu = (q_s[0]-q_s[14])*315L + (q_s[2]-q_s[12])*440L + (q_s[4]-q_s[10])*734L + (q_s[6]-q_s[ 8])*2202L;
		qh = q_accu >> 12;  // / 4096L;	
		a_sample = i_s[7] + qh;  // 7 = (HILBERT_TAP_NUM-1)/2
		break;
	case MODE_AM:											//AM
		/*
		 * AM demodulate: sqrt(sqr(i)+sqr(q))
		 * Approximated with MAG(i,q)
		 */
		a_sample = MAG(i_s[(HILBERT_TAP_NUM-1)], q_s[(HILBERT_TAP_NUM-1)]);  //MAG from the last filtered I Q sample
    //a_sample = i_sample;  //MAG from the last filtered I Q sample
		break;
  case MODE_CW:                     // CW
    /*
     * Rx CW = LSB
     */	
    q_accu = (q_s[0]-q_s[14])*315L + (q_s[2]-q_s[12])*440L + (q_s[4]-q_s[10])*734L + (q_s[6]-q_s[ 8])*2202L;
    qh = q_accu >> 12;  // / 4096L;  
    a_sample = i_s[7] + qh;  // 7 = (HILBERT_TAP_NUM-1)/2     
    break;
  default:
		break;
	}



  /***  S Meter audio peak detector ***/
  /*  
  when show S-meter on display
       show max_a_sample
       smeter_display = 1

  */


  /***  S Meter audio peak detector ***/
  /* after calculation of a_sample without AGC */
  //abs_a_sample = ABS(a_sample);
  //avg_a_sample += abs_a_sample;
  //avg_a_sample >>= 1;

  avg_a_sample -= (avg_a_sample >> 2);
  avg_a_sample += (ABS(a_sample) >> 2);



  if(smeter_display_time < MAX_SMETER_DISPLAY_TIME)   //for some time, look for the bigger signal
  {
    if(avg_a_sample > max_a_sample)  //bigger than displayed (if the value is bigger, print on display right now)
    {
      max_a_sample = avg_a_sample;  //save the bigger audio signal received
      if(max_a_sample > display_a_sample)  //bigger than displayed (if the value is bigger, print on display right now)
      {
        smeter_display_time = MAX_SMETER_DISPLAY_TIME;  //indicate the new (bigger) value is ready to show at display
      }
    }
    else
    {
      smeter_display_time++;  //count time
    }
  }



  // CwDecoder - save the audio level to analize on hmi.cpp
  if(dsp_mode == MODE_CW)
  {
    cw_rx_avg += avg_a_sample;  //average 40 samples = ((1/16kHz) * 40) = 2.5ms
    if(++cw_rx_cnt >= MAX_CW_RX_CNT)  // 40 samples to average
    {
      cw_rx[cw_rx_index][cw_rx_array] = (cw_rx_avg >> 5); // save the 2.5ms average on array for further analysis  (40 samples / 32 - I don't like to make divisions)
      cw_rx_avg = 0;
      cw_rx_cnt = 0;

      if(++cw_rx_index >= MAX_CW_RX_INDEX)  // 40 averages of 2.5ms saved on array = 100ms
      {
        if(cw_rx_array==0)  // 0 or 1   change the array  (one array is to fill, another to analize/show on display)
          { cw_rx_array = 1; }
        else
          { cw_rx_array = 0; }

        cw_rx_index = 0;
      }
    }
  }




  // apply AGC after filters
  agc_a_sample = ((int32_t)(agc_gain * fft_gain[hmi_mem]) * (int32_t)a_sample)>>(AGC_GAIN_SHIFT + FFT_GAIN_SHIFT);
  
	/*** AUDIO GENERATION ***/
	/*
	 * AGC, peak detector
	 * Sample speed is 16k per second
	 */
// average method, results ave_x4 = average value x 4
  // int ave_x4 += new_value - (ave_x4/4)
  // done in 32 bits on purpose: agc_a_sample can reach -32768 and the old (int16_t)
  // casts turned ABS(32768) back into -32768, driving this average negative.
  {
    int32_t lvl_abs = (agc_a_sample < 0) ? -(int32_t)agc_a_sample : (int32_t)agc_a_sample;
    peak_avg_shifted += (lvl_abs - (peak_avg_shifted >> PEAK_AVG_SHIFT));
    if(peak_avg_shifted < 0)
    {
      peak_avg_shifted = 0;
    }
  }

  //log2 of the level, k = 0 to 15, one k is one octave (6 dB).
  //lvl_log must be 32 bits and never negative: a negative value assigned to an
  //unsigned i wrapped to 65535 and read as k=15, the maximum attack, latching the AGC.
  k = 0;
  lvl_log = peak_avg_shifted >> PEAK_AVG_SHIFT;
  if(lvl_log < 0)
  {
    lvl_log = 0;
  }
  if (lvl_log&0xff00) {k+=8; lvl_log>>=8;}		// Logarithmic peak detection
  if (lvl_log&0x00f0) {k+=4; lvl_log>>=4;}    // k=log2(peak), find highest bit set
  if (lvl_log&0x000c) {k+=2; lvl_log>>=2;}    // results k = 0 - 15
  if (lvl_log&0x0002) {k+=1;}

  //integrator, (Acc += Xn - R). R is AGC_REF, so the loop hunts the level that
  //brings k back onto AGC_REF.
  peak_avg_diff_accu += ((int32_t)k - (int32_t)AGC_REF);

  //anti wind up. With agc_gain already on a limit the loop can no longer reach its
  //target, so the integrator must stop charging in that direction. Without this the
  //integrator winds up to the limit of the int16_t and the AGC stays stuck there
  //instead of parking, which is what a strong signal used to do.
  if((agc_gain <= AGC_GAIN_STEP) && (peak_avg_diff_accu > 0))
  {
    peak_avg_diff_accu = 0;
  }
  else if((agc_gain >= (AGC_GAIN_MAX - AGC_GAIN_STEP)) && (peak_avg_diff_accu < 0))
  {
    peak_avg_diff_accu = 0;
  }

	if (peak_avg_diff_accu > (int32_t)agc_attack)						// Attack time, gain correction in case of high level
	{
    if(agc_gain>AGC_GAIN_STEP)
    {
      agc_gain-=AGC_GAIN_STEP;               // Decrease gain
    }
    else
    {
      agc_gain = AGC_GAIN_STEP;
    }
		peak_avg_diff_accu -= (int32_t)agc_attack;						// Reset integrator
	} 
  else if (peak_avg_diff_accu < -(int32_t)agc_decay)		// Decay time, gain correction in case of low level
  {
    if(agc_gain<(AGC_GAIN_MAX-AGC_GAIN_STEP))  //2u)) 
    {
      agc_gain+=AGC_GAIN_STEP;               // Increase gain
    }
    else
    {
      agc_gain = AGC_GAIN_MAX;
    }
		peak_avg_diff_accu += (int32_t)agc_decay;						// Reset integrator
  }


	/*
	 * Scale and clip output,  
	 * Send to audio DAC output
	 */
	out_sample = agc_a_sample + DAC_BIAS;			// Add bias level
	if (out_sample > (int16_t)DAC_RANGE)						// Clip to DAC range
		out_sample = DAC_RANGE;
	else if (out_sample<0)
		out_sample = 0;


  if(Aud_Play_Spk == AUDIO_RUNNING)
  {
    //if((audio_play_pos < AUDIO_BUF_MAX) &&
    if(audio_play_pos < audio_rec_pos)
    {
      pwm_set_chan_level(dac_audio, PWM_CHAN_A, audio_buf[audio_play_pos]);  //rx audio out
      audio_play_pos++;
    }
    else
    {
      Aud_Play_Spk = AUDIO_STOPPED;
    }
  }
  else
  {
    /* audio output in normal use */
    pwm_set_chan_level(dac_audio, PWM_CHAN_A, out_sample);  //rx audio out

    if(Aud_Rec_Rx == AUDIO_RUNNING)
    {
      if(audio_rec_pos < AUDIO_BUF_MAX)
      {
        audio_buf[audio_rec_pos] = out_sample;
        audio_rec_pos++;
      }
      else
      {
        Aud_Rec_Rx = AUDIO_STOPPED;
      }
    }
  }




#if 0
  if(out_sobe_ == 0)
  {
    out_sample_-=50;
    if(out_sample_ < 0)
    {
      out_sample_ = 0;
      out_sobe_ = 1;
    }
  }
  else
  {
    out_sample_+=50;                                                                                                                                                                                                                                                                                                                                                                        0;
    if(out_sample_ > 255)
    {
      out_sample_ = 255;
      out_sobe_ = 0;
    }    
  }

  pwm_set_chan_level(dac_audio, PWM_CHAN_A, (out_sample_&0xff));
#endif




  //store variables for scope graphic
  if(aud_samples_state == AUD_STATE_SAMP_IN)
  {
    aud_samp[AUD_SAMP_A][aud_samp_block_pos] = agc_a_sample>>1;
    aud_samp[AUD_SAMP_PEAK][aud_samp_block_pos] = k;  //peak_avg_shifted>>PEAK_AVG_SHIFT;
    aud_samp[AUD_SAMP_GAIN][aud_samp_block_pos] = agc_gain>>2;   //>>2 so the 1..64 range fits the -25..25 graph scale

    if(++aud_samp_block_pos >= AUD_NUM_SAMP)
    {
      aud_samp_block_pos = 0;
      aud_samples_state = AUD_STATE_SAMP_RDY;
    }
  }






//  gpio_clr_mask(1<<LED_BUILTIN);


	return true;
}


/************************************************************************************** 
 * compress - audio compression input= -+2048 output= -+1024  reducing values above -+512
 **************************************************************************************/
#define COMPRESS_BASE  2040
const int16_t vcompress[2] = {0+(COMPRESS_BASE/4), (COMPRESS_BASE/4)+(COMPRESS_BASE/8)};

int16_t compress(int16_t mic_sample)
{
  for(int16_t i=0; i<2; i++)
  {
    //IF(C10>(E$4+E$5);((C10-(E$4+E$5))/2)+(E$4+E$5)
    if(mic_sample > vcompress[i])
    {
      mic_sample = ((mic_sample - vcompress[i])>>1) + vcompress[i];
    }
    //IF(C10<-(E$4+E$5);((C10+(E$4+E$5))/2)-(E$4+E$5)
    else if(mic_sample < -vcompress[i])
    {
      mic_sample = ((mic_sample + vcompress[i])>>1) - vcompress[i];
    }
    //C10
  }
  return mic_sample;
}




/************************************************************************************** 
 * CORE0: inside DMA IRQ 
 * The VOX function is called separately every cycle, to check audio level.
 * Execute TX branch signal processing when tx enabled
 **************************************************************************************/
//bool vox() __attribute__ ((section (".scratch_x.")));
bool vox(void)
{
  static int16_t a_level=0;							// Average level of raw sample stream
	int16_t vox_sample;
	uint i;

	/*
	 * Get sample and shift into delay line
   * samples already subtracted from bias
	 */
	vox_sample = adc_result[2];						// Get latest ADC 2 result

  /* audio compression resulting -+2048   (1 bit less than ADC) */
  vox_sample = compress(vox_sample);


  //store variables for scope graphic
  if(aud_samples_state == AUD_STATE_SAMP_IN)  
  {
    aud_samp[AUD_SAMP_MIC][aud_samp_block_pos] = vox_sample>>3;  //ADC 12 bits = 4096 steps  ->  9 bits = 512 steps
  }

 

	/*
	 * Store new raw sample
	 * IIR filter: dc = a*sample + (1-a)*dc  where a = 1/128
	 */
	for (i=0; i<(mode_filter_tap_num-1u); i++) 							//   and store in shift register
		a_s_raw[i] = a_s_raw[i+1];
	a_s_raw[mode_filter_tap_num-1u] = vox_sample;  //audio from MIC = ADC 12 bits = 4096 steps


  if(dsp_mode != MODE_CW)   //no vox at CW
  {
  	if (vox_level != VOX_OFF)						// Only when VOX is enabled
  	{
      /*
      * Detect level of audio signal
      * Return true if VOX enabled and:
      * - Audio level higher than threshold 
      * - Linger time sill active 
      */
      vox_sample = ABS(vox_sample);   // Absolute value
    	//a_level += (vox_sample - a_level)/128;			//   running average, 16usec * 128 = 2msec
      a_level += (vox_sample - a_level)>>7u;      //   running average, 16usec * 128 = 2msec
  
  		if (a_level > vox_level)
  		{
  			vox_count = VOX_LINGER;					// While audio present, reset linger timer
  			return(true);							//  and keep TX active
  		}
  		if (vox_count>0)
  		{
  			vox_count--;							// No audio; decrement linger timer
  			return(true);							//  but keep TX active
  		}
  	}
  }

 
	return(false);									// All other cases: no TX
}










// 666.66Hz cw tone @ 16kHz sample freq 
#define CW_TONE_NUM  24
int16_t cw_tone_to_play_pos = 0;
// ADC_RANGE 4095  >>4 = DAC_RANGE 255
//int16_t cw_tone_to_play[CW_TONE_NUM] = {0,  529, 1023,  1447,  1773,  1977,  2047,  1977,  1773,  1447,  1023,  529, -1,  -530,  -1024, -1448, -1774, -1978, -2048, -1978, -1774, -1448, -1024, -530}; 
int16_t cw_tone_to_play[CW_TONE_NUM] = {0, 518, 1000, 1414, 1732, 1932, 2000, 1932, 1732, 1414, 1000, 517, 0, -518, -1000, -1415, -1732, -1932, -2000, -1932, -1732,  -1414,  -1000,  -517};
// max -2000 to 2000     to fit at 255  ->  cw_tone_to_play[] >> 4  (the filter makes << 4)
//int16_t cw_tone_to_play[CW_TONE_NUM] = {0, 31, 60, 85, 104, 116, 120, 116, 104, 85, 60, 31, 0, -31, -60, -85, -104, -116, -120, -116, -104,  -85,  -60,  -31};
volatile int16_t a_s[HILBERT_TAP_NUM];							// Filtered and decimated samples

/************************************************************************************** 
 * CORE0: inside DMA IRQ
 * Tx 
 **************************************************************************************/
//bool tx() __attribute__ ((section (".scratch_x.")));
void tx(void) 
{
  int32_t a_accu, q_accu;
  int16_t qh=0;
  uint i;
  uint16_t i_dac, q_dac;
    

  if(Aud_Play_Tx == AUDIO_RUNNING)
  {
    if(audio_play_pos < audio_rec_pos)
    {
      a_accu = ((int32_t)audio_buf[audio_play_pos]-DAC_BIAS) << IQ_TX_ATTENUATION;  //undo the output IQ attenuation

      for (i=0; i<(HILBERT_TAP_NUM-1); i++)              // Shift decimated samples
        a_s[i] = a_s[i+1];
      a_s[(HILBERT_TAP_NUM-1)] = a_accu;             // Store rescaled accumulator

      audio_play_pos++;
    }
    else
    {
      Aud_Play_Tx = AUDIO_STOPPED;
    }
  }
  else  //normal tx
  {

    //MODE_USB=0 MODE_LSB=1  MODE_AM=2  MODE_CW=3
    if(dsp_mode != MODE_CW)  //no audio input filter for TX CW - audio out direct generated
    {
      /*** RAW Audio SAMPLES from VOX function ***/
      /*** Low pass filter ***/
      //sample already saved at a_s_raw[] in vox()
      a_accu = 0;                   // Initialize accumulator
      for (i=0; i<mode_filter_tap_num; i++)              // Low pass FIR filter, using raw samples
        a_accu += (int32_t)a_s_raw[i]*mode_filter_taps[i];   
      for (i=0; i<(HILBERT_TAP_NUM-1); i++)              // Shift decimated samples
        a_s[i] = a_s[i+1];
      a_s[(HILBERT_TAP_NUM-1)] = (a_accu >> FILTER_SHIFT);             // Store rescaled accumulator
    }

  }
    


  /*** MODULATION ***/
  //mode_USB=0 mode_LSB=1  mode_AM=2  mode_CW=3
  switch (dsp_mode)
  {
  case MODE_USB:											// USB
    /* 
    * qh is Classic Hilbert transform 15 taps, 12 bits (see Iowa Hills calculator)
    */	
    q_accu = (a_s[0]-a_s[14])*315L + (a_s[2]-a_s[12])*440L + (a_s[4]-a_s[10])*734L + (a_s[6]-a_s[ 8])*2202L;
    qh = -(q_accu >> 12);   // / 4096L; 						// USB: sign is negative
    break;
  case MODE_LSB:											// LSB
    /* 
    * qh is Classic Hilbert transform 15 taps, 12 bits (see Iowa Hills calculator)
    */	
    q_accu = (a_s[0]-a_s[14])*315L + (a_s[2]-a_s[12])*440L + (a_s[4]-a_s[10])*734L + (a_s[6]-a_s[ 8])*2202L;
    qh = (q_accu >> 12);     // / 4096L; 						// LSB: sign is positive
    break;
  case MODE_AM:											// AM
    /*
    * I and Q values are identical
    */
    qh = a_s[7];
    break;
  case MODE_CW:                     // CW

    if(Aud_Play_Tx == AUDIO_RUNNING)
    {
        /* play audio CW as LSB */
        q_accu = (a_s[0]-a_s[14])*315L + (a_s[2]-a_s[12])*440L + (a_s[4]-a_s[10])*734L + (a_s[6]-a_s[ 8])*2202L;
        qh = (q_accu >> 12);     // / 4096L; 						// LSB: sign is positive        
    }
    else  //normal tx
    {
      if(tx_enabled_extra_cnt == 0)    //tom ativo
      {
        /*
        * Tx CW I=0 Q=tone
        */
        cw_tone_to_play_pos++;
        if(cw_tone_to_play_pos >= CW_TONE_NUM)
        {
          cw_tone_to_play_pos = 0;
        }
        qh = cw_tone_to_play[cw_tone_to_play_pos];  //it uses a 4096 range, similar to the filters output (it makes >>4 below)
        i = cw_tone_to_play_pos + (CW_TONE_NUM/4);  // 90 degrees
        if(i >= CW_TONE_NUM)
        {
          i -= CW_TONE_NUM;
        }
        a_s[7] = cw_tone_to_play[i]; //it uses a 4096 range, similar to the filters output (it makes >>4 below)

        //audio side tone
        pwm_set_chan_level(dac_audio, PWM_CHAN_A, (cw_tone_to_play[cw_tone_to_play_pos]>>6)+DAC_BIAS);  //>>4 = max value, more >>2 to attenuate the side tone sound level
        //pwm_set_chan_level(dac_audio, PWM_CHAN_A, ((a_s_raw[mode_filter_tap_num-1u]>>4)+DAC_BIAS));  //>>4 = max value, more >>2 to attenuate the side tone sound level
      }
      else
      {
        qh = 0;
        a_s[7] = 0;
        pwm_set_chan_level(dac_audio, PWM_CHAN_A, DAC_BIAS);
      }
    }
    break;
  default:
    break;
  }


  if(aud_samples_state == AUD_STATE_SAMP_IN)    //store variables for scope graphic
    {
      aud_samp[AUD_SAMP_I][aud_samp_block_pos] = qh>>2;
      aud_samp[AUD_SAMP_Q][aud_samp_block_pos] = a_s[7]>>2;
    }
  

  /* 
  * Write I and Q to QSE DACs, phase is 7 samples back.
  * Need to multiply AC with DAC_RANGE/ADC_RANGE (appr 1/16)
  * Any case: clip to range
  */
  a_accu = DAC_BIAS + (qh>>IQ_TX_ATTENUATION);  //5);  //>>4 to change from ADC 4096 range to 256 PWM range  (>>4 seems saturate)
  if (a_accu<0)
    q_dac = 0;
  else if (a_accu>(int16_t)(DAC_RANGE))
    q_dac = DAC_RANGE;
  else
    q_dac = a_accu;
  
  a_accu = DAC_BIAS + (a_s[7]>>IQ_TX_ATTENUATION);  //5);  //>>4 to change from ADC 4096 range to 256 PWM range  (>>4 seems saturate)
  if (a_accu<0)
    i_dac = 0;
  else if (a_accu>(int16_t)(DAC_RANGE))
    i_dac = DAC_RANGE;
  else
    i_dac = a_accu;
    


  // pwm_set_both_levels(dac_iq, q_dac, i_dac);		// Set both channels of the IQ slice simultaneously
  // pwm_set_chan_level(dac_iq, PWM_CHAN_A, q_dac);
  // pwm_set_chan_level(dac_iq, PWM_CHAN_B, i_dac);
  pwm_set_gpio_level(21, i_dac);
  pwm_set_gpio_level(20, q_dac);



  if(Aud_Play_Tx == AUDIO_RUNNING)
  {
    //audio feedback when audio play TX
    pwm_set_chan_level(dac_audio, PWM_CHAN_A, q_dac);
  }

  if((Aud_Rec_Tx == AUDIO_RUNNING) &&
     (audio_rec_pos < AUDIO_BUF_MAX))
  {
    audio_buf[audio_rec_pos] = i_dac;
    audio_rec_pos++;
/*
    if(ptt_external_active == false)
    {
      Aud_Rec_Tx = AUDIO_STOPPED;
    }
*/  
  }
	
//pwm_set_chan_level(dac_audio, PWM_CHAN_A, i_dac);  //debug LSB to audio out
//pwm_set_chan_level(dac_audio, PWM_CHAN_A, q_dac);  //debug LSB to audio out

  //store variables for scope graphic
  if(aud_samples_state == AUD_STATE_SAMP_IN)
  {
    //aud_samp[AUD_SAMP_A][aud_samp_block_pos] = a_sample>>1;
    //aud_samp[AUD_SAMP_PEAK][aud_samp_block_pos] = k;  //peak_avg_shifted>>PEAK_AVG_SHIFT;
    //aud_samp[AUD_SAMP_GAIN][aud_samp_block_pos] = agc_gain>>2;   //>>2 so the 1..64 range fits the -25..25 graph scale

    if(++aud_samp_block_pos >= AUD_NUM_SAMP)
    {
      aud_samp_block_pos = 0;
      aud_samples_state = AUD_STATE_SAMP_RDY;
    }
  }



//	return true;
}









int16_t fft_i_s[HILBERT_TAP_NUM], fft_q_s[HILBERT_TAP_NUM];          // Filtered I/Q samples
kiss_fft_scalar fft_in_minus[FFT_NSAMP]; // kiss_fft_scalar is a float
kiss_fft_scalar fft_in_plus[FFT_NSAMP]; // kiss_fft_scalar is a float
kiss_fft_cpx fft_out[FFT_NSAMP];
kiss_fftr_cfg fft_cfg; // = kiss_fftr_alloc(FFT_NSAMP,false,0,0);
int32_t qh;  // same Hilbert sum, an int16_t here wraps and corrupts fft_in_minus/fft_in_plus (the waterfall)
uint16_t block_num;
uint16_t block_pos;
uint16_t aux_c1 = 0;
uint16_t i_c1, j_c1;
/************************************************************************************** 
 * CORE1: 
 * Timing loop, triggered through inter-core fifo 
 **************************************************************************************/
//void dsp_core1_setup_and_loop() __attribute__ ((section (".scratch_x.")));
void dsp_core1_setup_and_loop()
{

  //**************
  //Core1 setup
  //**************




  //bus_ctrl_hw->priority = BUSCTRL_BUS_PRIORITY_PROC1_BITS; // Set Core 1 prio high
  // Grant high bus priority to the DMA, so it can shove the processors out
  // of the way. This should only be needed if you are pushing things up to
  // >16bits/clk here, i.e. if you need to saturate the bus completely.
  bus_ctrl_hw->priority = BUSCTRL_BUS_PRIORITY_DMA_W_BITS | BUSCTRL_BUS_PRIORITY_DMA_R_BITS;


  multicore_lockout_victim_init();

  
  
  //fft setup
  fft_cfg = kiss_fftr_alloc(FFT_NSAMP,false,0,0);







  //analogReadResolution(12);
   
  // Initialize ADCs 
  adc_gpio_init(26);                // GP26 is ADC 0  Q
  adc_gpio_init(27);                // GP27 is ADC 1  I
  adc_gpio_init(28);                // GP28 is ADC 2  MIC
  adc_init();                       // Initialize ADC to known state
  adc_select_input(0);              // Start with ADC0  (AINSEL = 0)

  adc_set_round_robin(0x01+0x02+0x04);      // Sequence ADC 0-1-2 (GP 26, 27, 28) free running
  adc_fifo_setup(     // IRQ for every result (fifo threshold = 1)
    true,    // Write each completed conversion to the sample FIFO
    true,    // enable DMA data request (DREQ)
    1,       // DREQ (and IRQ) asserted when at least 1 sample present
    false,   // We won't see the ERR bit because of 8 bit reads; disable.
    false     // Keep full 12 bits of each sample
    //true     // Shift each sample to 8 bits when pushing to FIFO
    );
  adc_set_clkdiv(ADC_CLOCK_DIV);    // 480k / 3 channels = 160 kSps


  //irq_set_enabled(ADC0_IRQ_FIFO, true);   // [Philhower] disabled: no ADC ISR is installed anywhere in this sketch; on pico-sdk an unhandled enabled IRQ hangs its core. DMA DREQ alone drives the sample flow.



  // Configure a channel to write the same word (32 bits) repeatedly to PIO0
  // SM0's TX FIFO, paced by the data request signal from that peripheral.
  dma_chan = dma_claim_unused_channel(true);
  dma_channel_config cfg = dma_channel_get_default_config(dma_chan);
  channel_config_set_transfer_data_size(&cfg, DMA_SIZE_16);
  channel_config_set_read_increment(&cfg, false);
  channel_config_set_write_increment(&cfg, true);
  channel_config_set_dreq(&cfg, DREQ_ADC);

  dma_channel_configure(
      dma_chan,
      &cfg,
      &adc_samp[adc_samp_block_pos][0],   //dst
      &adc_hw->fifo,    // src
      BLOCK_NSAMP,        // Write the same value many times, then halt and interrupt
      true              // start immediately
  );

  // Tell the DMA to raise IRQ line 0 when the channel finishes a block
  dma_channel_set_irq0_enabled(dma_chan, true);

  // Configure the processor to run dma_handler() when DMA IRQ 0 is asserted
  irq_set_exclusive_handler(DMA_IRQ_0, dma_handler);


  // Clear the interrupt request.
  dma_hw->ints0 = 1u << dma_chan;
  
  irq_set_enabled(DMA_IRQ_0, true);

  // Manually call the handler once, to trigger the first transfer
  //dma_handler();




  for (i_c1=0; i_c1<10000; i_c1++) {  j_c1++; }   //wait core0 to be ready
  
  adc_run(true);

  
  

  //**************
	//Core1 loop
  //**************

 
  while(1) 
	{
  
//    gpio_set_mask(1<<14);

#if 0   /* if0dflash */

    if(DFLASH_in_use != 0)
    {
      uint32_t interrupts_Core1 = save_and_disable_interrupts();

      //adc_run(false);
      DFLASH_in_use = 2;
      while(DFLASH_in_use == 2);
      //adc_run(true);

      restore_interrupts(interrupts_Core1);      
    }    

#endif   /* if 0    if0dflash */


    //wait for FFT input data to be processed
    if((fft_samples_ready == 1) && //ready to start FFT with last samples
       (fft_display_graf_new == 0))
    {

#if 0  //send FFT samples to serial   it needs to use with extra serial on pins GP0 GP1

          
          if(++aux_c1 == 50)
          {
          
          
            
            Serialx.print("\n====== FFT =======\n");
          
            //fft_samp[NBLOCK_TOT][BLOCK_NSAMP]
            Serialx.print("FFT_NUM_BLOCK=");
            Serialx.print(FFT_NUM_BLOCK, DEC);
            Serialx.print(" BLOCK_NSAMP=");
            Serialx.print(BLOCK_NSAMP, DEC); 
            Serialx.print("\n");
              
            for(j_c1=0; j_c1<FFT_NUM_BLOCK; j_c1++)
            {
              for (i_c1=0; i_c1<BLOCK_NSAMP; i_c1+=3) 
                  {
                  Serialx.print((int)j_c1, DEC);
                  Serialx.print(",");
                  Serialx.print((int)i_c1, DEC);
                  Serialx.print(",");
                  Serialx.print((int)(fft_samp[j_c1][i_c1]), DEC);
                  Serialx.print(",");
                  Serialx.print((int)(fft_samp[j_c1][i_c1+1]), DEC);
                  Serialx.print(",");
                  Serialx.print((int)(fft_samp[j_c1][i_c1+2]), DEC);
                  Serialx.print(" ");
                  Serialx.print("\n");    
                  }
            }
            
            Serialx.print("====== fim =======\n");
          
          /* 
            
            for(j_c1=0; j_c1<FFT_NUM_BLOCK; j_c1++)
            {
              for (i_c1=0; i_c1<BLOCK_NSAMP; i_c1+=3) 
                  {
                  Serialx.print((int)j_c1, DEC);
                  Serialx.print(",");
                  Serialx.print((int)i_c1, DEC);
                  Serialx.print(",");
                  Serialx.print((int)(fft_samp[j_c1][i_c1]), DEC);
                  Serialx.print(",");
                  Serialx.print((int)(fft_samp[j_c1][i_c1+1]), DEC);
                  Serialx.print(",");
                  Serialx.print((int)(fft_samp[j_c1][i_c1+2]), DEC);
                  Serialx.print(" ");
                  Serialx.print("\n");    
                  }
            }
          
          */
          
           
          
          }



//        fft_display_graf_new = 0;  
//        fft_samples_ready = 2;  //ready to start new sample collect
  



#endif    //send FFT samples to serial 




//#if 0


//#if 0
      block_num = 0;   
      block_pos = 0;

      // Hilbert H(Q)
      // fill first samples to calculate the first Hilbert value
      for(j_c1=0; j_c1<HILBERT_TAP_NUM; j_c1++)
      {
#ifdef EXCHANGE_I_Q
        fft_i_s[j_c1] = (fft_gain[hmi_mem] * fft_samp[block_num][block_pos]) >> FFT_GAIN_SHIFT;   
        fft_q_s[j_c1] = (fft_gain[hmi_mem] * fft_samp[block_num][block_pos+1]) >> FFT_GAIN_SHIFT;;
#else
        fft_q_s[j_c1] = (fft_gain[hmi_mem] * fft_samp[block_num][block_pos]) >> FFT_GAIN_SHIFT;;   
        fft_i_s[j_c1] = (fft_gain[hmi_mem] * fft_samp[block_num][block_pos+1]) >> FFT_GAIN_SHIFT;;
#endif
        block_pos+=3;
        if(block_pos >= BLOCK_NSAMP)
        {
          block_num++;
          block_pos = 0; 
        }
      }
      for(j_c1=0; j_c1<FFT_NSAMP; j_c1++)
      {
        for (i_c1=0; i_c1<(HILBERT_TAP_NUM-1); i_c1++)   // Shift decimated samples
        {
          fft_q_s[i_c1] = fft_q_s[i_c1+1];
          fft_i_s[i_c1] = fft_i_s[i_c1+1];
        }
#ifdef EXCHANGE_I_Q
        fft_i_s[(HILBERT_TAP_NUM-1)] = (fft_gain[hmi_mem] * fft_samp[block_num][block_pos]) >> FFT_GAIN_SHIFT;
        fft_q_s[(HILBERT_TAP_NUM-1)] = (fft_gain[hmi_mem] * fft_samp[block_num][block_pos+1]) >> FFT_GAIN_SHIFT;
#else
        fft_q_s[(HILBERT_TAP_NUM-1)] = (fft_gain[hmi_mem] * fft_samp[block_num][block_pos]) >> FFT_GAIN_SHIFT;
        fft_i_s[(HILBERT_TAP_NUM-1)] = (fft_gain[hmi_mem] * fft_samp[block_num][block_pos+1]) >> FFT_GAIN_SHIFT;
#endif
     
        qh = ((int32_t)(fft_q_s[0]-fft_q_s[14])*315L + (int32_t)(fft_q_s[2]-fft_q_s[12])*440L + 
              (int32_t)(fft_q_s[4]-fft_q_s[10])*734L + (int32_t)(fft_q_s[6]-fft_q_s[ 8])*2202L) >> 12;  // / 4096L
        //qh = ((int32_t)(fft_q_s[0]-fft_q_s[14])*315 + (int32_t)(fft_q_s[2]-fft_q_s[12])*440 + 
        //      (int32_t)(fft_q_s[4]-fft_q_s[10])*734 + (int32_t)(fft_q_s[6]-fft_q_s[ 8])*2202) >> 12;  // / 4096L
        fft_in_minus[j_c1] = fft_i_s[7] - qh;  //USB
        fft_in_plus[j_c1] = fft_i_s[7] + qh;   //LSB


        block_pos+=3;
        if(block_pos >= BLOCK_NSAMP)
        {
          block_num++;
          block_pos = 0; 
        }          
      }
//#endif

#if 0
      block_num = 0;   
      block_pos = 0;
      
      for(j_c1=0; j_c1<FFT_NSAMP; j_c1++)  //320
      {
#ifdef EXCHANGE_I_Q
        fft_in_plus[j_c1] = fft_samp[block_num][block_pos];
        fft_in_minus[j_c1] = fft_samp[block_num][block_pos+1]; 
#else
        fft_in_minus[j_c1] = fft_samp[block_num][block_pos];
        fft_in_plus[j_c1] = fft_samp[block_num][block_pos+1]; 
#endif
        block_pos+=3;
        if(block_pos >= BLOCK_NSAMP)
        {
          block_num++;
          block_pos = 0; 
        }
      }
#endif

 


      // FFT  I - H(Q)
      kiss_fftr(fft_cfg , fft_in_minus, fft_out);  // ***  about 30ms


      // fill line for graphic  -band to 0
      for(i_c1=0; i_c1<FFT_NUMFREQ; i_c1++)
      {
        vet_graf_fft[(GRAPH_NUM_LINES-1)][(FFT_NUMFREQ-1)+i_c1] = mag_level(MAG(fft_out[i_c1].r, fft_out[i_c1].i));
      }

      
      // FFT  I + H(Q)
      kiss_fftr(fft_cfg , fft_in_plus, fft_out);  // ***  about 30ms


      // fill line for graphic  0 to +band
      for(i_c1=0; i_c1<FFT_NUMFREQ; i_c1++)
      {
        vet_graf_fft[(GRAPH_NUM_LINES-1)][FFT_NUMFREQ-i_c1] = mag_level(MAG(fft_out[i_c1].r, fft_out[i_c1].i));
      }



#if 0

          if(++aux_c1 == 20)
          {
                  Serialx.print("\n FFT \n");  

  
                  //fft_samp[FFT_NUM_BLOCK][BLOCK_NSAMP]
                  Serialx.print("fft_samp[FFT_NUM_BLOCK][BLOCK_NSAMP]    FFT_NUM_BLOCK=");
                  Serialx.print(FFT_NUM_BLOCK, DEC);  //13
                  Serialx.print("   BLOCK_NSAMP=");
                  Serialx.print(BLOCK_NSAMP, DEC);   //30
                  Serialx.print("\n");
                  Serialx.print("fft_in_minus[FFT_NSAMP]    FFT_NSAMP=");
                  Serialx.print(FFT_NSAMP, DEC);   //320
                  Serialx.print("    fft_out[FFT_NSAMP]     FFT_NSAMP=");
                  Serialx.print(FFT_NSAMP, DEC);   //320
                  Serialx.print("    FFT_NUMFREQ=");
                  Serialx.print(FFT_NUMFREQ, DEC);   //160
                  Serialx.print("\n");                  

                  for(i_c1=0; i_c1<FFT_NUMFREQ; i_c1++)
                  {
                  Serialx.print((int)i_c1, DEC);
                  Serialx.print(",");
                  Serialx.print((int)fft_in_minus[i_c1], DEC);
                  Serialx.print(",");  
                  Serialx.print((int)fft_out[i_c1].r, DEC);
                  Serialx.print(",");                    
                  Serialx.print((int)fft_out[i_c1].i, DEC);
                  Serialx.print(",");                    
                  Serialx.print((int)MAG(fft_out[i_c1].r, fft_out[i_c1].i), DEC);
                  
                  Serialx.print("\n");  
                  }   
          }


#endif


 
      //graphic data is ready for graphic plotting  
      fft_display_graf_new = 1;

//#endif


    }




      
//    gpio_clr_mask(1<<14);
   
  

  }
  
}





/************************************************************************************** 
 * CORE0: 
 * Initialize dsp context and spawn CORE1 process 
 *
 * Some CORE1 code parts should not run from Flash, but be loaded in SRAM at boot time
 * See platform.h for function qualifier macro's
 * for example: 
 * void __not_in_flash_func(funcname)(int arg1, float arg2)
 * {
 * }
 *
 * Need to set BUS_PRIORITY of Core 1 to high
 * #include bus_ctrl.h
 * bus_ctrl_hw->priority = BUSCTRL_BUS_PRIORITY_PROC1_BITS; // Set Core 1 prio high
 **************************************************************************************/
void dsp_init() 
{

  //uint16_t slice_num;


//  gpio_init_mask(1<<14);       //GPIO14
//  gpio_set_dir(14, GPIO_OUT); 

  
  tx_enabled = false;

  //analogWriteResolution(12);


 
  //https://forums.raspberrypi.com/viewtopic.php?t=306321
  // Initialize DACs, default mode is free running, A and B pins are output 
  gpio_set_function(20, GPIO_FUNC_PWM);     // GP20 is PWM for Q DAC (Slice 2, Channel A)
  gpio_set_function(21, GPIO_FUNC_PWM);     // GP21 is PWM for I DAC (Slice 2, Channel B)
  dac_iq = pwm_gpio_to_slice_num(20);       // Get PWM slice for GP20 (Same for GP21)
  pwm_set_clkdiv_int_frac (dac_iq, 1, 0);     // clock divide by 1 = 125MHz
  pwm_set_wrap(dac_iq, DAC_RANGE);        // Set cycle length; nr of counts until wrap, 125MHz / 255 = 490kHz
  pwm_set_enabled(dac_iq, true);            // Set the PWM running
  
  gpio_set_function(22, GPIO_FUNC_PWM);     // GP22 is PWM for Audio DAC (Slice 3, Channel A)
  dac_audio = pwm_gpio_to_slice_num(22);      // Find PWM slice for GP22
  pwm_set_clkdiv_int_frac (dac_audio, 1, 0);    // clock divide by 1 = 125MHz
  pwm_set_wrap(dac_audio, DAC_RANGE);     // Set cycle length; nr of counts until wrap, 125MHz / 255 = 490kHz
  pwm_set_enabled(dac_audio, true);         // Set the PWM running




    
  delay(500);  //required to run core1 - after tests
  multicore_launch_core1(dsp_core1_setup_and_loop);        // Start processing on core1
  delay(5);


  
  //after multicore_launch_core1  because it uses the FIFO
  //https://hackaday.io/page/9880-raspberry-pi-pico-multicore-adventures
  // set the SIO_IRQ_PROC1 (FIFO register set interrupt) ownership to only one core. Opposite to irq_set_shared_handler() function
  // We pass it the name of function that shall be executed when interrupt occurs
  // [Philhower] The core installs its own FIFO ISR on this IRQ at boot (rp2040.fifo.registerCore() in cores/rp2040/main.cpp);
  // claiming it exclusively without removing that one panics ("irq already claimed") and freezes the boot.
  // This sketch does not use the core FIFO helpers, so replacing it entirely is safe.
  irq_handler_t old_sio_handler = irq_get_exclusive_handler(SIO_IRQ_PROC0);
  if (old_sio_handler)
    irq_remove_handler(SIO_IRQ_PROC0, old_sio_handler);
  irq_set_exclusive_handler(SIO_IRQ_PROC0, core0_irq_handler);
  // We clear the interrupt flag, if it got set by a chance
  multicore_fifo_clear_irq();
  // enable interrupt
  irq_set_enabled(SIO_IRQ_PROC0, true);

}


/************************************************************************************** 
 * CORE0: 
 * Loop 
 *
 **************************************************************************************/
void dsp_loop()
{

//    gpio_set_mask(1<<14);
    



//   gpio_clr_mask(1<<14);  

}





#if 0


/*
FT8 - 
Input sample rate	16,000 Hz
Output rate	800 Hz
Decimation factor	20
Filter type	FIR low-pass
Number of taps	31
Cutoff frequency	~300 Hz
Normalized cutoff	0.0375 (300 / 8000)
These are 31-tap low-pass filter coefficients designed with a Hamming window (via Python scipy.signal.firwin, cutoff = 300 Hz):
Buffers 16 kHz input samples
Applies 31-tap FIR filter
Emits one filtered sample every 20 input samples → 800 Hz output

The accumulator is 32-bit, which is safe:
    Max input ~±32767
    Max coeff ~±528
    Max product per tap ≈ ±17M
    Total of 31 taps: ~±530M max (well within int32_t range)
The final >> 15 converts the Q15 result back to a standard integer.
This works great for audio-level or SDR signals, where I/Q samples are already in int16_t from an ADC or IQ converter.



 16kHz -> I/Q low pass 300Hz (31 coeff taps) -> 800Hz samples  (one 800Hz sample every 20 16kHz samples = 1.25ms ) 
 every 0, 15s, 30s, 45s: start buffer 
 buffer 128 samples 800Hz and inform FFT to run  (128 * (1/800) = 160ms = exact time of each symbol transmitted)
    FFT kiss_fft complex with I+jQ (not kiss_fftr)
    FFT results 64+64 slots of 6.25Hz
    show at the display waterfall (it will be just a line for each symbol, msg = 79 symbols on total)
    look at the 1-8 slot for signal to translate to FT8 symbol, convert to symbol (3bits), make a buffer
    after buffer complete, decode, convert to chars, show text to display
    if the msg is CQ, get the call sign, if it is an answer to your call, get the call sign

 buffer 128 samples 400Hz and inform FFT to run  (128 * (1/400) = 320ms)
    FFT NSAMP = FSAMP / FRES = 400 / 3.125 = 128
    FF NFREQ = FFT NSAMP / 2 = 128 / 2 = 64
    FFT results 64+64 slots of 3.125Hz
assim não da certo pq o sinal de 2 simbolos vão ficar misturados ja que cada um é transmitido por 160ms



setup for FT8
  edit msgs  %1=user call sign  %2=other call sign
  edit user call sign
  edit time clock on exact seconds (sinchronize the time clock with the received signal)
  signal report fixed or get from ???

start to use the Arduino Pro Mini DFlash? I2C commands to write/read NVM
when changing the MODE to FT8, it will open a msg area on the screen, for 5 msgs ? with scroll
use the rotary switch and enter to change the signal report or the line on screen?
when in FT8, try to receive, and show a the screen, if <enter> passes to answer/transmit engage the QSO

*/

#define TAPS 31
#define DECIMATE_FACTOR 20

// Shared FIR coefficients (Q15 format)
const int16_t firCoeffs[TAPS] = {
   -6,  -17,  -30,  -40,  -46,  -40,  -17,   29,
   97,  181,  270,  349,  401,  408,  360,  259,
  117,  -40, -200, -346, -459, -522, -528, -470,
 -353, -191,   -7,  170,  314,  404,  423
};

// FIR state for I channel
int16_t firBufferI[TAPS] = {0};
int firIndexI = 0;

// FIR state for Q channel
int16_t firBufferQ[TAPS] = {0};
int firIndexQ = 0;

int downsampleCounter = 0;

void processIQSample(int16_t sampleI, int16_t sampleQ) {
  // --- Store new samples into circular buffers ---
  firBufferI[firIndexI] = sampleI;
  firBufferQ[firIndexQ] = sampleQ;
  
  firIndexI = (firIndexI + 1) % TAPS;
  firIndexQ = (firIndexQ + 1) % TAPS;

  // --- Downsample logic ---
  if (++downsampleCounter == DECIMATE_FACTOR) {
    downsampleCounter = 0;

    int32_t accI = 0;
    int32_t accQ = 0;

    int indexI = firIndexI;
    int indexQ = firIndexQ;

    // --- FIR filtering for I and Q ---
    for (int i = 0; i < TAPS; i++) {
      indexI = (indexI - 1 + TAPS) % TAPS;
      indexQ = (indexQ - 1 + TAPS) % TAPS;

      accI += (int32_t)firBufferI[indexI] * firCoeffs[i];
      accQ += (int32_t)firBufferQ[indexQ] * firCoeffs[i];
    }

    // --- Convert Q15 back to int16_t ---
    int16_t outputI = accI >> 15;
    int16_t outputQ = accQ >> 15;

    // --- Send to FT8 or IQ processing ---
    handleFT8IQSample(outputI, outputQ);
  }
}

void handleFT8IQSample(int16_t I, int16_t Q) {
  // Store/process filtered I/Q samples at 800 Hz
}




// ******************************************

/*
For FT8
FT8 uses 8 tones, spaced 6.25 Hz apart (0 Hz to 50 Hz), so:
    You're interested in bins 1 to 8
    Bin 1 = 6.25 Hz
    Bin 8 = 50.00 Hz
Perfect match.
You just:
    Compute the FFT magnitude at each bin:
    magnitude=Re2+Im2
    magnitude=Re2+Im2
Or faster: power=Re2+Im2power=Re2+Im2
Look for the bin (1–8) with the highest energy to identify the current FT8 tone
*/

#include "kiss_fft.h"

#define FFT_SIZE 128

kiss_fft_cfg cfg;
kiss_fft_cpx in[FFT_SIZE];
kiss_fft_cpx out[FFT_SIZE];

void setup() {
  cfg = kiss_fft_alloc(FFT_SIZE, 0, 0, 0);
}

void computeFFT(int16_t I[], int16_t Q[]) {
  for (int i = 0; i < FFT_SIZE; i++) {
    in[i].r = I[i];  // Real part
    in[i].i = Q[i];  // Imag part
  }

  kiss_fft(cfg, in, out);

  // Analyze bins 1 to 8
  for (int k = 1; k <= 8; k++) {
    float power = out[k].r * out[k].r + out[k].i * out[k].i;
    // Store or compare power to find strongest tone
  }
}


/*
 Typical FT8 QSO Flow (Simplified)
Time	Message	              Direction	  Purpose
T+0s	CQ N0CALL FN31	      You → World	You announce you’re calling
T+15s	K1ABC N0CALL FN42	    K1ABC → You	Someone answers you
T+30s	N0CALL K1ABC -10	    You → K1ABC	You send them a signal report
T+45s	K1ABC N0CALL R-11	    K1ABC → You	They acknowledge and reply
T+60s	N0CALL K1ABC 73	      You → K1ABC	You send 73 (QSO done)

75 bits total
    28 bits: Callsign 1
    28 bits: Callsign 2
    15–19 bits: Grid or signal report or “73”
    
How FT8 Automatic Replies Work
In a typical QSO:
    You call CQ
    → Software listens for replies
    You receive a message like K1ABC N0CALL FN42
    → Software automatically detects:
        It’s a response to your CQ
        The other station's call is K1ABC
        You are N0CALL
    Software auto-generates reply
    → N0CALL K1ABC -10 (SNR report)
    Auto-timed transmission
    → Sent exactly at the next 15-second slot (T+30s)
    If they respond with R-10, your software replies with 73, etc.    
    
*/

#endif
