kaefe64/Arduino_uSDX_Pico_FFT_Proj/Arduino_uSDX_Pico_FFT/dsp_filters.h

#ifndef __DSP_FILTERS_H__
#define __DSP_FILTERS_H__

#ifdef __cplusplus
extern "C" {
#endif

/*

 * dsp_filters.h
 *
 * Created: Apr 2025
 * Author:  Klaus Fensterseifer 
 * https://github.com/kaefe64/Arduino_uSDX_Pico_FFT_Proj

   Digital filters taps arrays
   Values calculated from 
   http://t-filter.engineerjs.com/

*/



#if 0


/*

FIR filter designed with
http://t-filter.engineerjs.com/

sampling frequency: 8000 Hz

fixed point precision: 16 bits

* 0 Hz - 300 Hz
  gain = 0
  desired attenuation = -40 dB
  actual attenuation = n/a

* 500 Hz - 800 Hz
  gain = 1
  desired ripple = 5 dB
  actual ripple = n/a

* 1000 Hz - 4000 Hz
  gain = 0
  desired attenuation = -40 dB
  actual attenuation = n/a

*/
#define CW_BPF_TAP_NUM  57      // band pass filter for CW

static int16_t cw_bpf_taps[CW_BPF_TAP_NUM] = {
  125,
  -73,
  -79,
  -78,
  -56,
  -23,
  -5,
  -36,
  -133,
  -275,
  -397,
  -407,
  -222,
  180,
  731,
  1264,
  1564,
  1436,
  796,
  -269,
  -1499,
  -2525,
  -2982,
  -2643,
  -1517,
  133,
  1857,
  3153,
  3634,
  3153,
  1857,
  133,
  -1517,
  -2643,
  -2982,
  -2525,
  -1499,
  -269,
  796,
  1436,
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
};



#endif



#if 0

/*

FIR filter designed with
http://t-filter.engineerjs.com/

sampling frequency: 8000 Hz

fixed point precision: 16 bits

* 0 Hz - 200 Hz
  gain = 0
  desired attenuation = -40 dB
  actual attenuation = n/a

* 500 Hz - 800 Hz
  gain = 1
  desired ripple = 5 dB
  actual ripple = n/a

* 1100 Hz - 4000 Hz
  gain = 0
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
//filter_taps_700Hz,
filter_taps_800Hz,
filter_taps_1200Hz,
filter_taps_1600Hz,
filter_taps_2000Hz,
filter_taps_2400Hz,
filter_taps_2800Hz,
filter_taps_3200Hz,
filter_taps_3600Hz,
filter_taps_4000Hz,
filter_taps_4400Hz,
filter_taps_4800Hz
};






#ifdef __cplusplus
}
#endif
#endif
