kaefe64/Arduino_uSDX_Pico_FFT_Proj/uSDX_TX/uSDX_SI5351.cpp

//  Based on QCX-SSB.ino - https://github.com/threeme3/QCX-SSB
//
//  Copyright 2019, 2020, 2021   Guido PE1NNZ <pe1nnz@amsat.org>
//
//  Permission is hereby granted, free of charge, to any person obtaining a copy of this software and associated documentation files (the "Software"), to deal in the Software without restriction, including without limitation the rights to use, copy, modify, merge, publish, distribute, sublicense, and/or sell copies of the Software, and to permit persons to whom the Software is furnished to do so, subject to the following conditions: The above copyright notice and this permission notice shall be included in all copies or substantial portions of the Software. THE SOFTWARE IS PROVIDED "AS IS", WITHOUT WARRANTY OF ANY KIND, EXPRESS OR IMPLIED, INCLUDING BUT NOT LIMITED TO THE WARRANTIES OF MERCHANTABILITY, FITNESS FOR A PARTICULAR PURPOSE AND NONINFRINGEMENT. IN NO EVENT SHALL THE AUTHORS OR COPYRIGHT HOLDERS BE LIABLE FOR ANY CLAIM, DAMAGES OR OTHER LIABILITY, WHETHER IN AN ACTION OF CONTRACT, TORT OR OTHERWISE, ARISING FROM, OUT OF OR IN CONNECTION WITH THE SOFTWARE OR THE USE OR OTHER DEALINGS IN THE SOFTWARE.
//
//  Adapted by: Klaus Fensterseifer PY2KLA
//  https://github.com/kaefe64/Arduino_uSDX_Pico_FFT_Proj


#include "Arduino.h"
#include "uSDX_I2C.h"
#include "uSDX_SI5351.h"
#include "uSDX_TX_PhaseAmpl.h"





#define _MSC  0x10000


#define BB0(x) ((uint8_t)(x))           // Bash byte x of int32_t
#define BB1(x) ((uint8_t)((x)>>8))
#define BB2(x) ((uint8_t)((x)>>16))


//int32_t vdf[20];
//int16_t ndf = 0;


//***********************************************************************
//
//  class SI5351
//
//***********************************************************************


//***********************************************************************
  void FAST SI5351::freq_calc_fast(int16_t df)  // note: relies on cached variables: _msb128, _msa128min512, _div, _fout, fxtal
  {
    uint32_t msb128 = _msb128 + ((int64_t)(_div * (int32_t)df) * _MSC * 128) / fxtal;
//    uint32_t msb128 = _msb128 + (((int64_t)(_div * (int32_t)df) * _MSC) * 128L) / fxtal;
    //uint32_t msb128 = (((int64_t)(_div * (int32_t)df) * (int64_t)_MSC) * (int64_t)128) / (int64_t)fxtal;
//vdf[ndf&0x0f] = msb128;  ndf++;  ndf = ndf&0x000f;
    //msb128 += _msb128;
/*
vdf[0] = _msb128;
vdf[1] = _div;
vdf[2] = df;
vdf[3] = _MSC;
vdf[4] = fxtal;
vdf[5] = 0;
vdf[6] = msb128;
vdf[7] = 0;
vdf[8] = 0;
vdf[9] = 0;
vdf[10] = 0;
*/
    

    uint16_t msp1 = _msa128min512 + msb128 / _MSC; // = 128 * _msa + msb128 / _MSC - 512;
    uint16_t msp2 = msb128; // = msb128 % _MSC;  assuming MSC is covering exact uint16_t so the mod operation can dissapear (and the upper BB2 byte) // = msb128 - msb128/_MSC * _MSC;

    //pll_regs[0] = BB1(msc);  // 3 regs are constant
    //pll_regs[1] = BB0(msc);
    //pll_regs[2] = BB2(msp1);
    //pll_regs[3] = BB1(msp1);
    pll_regs[4] = BB0(msp1);
    pll_regs[5] = ((_MSC&0xF0000)>>(16-4))/*|BB2(msp2)*/; // top nibble MUST be same as top nibble of _MSC !  assuming that BB2(msp2) is always 0 -> so reg is constant
    pll_regs[6] = BB1(msp2);
    pll_regs[7] = BB0(msp2);
  }

//***********************************************************************
  void SI5351::SendPLLRegisterBulk(){
    i2c.start();
    i2c.SendByte(SI5351_ADDR << 1);
    i2c.SendByte(26+0*8 + 4);  // Write to PLLA
    //i2c.SendByte(26+1*8 + 4);  // Write to PLLB
    i2c.SendByte(pll_regs[4]);
    i2c.SendByte(pll_regs[5]);
    i2c.SendByte(pll_regs[6]);
    i2c.SendByte(pll_regs[7]);
    i2c.stop();
  }

  
//***********************************************************************
  void SI5351::SendRegister(uint8_t reg, uint8_t* data, uint8_t n){
    i2c.start();
    i2c.SendByte(SI5351_ADDR << 1);
    i2c.SendByte(reg);
    while (n--) i2c.SendByte(*data++);
    i2c.stop();      
  }
//***********************************************************************
  void SI5351::SendRegister(uint8_t reg, uint8_t val){ SendRegister(reg, &val, 1); }

 
//***********************************************************************
//  void SI5351::ms(int8_t n, uint32_t div_nom, uint32_t div_denom, uint8_t pll = PLLA, uint8_t _int = 0, uint16_t phase = 0, uint8_t rdiv = 0){
  void SI5351::ms(int8_t n, uint32_t div_nom, uint32_t div_denom, uint8_t pll, uint8_t _int, uint16_t phase, uint8_t rdiv){
    uint16_t msa; uint32_t msb, msc, msp1, msp2, msp3;
    msa = div_nom / div_denom;     // integer part: msa must be in range 15..90 for PLL, 8+1/1048575..900 for MS
    if(msa == 4) _int = 1;  // To satisfy the MSx_INT=1 requirement of AN619, section 4.1.3 which basically says that for MS divider a value of 4 and integer mode must be used
    msb = (_int) ? 0 : (((uint64_t)(div_nom % div_denom)*_MSC) / div_denom); // fractional part
    msc = (_int) ? 1 : _MSC;
    //lcd.setCursor(0, 0); lcd.print(n); lcd.print(":"); lcd.print(msa); lcd.print(" "); lcd.print(msb); lcd.print(" "); lcd.print(msc); lcd.print(F("    ")); delay(500);
    msp1 = 128*msa + 128*msb/msc - 512;
    msp2 = 128*msb - 128*msb/msc * msc;
    msp3 = msc;
    uint8_t ms_reg2 = BB2(msp1) | (rdiv<<4) | ((msa == 4)*0x0C);
    uint8_t ms_regs[8] = { BB1(msp3), BB0(msp3), ms_reg2, BB1(msp1), BB0(msp1), BB2(((msp3 & 0x0F0000)<<4) | msp2), BB1(msp2), BB0(msp2) };

    SendRegister(n*8+42, ms_regs, 8); // Write to MSx
    if(n < 0){
      SendRegister(n+16+8, 0x80|(0x40*_int)); // MSNx PLLn: 0x40=FBA_INT; 0x80=CLKn_PDN
    } else {
      //SendRegister(n+16, ((pll)*0x20)|0x0C|0|(0x40*_int));  // MSx CLKn: 0x0C=PLLA,0x2C=PLLB local msynth; 0=2mA; 0x40=MSx_INT; 0x80=CLKx_PDN
      SendRegister(n+16, ((pll)*0x20)|0x0C|3|(0x40*_int));  // MSx CLKn: 0x0C=PLLA,0x2C=PLLB local msynth; 3=8mA; 0x40=MSx_INT; 0x80=CLKx_PDN
      SendRegister(n+165, (!_int) * phase * msa / 90);      // when using: make sure to configure MS in fractional-mode, perform reset afterwards
    }
  }

//***********************************************************************
  void SI5351::phase(int8_t n, uint32_t div_nom, uint32_t div_denom, uint16_t phase){ SendRegister(n+165, phase * (div_nom / div_denom) / 90); }  // when using: make sure to configure MS in fractional-mode!, perform reset afterwards

//***********************************************************************
  void SI5351::reset(){ SendRegister(177, 0xA0); } // 0x20 reset PLLA; 0x80 reset PLLB

//***********************************************************************
  void SI5351::oe(uint8_t mask){ SendRegister(3, ~mask); } // output-enable mask: CLK2=4; CLK1=2; CLK0=1

//***********************************************************************
  void SI5351::freq(int32_t fout, uint16_t i, uint16_t q){  // Set a CLK0,1,2 to fout Hz with phase i, q (on PLLA)
      uint8_t rdiv = 0; // CLK pin sees fout/(2^rdiv)
      if(fout > 300000000){ i/=3; q/=3; fout/=3; }  // for higher freqs, use 3rd harmonic
      if(fout < 500000){ rdiv = 7; fout *= 128; } // Divide by 128 for fout 4..500kHz
      uint16_t d; if(fout < 30000000) d = (16 * fxtal) / fout; else d = (32 * fxtal) / fout;  // Integer part  .. maybe 44?
      if(fout < 3500000) d = (7 * fxtal) / fout;  // PLL at 189MHz to cover 160m (freq>1.48MHz) when using 27MHz crystal
      if(fout > 140000000) d = 4; // for f=140..300MHz; AN619; 4.1.3, this implies integer mode
      if(d % 2) d++;  // even numbers preferred for divider (AN619 p.4 and p.6)
      if( (d * (fout - 5000) / fxtal) != (d * (fout + 5000) / fxtal) ) d += 2; // Test if multiplier remains same for freq deviation +/- 5kHz, if not use different divider to make same
      uint32_t fvcoa = d * fout;  // Variable PLLA VCO frequency at integer multiple of fout at around 27MHz*16 = 432MHz
      // si5351 spectral purity considerations: https://groups.io/g/QRPLabs/message/42662

      ms(MSNA, fvcoa, fxtal);                   // PLLA in fractional mode
      //ms(MSNB, fvcoa, fxtal);
      ms(MS0,  fvcoa, fout, PLLA, 0, i, rdiv);  // Multisynth stage with integer divider but in frac mode due to phase setting
      ms(MS1,  fvcoa, fout, PLLA, 0, q, rdiv);

      ms(MS2,  fvcoa, fout, PLLA, 0, 0, rdiv);

      if(iqmsa != (((int8_t)i-(int8_t)q)*((int16_t)(fvcoa/fout))/90)){ iqmsa = ((int8_t)i-(int8_t)q)*((int16_t)(fvcoa/fout))/90; reset(); }
      oe(0b00000011);  // output enable CLK0, CLK1

      _fout = fout;  // cache
      _div = d;
      _msa128min512 = ((fvcoa / fxtal) * 128) - 512;
      _msb128=(((uint64_t)(fvcoa % fxtal)*_MSC)*128) / fxtal;
      //_mod = fvcoa % fxtal;
  }

//***********************************************************************
  void SI5351::freqb(uint32_t fout){  // Set a CLK2 to fout Hz (on PLLB)
      uint16_t d = (16 * fxtal) / fout;
      if(d % 2) d++;  // even numbers preferred for divider (AN619 p.4 and p.6)
      uint32_t fvcoa = d * fout;  // Variable PLLA VCO frequency at integer multiple of fout at around 27MHz*16 = 432MHz

      ms(MSNB, fvcoa, fxtal);
      ms(MS2,  fvcoa, fout, PLLB, 0, 0, 0);
  }
  

//***********************************************************************
  uint8_t SI5351::RecvRegister(uint8_t reg){
    i2c.start();  // Data write to set the register address
    i2c.SendByte(SI5351_ADDR << 1);
    i2c.SendByte(reg);
    i2c.stop();
    i2c.start(); // Data read to retrieve the data from the set address
    i2c.SendByte((SI5351_ADDR << 1) | 1);
    uint8_t data = i2c.RecvByte(true);
    i2c.stop();
    return data;
  }

//***********************************************************************
  void SI5351::powerDown(){
    SendRegister(3, 0b11111111); // Disable all CLK outputs
    SendRegister(24, 0b00010000); // Disable state: CLK2 HIGH state, CLK0 & CLK1 LOW state when disabled; CLK2 needs to be in HIGH state to make sure that cap to gate is already charged, preventing "exponential pulse is caused by CLK2, which had been at 0v whilst it was disabled, suddenly generating a 5vpp waveform, which is “added to” the 0v filtered PWM output and causing the output fets to be driven with the full 5v pp.", see: https://forum.dl2man.de/viewtopic.php?t=146&p=1307#p1307
    SendRegister(25, 0b00000000); // Disable state: LOW state when disabled
    for(int addr = 16; addr != 24; addr++) SendRegister(addr, 0b10000000);  // Conserve power when output is disabled
    SendRegister(187, 0);        // Disable fanout (power-safe)
    // To initialise things as they should:
    SendRegister(149, 0);        // Disable spread spectrum enable
    SendRegister(183, 0b11010010);  // Internal CL = 10 pF (default)
  }
