kaefe64/Arduino_uSDX_Pico_FFT_Proj/Arduino_uSDX_Pico_FFT/uSDR.cpp

/*
 * uSDR.c
 *
 * Created: Mar 2021
 * Author: Arjan te Marvelde 
 * May2022: adapted by Klaus Fensterseifer 
 * https://github.com/kaefe64/Arduino_uSDX_Pico_FFT_Proj
 * 
 * The application main loop
 * This initializes the units that do the actual work, and then loops in the background. 
 * Other units are:
 * - dsp.c, containing all signal processing in RX and TX branches. This part runs on the second processor core.
 * - si5351.c, containing all controls for setting up the si5351 clock generator.
 * - lcd.c, contains all functions to put something on the LCD
 * - hmi.c, contains all functions that handle user inputs
 */

#include "Arduino.h"

#include <Wire.h>
#include "uSDR.h"
#include "hmi.h"
#include "dsp.h"
#include "si5351.h"
#include "monitor.h"
#include "relay.h"
#include "TFT_eSPI.h"
#include "display_tft.h"





uint16_t tim_loc;     // local time 

void uSDR_setup0(void)  //main
{
  //RP2040 initialize the GPIOs as inputs with pulldown as default, and this is like PTT_OUT active 
  //it needs a strong pullup = 4K7 to 3v3 on pin GPIO14 (pin 19) to force high level during initialization (until it runs here)
  //GP_PTT_OUT follows the PTT_IN, but on power on, it will be = 1 to be RX and after initalization, it will follow PTT_IN
  gpio_init_mask(1<<GP_PTT_OUT);       //init GPIO pin state
  gpio_set_mask(1<<GP_PTT_OUT);        //GPIO14 = 1 = RX (GPIO14 used for PTT CW time extension)
  gpio_set_dir(GP_PTT_OUT, GPIO_OUT);  //GPIO14 = output
  
  //the PTT_IN switch debounce RC time will be defined by the external pullup resistor in parallel with this internal pullup and the external capacitor
  gpio_init_mask(1<<GP_PTT_IN);       //init GPIO pin state
  gpio_pull_up(GP_PTT_IN);            // internal PTT pullup (about 50k ohms + external 10k ohms + 100nF for aprox 1ms debounce)
  gpio_set_dir(GP_PTT_IN, GPIO_IN);   // PTT input (just to confirm) - true for out, false for in 



    //Serialx.println("uSDR_setup   Wire.begin");
	/*
	 * i2c0 is used for the si5351 interface
	 * i2c1 is used for the LCD and all other interfaces
	 */
#if TX_METHOD == I_Q_QSE   //original project
  //Earle Philhower core: I2C pins chosen here by code (with MBED core it was done editing pins_arduino.h)
  Wire.setSDA(16);         //i2c0 SDA = GP16
  Wire.setSCL(17);         //i2c0 SCL = GP17
  Wire.begin();            //i2c0 master to Si5351
  //Wire.setClock(200000);   // Set i2c0 clock speed (default=100k)
#endif
  //Wire1 used on both TX_METHODs
  Wire1.setSDA(18);        //i2c1 SDA = GP18
  Wire1.setSCL(19);        //i2c1 SCL = GP19
  Wire1.begin();           //i2c1   used for switching band and atten/LNA
  //Wire1.setTimeout(1000);  // sets maximum milliseconds to wait for stream data, default is 1 second

/*
  //TFT_eSPI will initializate the SPI1 with SPI1.begin() using the GPIO14 and GPIO15 as default (pins_arduino.h).
  //I am setting the SPI1 pins with the same as Setup60_RP2040_ILI9341.h, to free the GPIO14 and GPIO15
  SPI1.setTX(11);    // MOSI 
  SPI1.setRX(12);    // MISO  (with SS/CS not selected, this pin is tri-state)
  SPI1.setSCK(10);   // SCK
  SPI1.setCS(13);    // SS/CS
*/
  display_tft_setup0();
}



void uSDR_setup(void)  //main
{
  //gpio_init_mask(1<<14);  
  //gpio_set_dir(14, GPIO_OUT); 
  
  //Serialx.println("hmi_init0");
  //hmi_init0();    //MOVED to Arduino_uSDX_Pico_FFT.ino setup(): reads the eeprom memories and shows how many on initial display
  //                //must run after Wire1.begin() (uSDR_setup0) and after Pro Mini finish its setup switching relays
 
	/* Initialize units */
  //Serialx.println("uSDR_setup   mon_init");
	mon_init();										// Monitor shell on stdio
  //Serialx.println("uSDR_setup   si_init");
	si_init();										// VFO control unit
  //Serialx.println("uSDR_setup   relay_init");
	relay_init();
  //Serialx.println("uSDR_setup   display_tft_setup");
  display_tft_setup();   //moved to setup0 to write into display from the beggining
  //Serialx.println("uSDR_setup   hmi_init");
	hmi_init();										// HMI user inputs
  //Serialx.println("uSDR_setup   dsp_init");
  dsp_init();                   // Signal processing unit

  tim_loc = tim_count;          // local time for main loop
  //digitalWrite(14, LOW);
}




void uSDR_loop(void)
{ 

  if((uint16_t)(tim_count - tim_loc) >= (uint16_t)LOOP_MS)  //run the tasks every 100ms  (LOOP_MS = 100)
  {
    hmi_evaluate();               // Refresh HMI
    si_evaluate();                // Refresh VFO settings
    mon_evaluate();               // Check monitor input
    dsp_loop();  //spend more time here for FFT and graphic
    display_tft_loop();           // Refresh display
    //it takes 50ms for the tasks (most in hmi_evaluate() to plot the waterfall)
    
    tim_loc += LOOP_MS;
  }

}
