kaefe64/Arduino_uSDX_Pico_FFT_Proj/Arduino_uSDX_Pico_FFT/CwDecoder.h

#ifndef __CWDECODER_H__
#define __CWDECODER_H__

#ifdef __cplusplus
extern "C" {
#endif

/* 
 * CwDecoder.h
 *
 * Created: Oct 2024
 * Author: Klaus Fensterseifer
 *
 * See CwDecoder.c for more information 
 */



#define  MAX_CW_RX_CNT  40   // 40 * 
#define  MAX_CW_RX_INDEX  40   // 40 * 
extern uint16_t cw_rx[MAX_CW_RX_INDEX][2];
extern uint16_t cw_rx_array;
extern uint16_t cw_rx_index;
extern uint32_t cw_rx_avg;
extern uint16_t cw_rx_cnt;

void CwDecoder_InicTable(void);
void CwDecoder_Inic(void);
void CwDecoder_Exit(void);
void CwDecoder_array_in(void);
void CwDecoder_Loop(void);

void wpm_up(void);    //manual: cw decoder faster
void wpm_down(void);  //manual: cw decoder slower

#ifdef __cplusplus
}
#endif
#endif
