kaefe64/Arduino_uSDX_Pico_FFT_Proj/Arduino_uSDX_Pico_FFT/Eeprom.h

#ifndef __EEPROM_H__
#define __EEPROM_H__

#ifdef __cplusplus
extern "C" {
#endif


//#define Eeprom_debug    10


void Eeprom_Save_Band(uint8_t actual_mem, uint8_t save_mem);

uint8_t Eeprom_setup(void);
void Eeprom_loop(void);











#ifdef __cplusplus
}
#endif
#endif
