kaefe64/Arduino_uSDX_Pico_FFT_Proj/Arduino_uSDX_Pico_FFT/relay.cpp

/*
 * relay.cpp
 *
 * Created: Nov 2021
 * Author: Arjan te Marvelde
 * May2022: adapted by Klaus Fensterseifer 
 * https://github.com/kaefe64/Arduino_uSDX_Pico_FFT_Proj
 * 
 * Two PCF8574 expanders are on the I2C bus, one on the RX and one on the BPF board.
 * The RX (0x42) bit assignments:
 *  0: Enable -20dB attenuator
 *  1: Enable -10dB attenuator
 *  2: Enable +10dB pre-amplifier
 * The BPF (0x40) bit assignments:
 *  0: Enable LPF  2.5 MHz
 *  1: Enable BPF  2.0 - 6.0 MHz
 *  2: Enable BPF  5.0 -12.0 MHz
 *  3: Enable BPF 10.0 -24.0 MHz
 *  4: Enable BPF 20.0 -40.0 MHz
 * 
 */
/* 
#include <stdio.h>
#include <string.h>
#include "pico/stdlib.h"
#include "hardware/i2c.h"
*/
#include "Arduino.h"
#include "hardware/i2c.h"
/*
#include "SPI.h"
#include "TFT_eSPI.h"
//#include "display.h"
//#include "kiss_fftr.h"
//#include "adc_fft.h"
#include "dma.h"
#include "pwm.h"
#include "adc.h"
#include "irq.h"
#include "time.h"
#include "multicore.h"
*/

#include "relay.h"
#include "uSDR.h"




void relay_setband(uint8_t val)
{
	uint8_t data[2];
	//int ret;
	
	data[0] = val&0x1f;
//	if (i2c_write_blocking(i2c1, I2C_BPF, data, 1, false) < 0)
	if (i2c_write_timeout_us(i2c1, I2C_BPF, data, 1, false, I2C_TIMEOUT_us) < 0)
//		i2c_write_blocking(i2c1, I2C_BPF, data, 1, false);
		i2c_write_timeout_us(i2c1, I2C_BPF, data, 1, false, I2C_TIMEOUT_us);
}

int relay_getband(void)
{
	uint8_t data[2];
	int ret;
	
	ret = i2c_read_blocking(i2c1, I2C_BPF, data, 1, false);
	if (ret>=0) 
		ret=data[0];
	return(ret);
}



void relay_setattn(uint8_t val)
{
	uint8_t data[2];
	
	data[0] = val&0x07;
  //Serialx.println("relay_setattn  i2c_write_blocking  start");
  //int i2c_write_blocking (i2c_inst_t *i2c, uint8_t addr, const uint8_t *src, size_t len, bool nostop). 
	//if (i2c_write_blocking(i2c1, I2C_RX, data, 1, false) < 0)  // true to keep master control of bus
	if (i2c_write_timeout_us(i2c1, I2C_RX, data, 1, false, I2C_TIMEOUT_us) < 0)  // true to keep master control of bus
    {
    //Serialx.println("relay_setattn  i2c_write_blocking  if <0");  // false, we're done writing
		i2c_write_timeout_us(i2c1, I2C_RX, data, 1, false, I2C_TIMEOUT_us);
    }    
  //Serialx.println("relay_setattn  i2c_write_blocking  end");  // false, we're done writing
}

int relay_getattn(void)
{
	uint8_t data[2];
	int ret;
	
	ret = i2c_read_blocking(i2c1, I2C_RX, data, 1, false);
	if (ret>=0) 
		ret=data[0];
	return(ret);
}

void relay_init(void)
{ 
/*  done at hmi_init()
	relay_setattn(REL_PRE_10);
	sleep_ms(1);
	relay_setband(REL_BPF12);
*/ 
}
