kaefe64/Arduino_uSDX_Pico_FFT_Proj/Arduino_uSDX_Pico_FFT/monitor.h

#ifndef __MONITOR_H__
#define __MONITOR_H__

#ifdef __cplusplus
extern "C" {
#endif

/* 
 * monitor.h
 *
 * Created: Mar 2021
 * Author: Arjan te Marvelde
 *
 * See monitor.c for more information 
 */

void mon_init();
void mon_evaluate(void);

#ifdef __cplusplus
}
#endif
#endif
