kaefe64/Arduino_uSDX_Pico_FFT_Proj/(commit log)

2022-05-27 Initial import
    [Senos FFT.xlsx, leitura fft samp.xlsx]
2022-05-30 Update README.md
    Including Hardware. Arduino IDE setup and To do list
2022-05-30 including comments for Wire pins setup
2022-05-31 including more comments for Wire pins setup
2022-05-31 including video and board
2022-06-03 correcting Wire1 mod
2022-06-19 Audio samples gain fixed in 10x to avoid variable overflow
    [display_tft.cpp, display_tft.h, dsp.cpp, dsp.h]
2022-06-24 Display central triangle and mode text overwriting corrections
    [display_tft.cpp, dsp.cpp, hmi.cpp]
2022-08-05 Included CW filter @8kHz, CW side tone Included AM filter
2022-08-05 Included PTT 100n cap 5V to Si5351
2022-08-06 Correcting PTT pin read (now using fall and rise)
    [hmi.cpp]
2022-08-07 Included encoder options
2022-08-07 Including encoder selection
2022-08-07 Correcting encoder comment
2022-08-11 Correction to allow SSB and AM mode transmission.
    [dsp.cpp]
2022-08-11 Increasing 1kHz on AM low pass filter bandwidth
2022-08-24 Switch OFF the carrier when MIC audio is LOW
2022-09-10 Compiler warnings corrections First step to include the TX_METHOD PHASE_AMPLITUDE
    [dsp.cpp]
2022-09-10 Compiler warnings corrections First step to include the TX_METHOD PHASE_AMPLITUDE Tests to write the Menu state on Flash memory
    [hmi.cpp]
2022-09-10 120mA @ 5V power supply
2022-09-16 Serial not blocking to run Changing sample frequency to be close to the main project Removing unsigned to test LSB
2022-09-23 PCB Schematic included
2023-06-02 Including code for Arduino Pro Mini as I2C Slave It will work in the place of the two PCF8574
2023-06-02 BPF and RX schematic to use with Arduino ProMini
2023-06-13 Fixing comments and code rearange
    [Arduino_I2C_BPF_RX.ino]
2023-07-16 Adjust of local oscillator frequency for zero beat on reception (just PY2KLA_setup)
    [si5351.cpp]
2023-07-16 adjust/print the manual gain to screen
2023-07-16 print the Band to the screen
2023-07-16 Change the audio 16kHz lp filter from average to FIR 4kHz (to avoid hear strong stations away multiples of 16kHz) Reducing AM lp filter from 5kHz to 4kHz (to be compatible with the new 16kHz FIR)
    [dsp.cpp, dsp.h]
2023-07-19 Correcting the relays coil positive pin
2023-07-19 Correcting components values to be similar to my assembly Some extra changes included in text boxes
2023-07-19 Including relay info
2023-07-19 Including PCBs info
2023-07-20 Schematic updated with the PCB manual changes (including components)
2023-07-28 Including SSB filter option on the code
2023-10-13 New initial display printout
2023-10-13 Improving receiver filter and mic audio compress
2023-10-13 Changing i2c_writing from blocking to timeout to avoid blocking without I2C slave connected
    [relay.cpp]
2023-10-13 Removing unecessary serial prints
2023-10-13 Correcting serial and serial1 comments
    [uSDR.h]
2023-11-05 First prototype TX and RX
2023-11-05 Including prototype picture
2023-11-05 Pico label
2023-11-12 VOX to TX on PTT pin
2024-01-05 Correction for PTT activation
    [monitor.cpp]
2024-01-27 including SWR single side PCB
2024-01-27 Including SWR PCB and minor adjusts
2024-01-27 new pictures prototype 2
2024-01-27 Mods SCH and PCB version 1 New pictures Prototype 2
2024-08-20 Including Waterfall moving in block. S Meter corrections.
    [display_tft.cpp, display_tft.h, hmi.cpp, si5351.h]
2024-08-26 Changing inital circuit
2024-08-26 Changing initial circuit
2024-10-23 Correcting I2C routines
2024-10-23 Including SWR reading from Arduino Pro Mini ADC read
2024-10-31 Correcting serial interface name: Serial1 or SerialUSB Correcting the default frequency when memory is empty
    [hmi.cpp, hmi.h, uSDR.cpp, uSDR.h]
2024-11-25 Improving CW Decoder. Setting the FFT gain = 16 from the reset (it was 8).
    [dsp.cpp]
2025-12-06 Including I2C commands to eeprom read/write
2025-12-08 Normalize file permissions to 644
    [Senos FFT.xlsx, leitura fft samp.xlsx]
2025-12-08 Includinh a separate header file for the filters parameters
2025-12-08 Correcting init test time
    [Arduino_I2C_BPF_RX.ino]
2026-01-03 Correcting commands for Eeprom access
    [Arduino_I2C_BPF_RX.ino]
2026-01-03 Including memory feature with Arduino Pro Mini eeprom.
2026-01-04 Including 2 diodes on display power supply (it would be better to use a 3v3 linear regulator)
2026-01-04 Including diodes on display power supply (it would be better to use a 3v3 linear regulator)
2026-01-04 Including comment about display with 5v to 3v3 regulator
2026-01-04 Returning the display power supply to 5V (it is correct)
2026-01-04 Including files
    [LM317_regulator.ods, TEA1025_Gain.ods]
2026-01-04 mudando para Aux
    [Senos FFT.xlsx]
2026-01-04 Moving to Aux
    [leitura fft samp.xlsx]
2026-01-18 Adding comment 3-12V
2026-08-23 Changing to Earle Philhovwer Library. Correcting ADc sample rate. Showing the number of memories read after reset.
    [Arduino_uSDX_Pico_FFT.ino, Eeprom.cpp, Eeprom.h, display_tft.cpp, display_tft.h, dsp.cpp, dsp.h, hmi.cpp]
2026-08-24 Including PTT CW time extension circuit
2026-08-25 Changing PTT CW schematic
2026-09-24 Including PTT CW tx time extension circuit
2026-10-04 Improving and correcting the CW decoder procedure
    [CwDecoder.cpp, CwDecoder.h]
2026-10-07 Corrections: U3 not used, U4 pin 7 not connected to Gnd.
